amirmat98/Capacitive-Level-Meter-Sensor/Solid/CounterWeight/20210627_121346.jpg

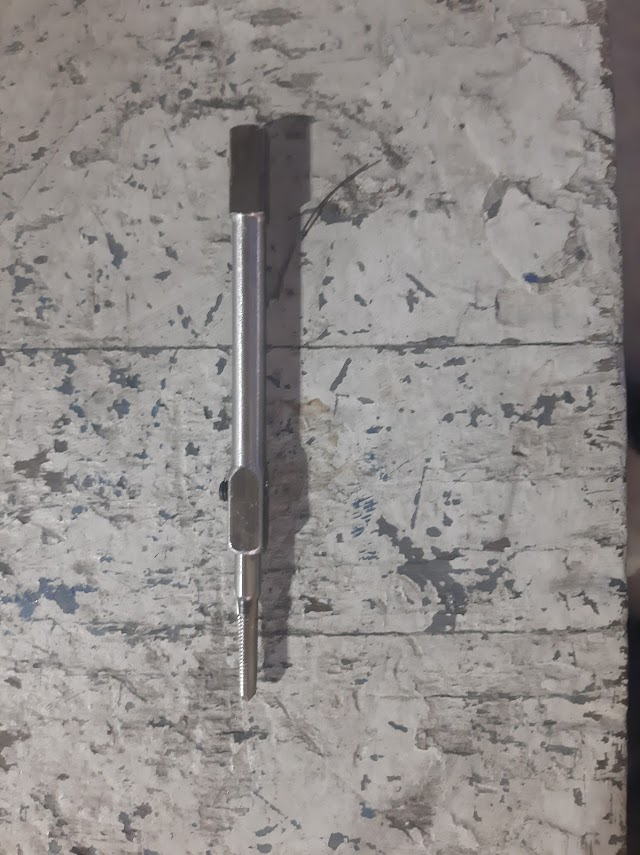
Solid/CounterWeight/20210627_121346.jpg
