amirmat98/Capacitive-Level-Meter-Sensor/README.md

# Capacitive-Level-Meter-Sensor
Design and Implementation of Capacitive Level Meter Sensor - Bachelor's thesis
