amirmat98/Capacitive-Level-Meter-Sensor/Solid/CounterWeight/Untitled-1.png

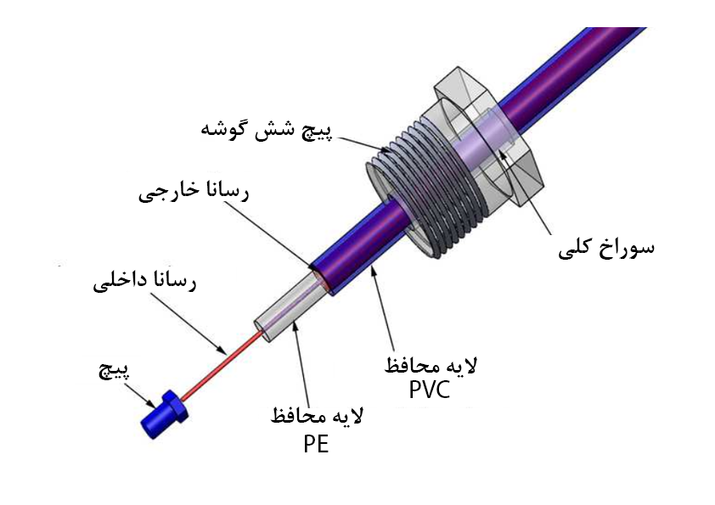
Solid/CounterWeight/Untitled-1.png
