amirmat98/Capacitive-Level-Meter-Sensor/Solid/CounterWeight/Untitled-2.png

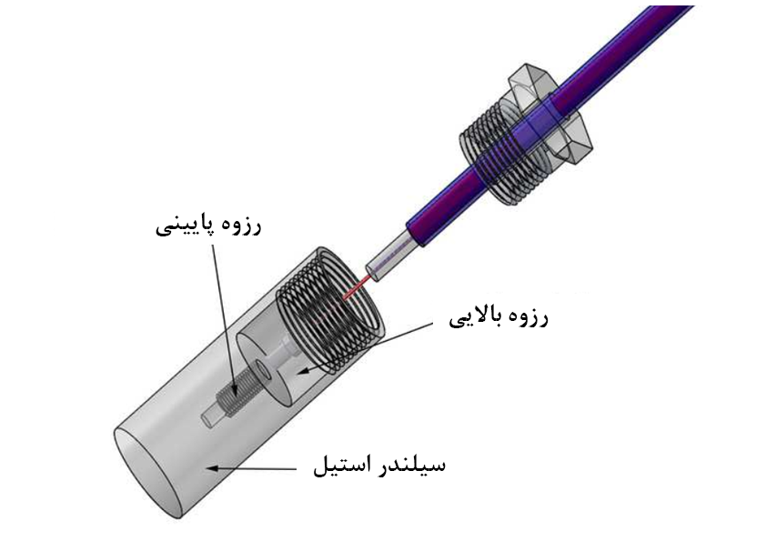
Solid/CounterWeight/Untitled-2.png
