amirmat98/Capacitive-Level-Meter-Sensor/Solid/CounterWeight/Untitled-3.png

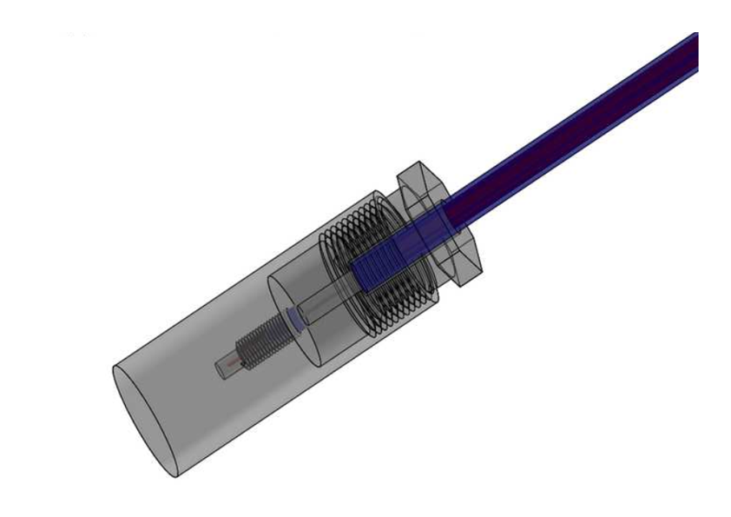
Solid/CounterWeight/Untitled-3.png
