amirmat98/Capacitive-Level-Meter-Sensor/Main_PCB_V1/Project Outputs for Main_PCB/BOM/PCB4.png

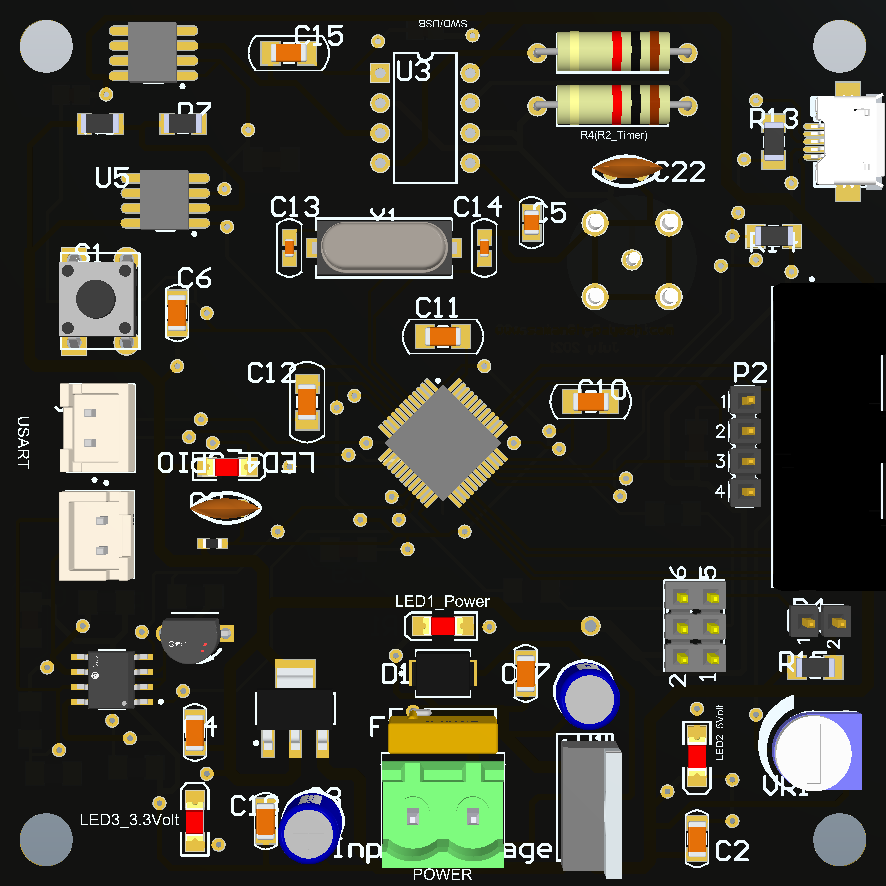
Main_PCB_V1/Project Outputs for Main_PCB/BOM/PCB4.png
