amirmat98/Capacitive-Level-Meter-Sensor/Solid/CounterWeight/Assem.SLDASM

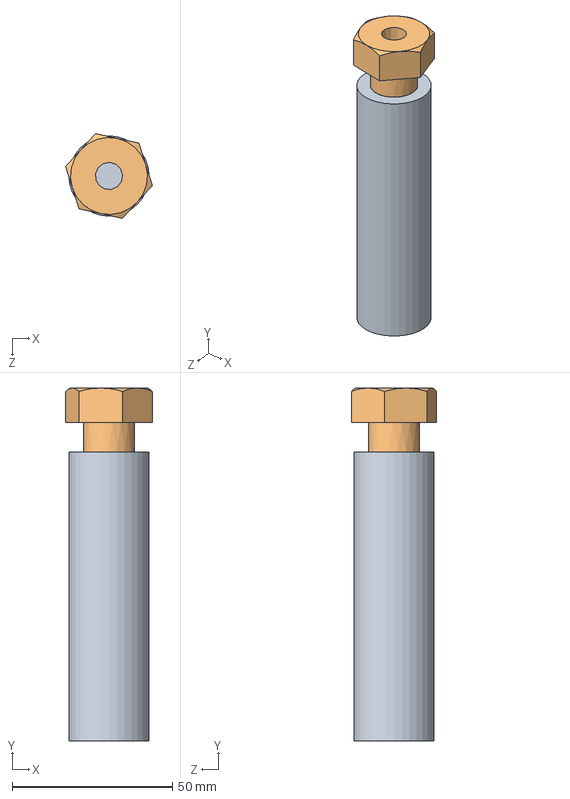
[picture p6: CAD file, 2024-11-14]
Solid/CounterWeight/Assem.SLDASM
27.1 x 110.0 x 26.4 mm
Screw
