amirmat98/Capacitive-Level-Meter-Sensor/Solid/3D_Print_Case/Body-version2.STEP

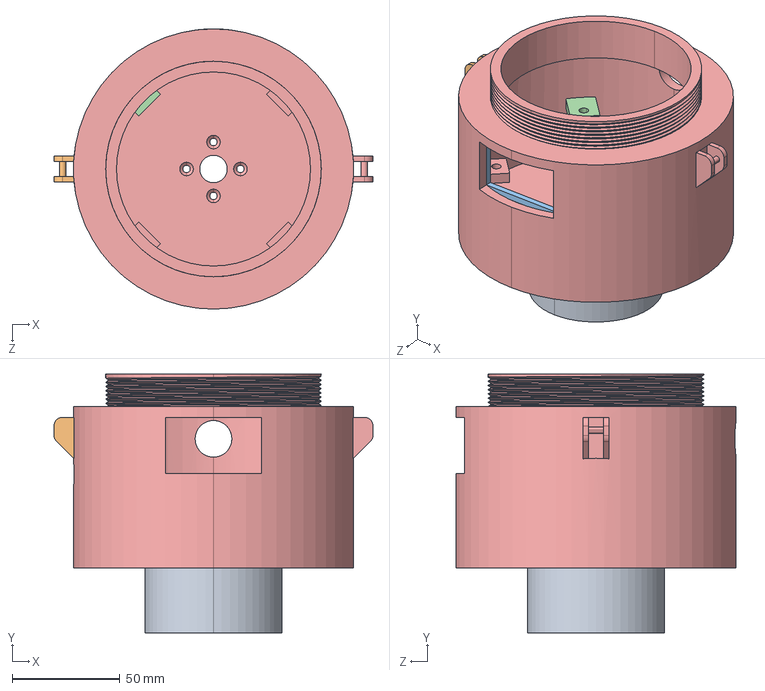
[picture p7: CAD file, 2024-11-14]
Solid/3D_Print_Case/Body-version2.STEP
148.0 x 120.0 x 130.0 mm
