amirmat98/Capacitive-Level-Meter-Sensor/Solid/CounterWeight/Body.SLDPRT

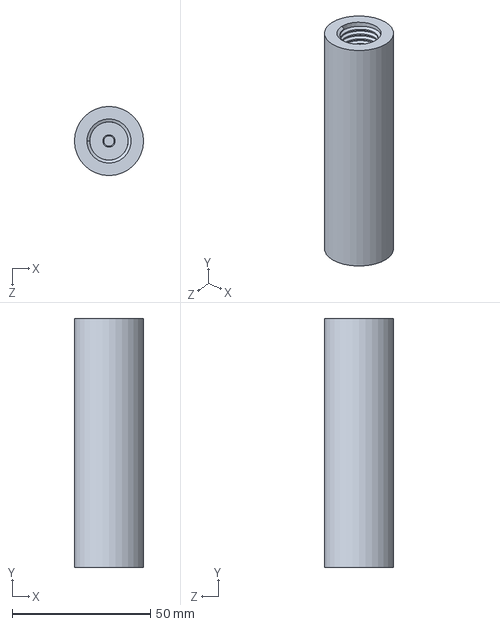
[picture p8: CAD file, 2024-11-14]
Solid/CounterWeight/Body.SLDPRT
25.0 x 90.0 x 25.0 mm
