amirmat98/Capacitive-Level-Meter-Sensor/Solid/3D_Print_Case/BodyCap-version2.STEP

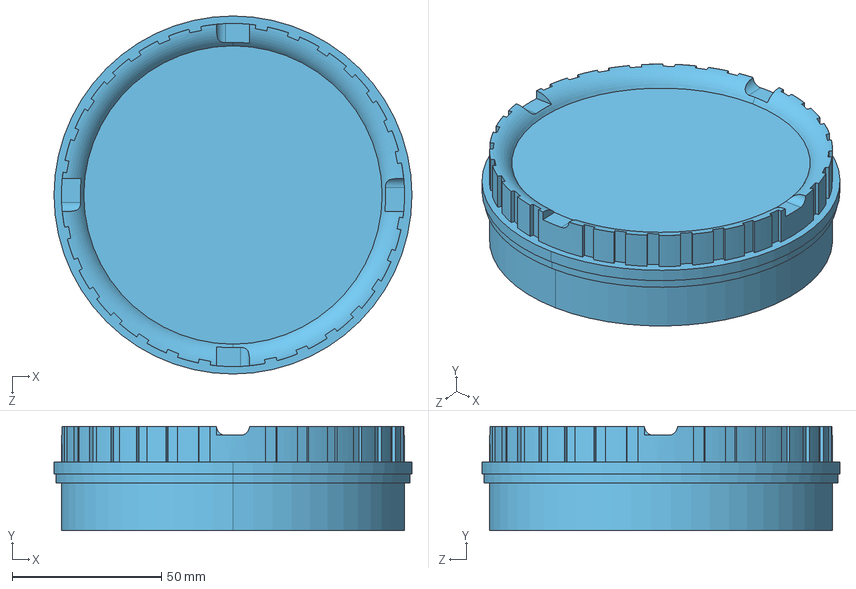
[picture p9: CAD file, 2024-11-14]
Solid/3D_Print_Case/BodyCap-version2.STEP
120.0 x 35.0 x 120.0 mm
