amirmat98/Capacitive-Level-Meter-Sensor/Solid/CounterWeight/Screw.SLDPRT

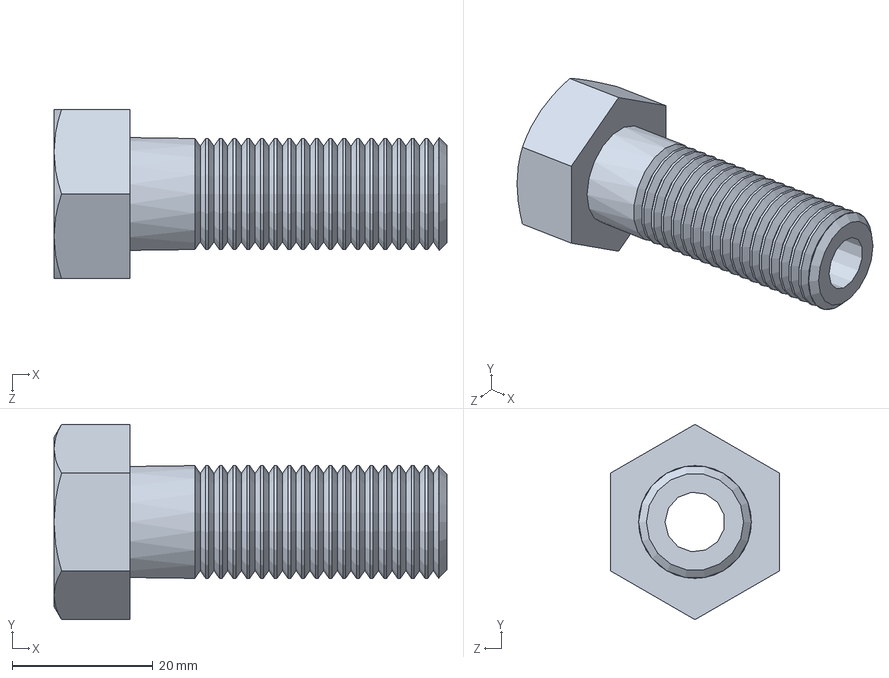
[picture p10: CAD file, 2024-11-14]
Solid/CounterWeight/Screw.SLDPRT
55.8 x 27.7 x 24.0 mm
