amirmat98/Capacitive-Level-Meter-Sensor/Solid/CounterWeight/Hex_Bolt.SLDPRT

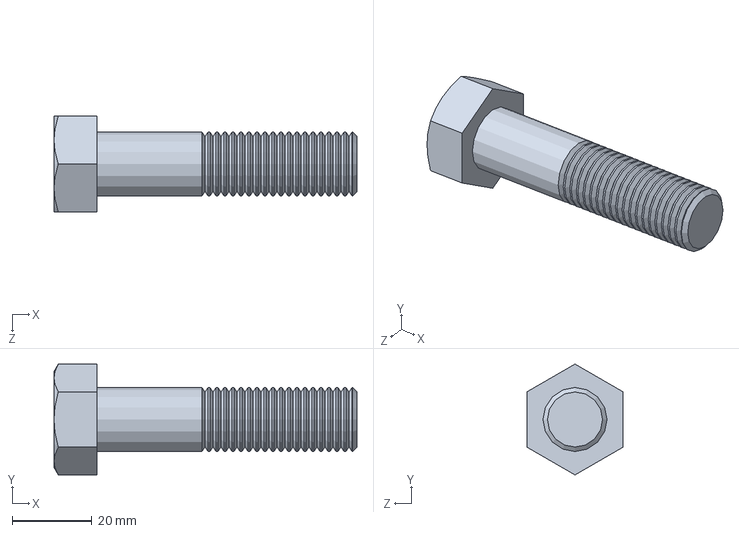
[picture p11: CAD file, 2024-11-14]
Solid/CounterWeight/Hex_Bolt.SLDPRT
75.8 x 27.7 x 24.0 mm
