amirmat98/Capacitive-Level-Meter-Sensor/(list of files, cad)

Other CAD files:
Solid/3D_Print_Case/Body-version2.SLDDRW
Solid/3D_Print_Case/Body-version2.SLDPRT
Solid/3D_Print_Case/Body-version2.STL
Solid/3D_Print_Case/BodyCap-version2.SLDDRW
Solid/3D_Print_Case/BodyCap-version2.SLDPRT
Solid/3D_Print_Case/BodyCap-version2.STL
Solid/CounterWeight/Body.SLDDRW
Solid/CounterWeight/Screw.SLDDRW
