amirmat98/Capacitive-Level-Meter-Sensor/ARM_code/Main_Test/MDK-ARM/Main_Test/Main_Test.htm

# Static Call Graph for image Main_Test\Main_Test.axf

#<CALLGRAPH># ARM Linker, 5060960: Last Updated: Sun Aug 01 12:32:45 2021

### Maximum Stack Usage = 136 bytes + Unknown(Cycles, Untraceable Function Pointers)

### Call chain for Maximum Stack Depth:

main ⇒ SystemClock_Config ⇒ HAL_RCC_ClockConfig ⇒ HAL_InitTick ⇒ HAL_NVIC_SetPriority

### Mutually Recursive functions

- ADC1_2_IRQHandler ⇒ ADC1_2_IRQHandler
- BusFault_Handler ⇒ BusFault_Handler
- HardFault_Handler ⇒ HardFault_Handler
- MemManage_Handler ⇒ MemManage_Handler
- NMI_Handler ⇒ NMI_Handler
- UsageFault_Handler ⇒ UsageFault_Handler
- qsort ⇒ qsort

### Function Pointers

- ADC1_2_IRQHandler from startup_stm32f103xb.o(.text) referenced from startup_stm32f103xb.o(RESET)
- BusFault_Handler from stm32f1xx_it.o(i.BusFault_Handler) referenced from startup_stm32f103xb.o(RESET)
- CAN1_RX1_IRQHandler from startup_stm32f103xb.o(.text) referenced from startup_stm32f103xb.o(RESET)
- CAN1_SCE_IRQHandler from startup_stm32f103xb.o(.text) referenced from startup_stm32f103xb.o(RESET)
- DMA1_Channel1_IRQHandler from startup_stm32f103xb.o(.text) referenced from startup_stm32f103xb.o(RESET)
- DMA1_Channel2_IRQHandler from startup_stm32f103xb.o(.text) referenced from startup_stm32f103xb.o(RESET)
- DMA1_Channel3_IRQHandler from startup_stm32f103xb.o(.text) referenced from startup_stm32f103xb.o(RESET)
- DMA1_Channel4_IRQHandler from startup_stm32f103xb.o(.text) referenced from startup_stm32f103xb.o(RESET)
- DMA1_Channel5_IRQHandler from startup_stm32f103xb.o(.text) referenced from startup_stm32f103xb.o(RESET)
- DMA1_Channel6_IRQHandler from startup_stm32f103xb.o(.text) referenced from startup_stm32f103xb.o(RESET)
- DMA1_Channel7_IRQHandler from startup_stm32f103xb.o(.text) referenced from startup_stm32f103xb.o(RESET)
- DebugMon_Handler from stm32f1xx_it.o(i.DebugMon_Handler) referenced from startup_stm32f103xb.o(RESET)
- EXTI0_IRQHandler from startup_stm32f103xb.o(.text) referenced from startup_stm32f103xb.o(RESET)
- EXTI15_10_IRQHandler from startup_stm32f103xb.o(.text) referenced from startup_stm32f103xb.o(RESET)
- EXTI1_IRQHandler from startup_stm32f103xb.o(.text) referenced from startup_stm32f103xb.o(RESET)
- EXTI2_IRQHandler from startup_stm32f103xb.o(.text) referenced from startup_stm32f103xb.o(RESET)
- EXTI3_IRQHandler from startup_stm32f103xb.o(.text) referenced from startup_stm32f103xb.o(RESET)
- EXTI4_IRQHandler from startup_stm32f103xb.o(.text) referenced from startup_stm32f103xb.o(RESET)
- EXTI9_5_IRQHandler from startup_stm32f103xb.o(.text) referenced from startup_stm32f103xb.o(RESET)
- FLASH_IRQHandler from startup_stm32f103xb.o(.text) referenced from startup_stm32f103xb.o(RESET)
- HardFault_Handler from stm32f1xx_it.o(i.HardFault_Handler) referenced from startup_stm32f103xb.o(RESET)
- I2C1_ER_IRQHandler from startup_stm32f103xb.o(.text) referenced from startup_stm32f103xb.o(RESET)
- I2C1_EV_IRQHandler from startup_stm32f103xb.o(.text) referenced from startup_stm32f103xb.o(RESET)
- I2C2_ER_IRQHandler from startup_stm32f103xb.o(.text) referenced from startup_stm32f103xb.o(RESET)
- I2C2_EV_IRQHandler from startup_stm32f103xb.o(.text) referenced from startup_stm32f103xb.o(RESET)
- MemManage_Handler from stm32f1xx_it.o(i.MemManage_Handler) referenced from startup_stm32f103xb.o(RESET)
- NMI_Handler from stm32f1xx_it.o(i.NMI_Handler) referenced from startup_stm32f103xb.o(RESET)
- PVD_IRQHandler from startup_stm32f103xb.o(.text) referenced from startup_stm32f103xb.o(RESET)
- PendSV_Handler from stm32f1xx_it.o(i.PendSV_Handler) referenced from startup_stm32f103xb.o(RESET)
- RCC_IRQHandler from startup_stm32f103xb.o(.text) referenced from startup_stm32f103xb.o(RESET)
- RTC_Alarm_IRQHandler from startup_stm32f103xb.o(.text) referenced from startup_stm32f103xb.o(RESET)
- RTC_IRQHandler from startup_stm32f103xb.o(.text) referenced from startup_stm32f103xb.o(RESET)
- Reset_Handler from startup_stm32f103xb.o(.text) referenced from startup_stm32f103xb.o(RESET)
- SPI1_IRQHandler from startup_stm32f103xb.o(.text) referenced from startup_stm32f103xb.o(RESET)
- SPI2_IRQHandler from startup_stm32f103xb.o(.text) referenced from startup_stm32f103xb.o(RESET)
- SVC_Handler from stm32f1xx_it.o(i.SVC_Handler) referenced from startup_stm32f103xb.o(RESET)
- SysTick_Handler from stm32f1xx_it.o(i.SysTick_Handler) referenced from startup_stm32f103xb.o(RESET)
- SystemInit from system_stm32f1xx.o(i.SystemInit) referenced from startup_stm32f103xb.o(.text)
- TAMPER_IRQHandler from startup_stm32f103xb.o(.text) referenced from startup_stm32f103xb.o(RESET)
- TIM1_BRK_IRQHandler from startup_stm32f103xb.o(.text) referenced from startup_stm32f103xb.o(RESET)
- TIM1_CC_IRQHandler from startup_stm32f103xb.o(.text) referenced from startup_stm32f103xb.o(RESET)
- TIM1_TRG_COM_IRQHandler from startup_stm32f103xb.o(.text) referenced from startup_stm32f103xb.o(RESET)
- TIM1_UP_IRQHandler from startup_stm32f103xb.o(.text) referenced from startup_stm32f103xb.o(RESET)
- TIM2_IRQHandler from stm32f1xx_it.o(i.TIM2_IRQHandler) referenced from startup_stm32f103xb.o(RESET)
- TIM3_IRQHandler from startup_stm32f103xb.o(.text) referenced from startup_stm32f103xb.o(RESET)
- TIM4_IRQHandler from startup_stm32f103xb.o(.text) referenced from startup_stm32f103xb.o(RESET)
- USART1_IRQHandler from startup_stm32f103xb.o(.text) referenced from startup_stm32f103xb.o(RESET)
- USART2_IRQHandler from startup_stm32f103xb.o(.text) referenced from startup_stm32f103xb.o(RESET)
- USART3_IRQHandler from startup_stm32f103xb.o(.text) referenced from startup_stm32f103xb.o(RESET)
- USBWakeUp_IRQHandler from startup_stm32f103xb.o(.text) referenced from startup_stm32f103xb.o(RESET)
- USB_HP_CAN1_TX_IRQHandler from startup_stm32f103xb.o(.text) referenced from startup_stm32f103xb.o(RESET)
- USB_LP_CAN1_RX0_IRQHandler from startup_stm32f103xb.o(.text) referenced from startup_stm32f103xb.o(RESET)
- UsageFault_Handler from stm32f1xx_it.o(i.UsageFault_Handler) referenced from startup_stm32f103xb.o(RESET)
- WWDG_IRQHandler from startup_stm32f103xb.o(.text) referenced from startup_stm32f103xb.o(RESET)
- __main from entry.o(.ARM.Collect$$$$00000000) referenced from startup_stm32f103xb.o(.text)
- cmpfunc from main.o(i.cmpfunc) referenced from main.o(i.main)
- fputc from main.o(i.fputc) referenced from printfa.o(i.__0printf)
- main from main.o(i.main) referenced from entry9a.o(.ARM.Collect$$$$0000000B)

### Global Symbols

__main (Thumb, 0 bytes, Stack size unknown bytes, entry.o(.ARM.Collect$$$$00000000))
[Address Reference Count : 1]

- startup_stm32f103xb.o(.text)

_main_stk (Thumb, 0 bytes, Stack size unknown bytes, entry2.o(.ARM.Collect$$$$00000001))

_main_scatterload (Thumb, 0 bytes, Stack size unknown bytes, entry5.o(.ARM.Collect$$$$00000004))

[Calls]

- >> __scatterload

__main_after_scatterload (Thumb, 0 bytes, Stack size unknown bytes, entry5.o(.ARM.Collect$$$$00000004))

[Called By]

- >> __scatterload

_main_clock (Thumb, 0 bytes, Stack size unknown bytes, entry7b.o(.ARM.Collect$$$$00000008))

_main_cpp_init (Thumb, 0 bytes, Stack size unknown bytes, entry8b.o(.ARM.Collect$$$$0000000A))

_main_init (Thumb, 0 bytes, Stack size unknown bytes, entry9a.o(.ARM.Collect$$$$0000000B))

__rt_lib_shutdown_fini (Thumb, 0 bytes, Stack size unknown bytes, entry12b.o(.ARM.Collect$$$$0000000E))

__rt_final_cpp (Thumb, 0 bytes, Stack size unknown bytes, entry10a.o(.ARM.Collect$$$$0000000F))

__rt_final_exit (Thumb, 0 bytes, Stack size unknown bytes, entry11a.o(.ARM.Collect$$$$00000011))

Reset_Handler (Thumb, 8 bytes, Stack size 0 bytes, startup_stm32f103xb.o(.text))
[Address Reference Count : 1]

- startup_stm32f103xb.o(RESET)

ADC1_2_IRQHandler (Thumb, 0 bytes, Stack size 0 bytes, startup_stm32f103xb.o(.text))

[Calls]

- >> ADC1_2_IRQHandler

[Called By]

- >> ADC1_2_IRQHandler

[Address Reference Count : 1]

- startup_stm32f103xb.o(RESET)

CAN1_RX1_IRQHandler (Thumb, 0 bytes, Stack size 0 bytes, startup_stm32f103xb.o(.text))
[Address Reference Count : 1]

- startup_stm32f103xb.o(RESET)

CAN1_SCE_IRQHandler (Thumb, 0 bytes, Stack size 0 bytes, startup_stm32f103xb.o(.text))
[Address Reference Count : 1]

- startup_stm32f103xb.o(RESET)

DMA1_Channel1_IRQHandler (Thumb, 0 bytes, Stack size 0 bytes, startup_stm32f103xb.o(.text))
[Address Reference Count : 1]

- startup_stm32f103xb.o(RESET)

DMA1_Channel2_IRQHandler (Thumb, 0 bytes, Stack size 0 bytes, startup_stm32f103xb.o(.text))
[Address Reference Count : 1]

- startup_stm32f103xb.o(RESET)

DMA1_Channel3_IRQHandler (Thumb, 0 bytes, Stack size 0 bytes, startup_stm32f103xb.o(.text))
[Address Reference Count : 1]

- startup_stm32f103xb.o(RESET)

DMA1_Channel4_IRQHandler (Thumb, 0 bytes, Stack size 0 bytes, startup_stm32f103xb.o(.text))
[Address Reference Count : 1]

- startup_stm32f103xb.o(RESET)

DMA1_Channel5_IRQHandler (Thumb, 0 bytes, Stack size 0 bytes, startup_stm32f103xb.o(.text))
[Address Reference Count : 1]

- startup_stm32f103xb.o(RESET)

DMA1_Channel6_IRQHandler (Thumb, 0 bytes, Stack size 0 bytes, startup_stm32f103xb.o(.text))
[Address Reference Count : 1]

- startup_stm32f103xb.o(RESET)

DMA1_Channel7_IRQHandler (Thumb, 0 bytes, Stack size 0 bytes, startup_stm32f103xb.o(.text))
[Address Reference Count : 1]

- startup_stm32f103xb.o(RESET)

EXTI0_IRQHandler (Thumb, 0 bytes, Stack size 0 bytes, startup_stm32f103xb.o(.text))
[Address Reference Count : 1]

- startup_stm32f103xb.o(RESET)

EXTI15_10_IRQHandler (Thumb, 0 bytes, Stack size 0 bytes, startup_stm32f103xb.o(.text))
[Address Reference Count : 1]

- startup_stm32f103xb.o(RESET)

EXTI1_IRQHandler (Thumb, 0 bytes, Stack size 0 bytes, startup_stm32f103xb.o(.text))
[Address Reference Count : 1]

- startup_stm32f103xb.o(RESET)

EXTI2_IRQHandler (Thumb, 0 bytes, Stack size 0 bytes, startup_stm32f103xb.o(.text))
[Address Reference Count : 1]

- startup_stm32f103xb.o(RESET)

EXTI3_IRQHandler (Thumb, 0 bytes, Stack size 0 bytes, startup_stm32f103xb.o(.text))
[Address Reference Count : 1]

- startup_stm32f103xb.o(RESET)

EXTI4_IRQHandler (Thumb, 0 bytes, Stack size 0 bytes, startup_stm32f103xb.o(.text))
[Address Reference Count : 1]

- startup_stm32f103xb.o(RESET)

EXTI9_5_IRQHandler (Thumb, 0 bytes, Stack size 0 bytes, startup_stm32f103xb.o(.text))
[Address Reference Count : 1]

- startup_stm32f103xb.o(RESET)

FLASH_IRQHandler (Thumb, 0 bytes, Stack size 0 bytes, startup_stm32f103xb.o(.text))
[Address Reference Count : 1]

- startup_stm32f103xb.o(RESET)

I2C1_ER_IRQHandler (Thumb, 0 bytes, Stack size 0 bytes, startup_stm32f103xb.o(.text))
[Address Reference Count : 1]

- startup_stm32f103xb.o(RESET)

I2C1_EV_IRQHandler (Thumb, 0 bytes, Stack size 0 bytes, startup_stm32f103xb.o(.text))
[Address Reference Count : 1]

- startup_stm32f103xb.o(RESET)

I2C2_ER_IRQHandler (Thumb, 0 bytes, Stack size 0 bytes, startup_stm32f103xb.o(.text))
[Address Reference Count : 1]

- startup_stm32f103xb.o(RESET)

I2C2_EV_IRQHandler (Thumb, 0 bytes, Stack size 0 bytes, startup_stm32f103xb.o(.text))
[Address Reference Count : 1]

- startup_stm32f103xb.o(RESET)

PVD_IRQHandler (Thumb, 0 bytes, Stack size 0 bytes, startup_stm32f103xb.o(.text))
[Address Reference Count : 1]

- startup_stm32f103xb.o(RESET)

RCC_IRQHandler (Thumb, 0 bytes, Stack size 0 bytes, startup_stm32f103xb.o(.text))
[Address Reference Count : 1]

- startup_stm32f103xb.o(RESET)

RTC_Alarm_IRQHandler (Thumb, 0 bytes, Stack size 0 bytes, startup_stm32f103xb.o(.text))
[Address Reference Count : 1]

- startup_stm32f103xb.o(RESET)

RTC_IRQHandler (Thumb, 0 bytes, Stack size 0 bytes, startup_stm32f103xb.o(.text))
[Address Reference Count : 1]

- startup_stm32f103xb.o(RESET)

SPI1_IRQHandler (Thumb, 0 bytes, Stack size 0 bytes, startup_stm32f103xb.o(.text))
[Address Reference Count : 1]

- startup_stm32f103xb.o(RESET)

SPI2_IRQHandler (Thumb, 0 bytes, Stack size 0 bytes, startup_stm32f103xb.o(.text))
[Address Reference Count : 1]

- startup_stm32f103xb.o(RESET)

TAMPER_IRQHandler (Thumb, 0 bytes, Stack size 0 bytes, startup_stm32f103xb.o(.text))
[Address Reference Count : 1]

- startup_stm32f103xb.o(RESET)

TIM1_BRK_IRQHandler (Thumb, 0 bytes, Stack size 0 bytes, startup_stm32f103xb.o(.text))
[Address Reference Count : 1]

- startup_stm32f103xb.o(RESET)

TIM1_CC_IRQHandler (Thumb, 0 bytes, Stack size 0 bytes, startup_stm32f103xb.o(.text))
[Address Reference Count : 1]

- startup_stm32f103xb.o(RESET)

TIM1_TRG_COM_IRQHandler (Thumb, 0 bytes, Stack size 0 bytes, startup_stm32f103xb.o(.text))
[Address Reference Count : 1]

- startup_stm32f103xb.o(RESET)

TIM1_UP_IRQHandler (Thumb, 0 bytes, Stack size 0 bytes, startup_stm32f103xb.o(.text))
[Address Reference Count : 1]

- startup_stm32f103xb.o(RESET)

TIM3_IRQHandler (Thumb, 0 bytes, Stack size 0 bytes, startup_stm32f103xb.o(.text))
[Address Reference Count : 1]

- startup_stm32f103xb.o(RESET)

TIM4_IRQHandler (Thumb, 0 bytes, Stack size 0 bytes, startup_stm32f103xb.o(.text))
[Address Reference Count : 1]

- startup_stm32f103xb.o(RESET)

USART1_IRQHandler (Thumb, 0 bytes, Stack size 0 bytes, startup_stm32f103xb.o(.text))
[Address Reference Count : 1]

- startup_stm32f103xb.o(RESET)

USART2_IRQHandler (Thumb, 0 bytes, Stack size 0 bytes, startup_stm32f103xb.o(.text))
[Address Reference Count : 1]

- startup_stm32f103xb.o(RESET)

USART3_IRQHandler (Thumb, 0 bytes, Stack size 0 bytes, startup_stm32f103xb.o(.text))
[Address Reference Count : 1]

- startup_stm32f103xb.o(RESET)

USBWakeUp_IRQHandler (Thumb, 0 bytes, Stack size 0 bytes, startup_stm32f103xb.o(.text))
[Address Reference Count : 1]

- startup_stm32f103xb.o(RESET)

USB_HP_CAN1_TX_IRQHandler (Thumb, 0 bytes, Stack size 0 bytes, startup_stm32f103xb.o(.text))
[Address Reference Count : 1]

- startup_stm32f103xb.o(RESET)

USB_LP_CAN1_RX0_IRQHandler (Thumb, 0 bytes, Stack size 0 bytes, startup_stm32f103xb.o(.text))
[Address Reference Count : 1]

- startup_stm32f103xb.o(RESET)

WWDG_IRQHandler (Thumb, 0 bytes, Stack size 0 bytes, startup_stm32f103xb.o(.text))
[Address Reference Count : 1]

- startup_stm32f103xb.o(RESET)

__aeabi_llsr (Thumb, 32 bytes, Stack size 0 bytes, llushr.o(.text))

[Called By]

- >> __aeabi_uldivmod
- >> _double_epilogue
- >> __aeabi_d2ulz

_ll_ushift_r (Thumb, 0 bytes, Stack size 0 bytes, llushr.o(.text), UNUSED)

qsort (Thumb, 156 bytes, Stack size 40 bytes, qsort.o(.text))

[Stack]

- Max Depth = 40 + In Cycle
- Call Chain = qsort ⇒ qsort (Cycle)

[Calls]

- >> qsort

[Called By]

- >> main
- >> qsort

__aeabi_memset (Thumb, 14 bytes, Stack size 0 bytes, memseta.o(.text), UNUSED)

[Called By]

- >> _memset$wrapper
- >> __aeabi_memclr

__aeabi_memset4 (Thumb, 0 bytes, Stack size 0 bytes, memseta.o(.text), UNUSED)

__aeabi_memset8 (Thumb, 0 bytes, Stack size 0 bytes, memseta.o(.text), UNUSED)

__aeabi_memclr (Thumb, 4 bytes, Stack size 0 bytes, memseta.o(.text), UNUSED)

[Calls]

- >> __aeabi_memset

__aeabi_memclr4 (Thumb, 0 bytes, Stack size 0 bytes, memseta.o(.text))

[Called By]

- >> SystemClock_Config

__aeabi_memclr8 (Thumb, 0 bytes, Stack size 0 bytes, memseta.o(.text), UNUSED)

_memset$wrapper (Thumb, 18 bytes, Stack size 8 bytes, memseta.o(.text), UNUSED)

[Calls]

- >> __aeabi_memset

__aeabi_fadd (Thumb, 164 bytes, Stack size 16 bytes, fadd.o(.text))

[Stack]

- Max Depth = 20
- Call Chain = __aeabi_fadd ⇒ _float_epilogue

[Calls]

- >> _float_round
- >> _float_epilogue

[Called By]

- >> __aeabi_fsub
- >> __aeabi_frsub

__aeabi_fsub (Thumb, 6 bytes, Stack size 0 bytes, fadd.o(.text))

[Stack]

- Max Depth = 20
- Call Chain = __aeabi_fsub ⇒ __aeabi_fadd ⇒ _float_epilogue

[Calls]

- >> __aeabi_fadd

[Called By]

- >> Calc_Height

__aeabi_frsub (Thumb, 6 bytes, Stack size 0 bytes, fadd.o(.text), UNUSED)

[Calls]

- >> __aeabi_fadd

__aeabi_fmul (Thumb, 100 bytes, Stack size 8 bytes, fmul.o(.text))

[Stack]

- Max Depth = 8
- Call Chain = __aeabi_fmul

[Called By]

- >> Calc_Height

__aeabi_fdiv (Thumb, 124 bytes, Stack size 8 bytes, fdiv.o(.text))

[Stack]

- Max Depth = 8
- Call Chain = __aeabi_fdiv

[Calls]

- >> _float_round

[Called By]

- >> Calc_Height

__aeabi_ddiv (Thumb, 222 bytes, Stack size 32 bytes, ddiv.o(.text))

[Stack]

- Max Depth = 40
- Call Chain = __aeabi_ddiv ⇒ _double_round

[Calls]

- >> _double_round

[Called By]

- >> Calc_Cap
- >> _fp_digits

__aeabi_ui2d (Thumb, 26 bytes, Stack size 16 bytes, dfltui.o(.text))

[Stack]

- Max Depth = 56
- Call Chain = __aeabi_ui2d ⇒ _double_epilogue ⇒ _double_round

[Calls]

- >> _double_epilogue

[Called By]

- >> Calc_Cap

__aeabi_f2iz (Thumb, 50 bytes, Stack size 0 bytes, ffixi.o(.text))

[Called By]

- >> main

__aeabi_f2d (Thumb, 38 bytes, Stack size 0 bytes, f2d.o(.text))

[Called By]

- >> main

__aeabi_d2f (Thumb, 56 bytes, Stack size 8 bytes, d2f.o(.text))

[Stack]

- Max Depth = 8
- Call Chain = __aeabi_d2f

[Calls]

- >> _float_round

[Called By]

- >> Calc_Cap

__aeabi_uidiv (Thumb, 0 bytes, Stack size 12 bytes, uidiv.o(.text), UNUSED)

__aeabi_uidivmod (Thumb, 44 bytes, Stack size 12 bytes, uidiv.o(.text), UNUSED)

[Called By]

- >> _printf_core

__aeabi_uldivmod (Thumb, 98 bytes, Stack size 40 bytes, uldiv.o(.text), UNUSED)

[Calls]

- >> __aeabi_llsr
- >> __aeabi_llsl

[Called By]

- >> _printf_core
- >> _fp_digits

__I$use$fp (Thumb, 0 bytes, Stack size 0 bytes, iusefp.o(.text), UNUSED)

_float_round (Thumb, 18 bytes, Stack size 0 bytes, fepilogue.o(.text))

[Called By]

- >> __aeabi_fdiv
- >> __aeabi_d2f
- >> __aeabi_fadd

_float_epilogue (Thumb, 92 bytes, Stack size 4 bytes, fepilogue.o(.text))

[Stack]

- Max Depth = 4
- Call Chain = _float_epilogue

[Called By]

- >> __aeabi_fadd

_double_round (Thumb, 30 bytes, Stack size 8 bytes, depilogue.o(.text))

[Stack]

- Max Depth = 8
- Call Chain = _double_round

[Called By]

- >> __aeabi_ddiv
- >> _double_epilogue
- >> __aeabi_dadd

_double_epilogue (Thumb, 156 bytes, Stack size 32 bytes, depilogue.o(.text))

[Stack]

- Max Depth = 40
- Call Chain = _double_epilogue ⇒ _double_round

[Calls]

- >> __aeabi_llsr
- >> __aeabi_llsl
- >> _double_round

[Called By]

- >> __aeabi_ui2d
- >> __aeabi_dmul
- >> __aeabi_dadd

__aeabi_dadd (Thumb, 322 bytes, Stack size 48 bytes, dadd.o(.text), UNUSED)

[Calls]

- >> __aeabi_lasr
- >> __aeabi_llsl
- >> _double_epilogue
- >> _double_round

[Called By]

- >> __aeabi_drsub
- >> __aeabi_dsub
- >> _fp_digits

__aeabi_dsub (Thumb, 6 bytes, Stack size 0 bytes, dadd.o(.text), UNUSED)

[Calls]

- >> __aeabi_dadd

__aeabi_drsub (Thumb, 6 bytes, Stack size 0 bytes, dadd.o(.text), UNUSED)

[Calls]

- >> __aeabi_dadd

__aeabi_dmul (Thumb, 228 bytes, Stack size 48 bytes, dmul.o(.text), UNUSED)

[Calls]

- >> _double_epilogue

[Called By]

- >> _fp_digits

__aeabi_d2ulz (Thumb, 48 bytes, Stack size 0 bytes, dfixul.o(.text), UNUSED)

[Calls]

- >> __aeabi_llsr
- >> __aeabi_llsl

[Called By]

- >> _fp_digits

__aeabi_cdrcmple (Thumb, 48 bytes, Stack size 0 bytes, cdrcmple.o(.text), UNUSED)

[Called By]

- >> _fp_digits

__scatterload (Thumb, 28 bytes, Stack size 0 bytes, init.o(.text))

[Calls]

- >> __main_after_scatterload

[Called By]

- >> _main_scatterload

__scatterload_rt2 (Thumb, 0 bytes, Stack size 0 bytes, init.o(.text), UNUSED)

__aeabi_llsl (Thumb, 30 bytes, Stack size 0 bytes, llshl.o(.text))

[Called By]

- >> __aeabi_uldivmod
- >> _double_epilogue
- >> __aeabi_dadd
- >> __aeabi_d2ulz

_ll_shift_l (Thumb, 0 bytes, Stack size 0 bytes, llshl.o(.text), UNUSED)

__aeabi_lasr (Thumb, 36 bytes, Stack size 0 bytes, llsshr.o(.text), UNUSED)

[Called By]

- >> __aeabi_dadd

_ll_sshift_r (Thumb, 0 bytes, Stack size 0 bytes, llsshr.o(.text), UNUSED)

BusFault_Handler (Thumb, 2 bytes, Stack size 0 bytes, stm32f1xx_it.o(i.BusFault_Handler))

[Calls]

- >> BusFault_Handler

[Called By]

- >> BusFault_Handler

[Address Reference Count : 1]

- startup_stm32f103xb.o(RESET)

Calc_Cap (Thumb, 32 bytes, Stack size 8 bytes, main.o(i.Calc_Cap))

[Stack]

- Max Depth = 64
- Call Chain = Calc_Cap ⇒ __aeabi_ui2d ⇒ _double_epilogue ⇒ _double_round

[Calls]

- >> __aeabi_ui2d
- >> __aeabi_ddiv
- >> __aeabi_d2f

[Called By]

- >> main

Calc_Height (Thumb, 30 bytes, Stack size 8 bytes, main.o(i.Calc_Height))

[Stack]

- Max Depth = 28
- Call Chain = Calc_Height ⇒ __aeabi_fsub ⇒ __aeabi_fadd ⇒ _float_epilogue

[Calls]

- >> __aeabi_fsub
- >> __aeabi_fmul
- >> __aeabi_fdiv

[Called By]

- >> main

DebugMon_Handler (Thumb, 2 bytes, Stack size 0 bytes, stm32f1xx_it.o(i.DebugMon_Handler))
[Address Reference Count : 1]

- startup_stm32f103xb.o(RESET)

HAL_Delay (Thumb, 32 bytes, Stack size 16 bytes, stm32f1xx_hal.o(i.HAL_Delay))

[Stack]

- Max Depth = 16
- Call Chain = HAL_Delay

[Calls]

- >> HAL_GetTick

[Called By]

- >> main

HAL_GPIO_Init (Thumb, 446 bytes, Stack size 40 bytes, stm32f1xx_hal_gpio.o(i.HAL_GPIO_Init))

[Stack]

- Max Depth = 40
- Call Chain = HAL_GPIO_Init

[Called By]

- >> HAL_UART_MspInit
- >> HAL_TIM_Base_MspInit
- >> MX_GPIO_Init

HAL_GPIO_TogglePin (Thumb, 16 bytes, Stack size 0 bytes, stm32f1xx_hal_gpio.o(i.HAL_GPIO_TogglePin))

[Called By]

- >> main

HAL_GPIO_WritePin (Thumb, 10 bytes, Stack size 0 bytes, stm32f1xx_hal_gpio.o(i.HAL_GPIO_WritePin))

[Called By]

- >> MX_GPIO_Init

HAL_GetTick (Thumb, 6 bytes, Stack size 0 bytes, stm32f1xx_hal.o(i.HAL_GetTick))

[Called By]

- >> HAL_UART_Transmit
- >> HAL_RCC_OscConfig
- >> HAL_RCC_ClockConfig
- >> HAL_Delay
- >> UART_WaitOnFlagUntilTimeout

HAL_IncTick (Thumb, 12 bytes, Stack size 0 bytes, stm32f1xx_hal.o(i.HAL_IncTick))

[Called By]

- >> SysTick_Handler

HAL_Init (Thumb, 32 bytes, Stack size 8 bytes, stm32f1xx_hal.o(i.HAL_Init))

[Stack]

- Max Depth = 40
- Call Chain = HAL_Init ⇒ HAL_InitTick ⇒ HAL_NVIC_SetPriority

[Calls]

- >> HAL_MspInit
- >> HAL_InitTick
- >> HAL_NVIC_SetPriorityGrouping

[Called By]

- >> main

HAL_InitTick (Thumb, 54 bytes, Stack size 16 bytes, stm32f1xx_hal.o(i.HAL_InitTick))

[Stack]

- Max Depth = 32
- Call Chain = HAL_InitTick ⇒ HAL_NVIC_SetPriority

[Calls]

- >> HAL_NVIC_SetPriority
- >> HAL_SYSTICK_Config

[Called By]

- >> HAL_RCC_ClockConfig
- >> HAL_Init

HAL_MspInit (Thumb, 52 bytes, Stack size 8 bytes, stm32f1xx_hal_msp.o(i.HAL_MspInit))

[Stack]

- Max Depth = 8
- Call Chain = HAL_MspInit

[Called By]

- >> HAL_Init

HAL_NVIC_EnableIRQ (Thumb, 26 bytes, Stack size 0 bytes, stm32f1xx_hal_cortex.o(i.HAL_NVIC_EnableIRQ))

[Called By]

- >> HAL_TIM_Base_MspInit

HAL_NVIC_SetPriority (Thumb, 60 bytes, Stack size 16 bytes, stm32f1xx_hal_cortex.o(i.HAL_NVIC_SetPriority))

[Stack]

- Max Depth = 16
- Call Chain = HAL_NVIC_SetPriority

[Calls]

- >> __NVIC_SetPriority

[Called By]

- >> HAL_TIM_Base_MspInit
- >> HAL_InitTick

HAL_NVIC_SetPriorityGrouping (Thumb, 26 bytes, Stack size 0 bytes, stm32f1xx_hal_cortex.o(i.HAL_NVIC_SetPriorityGrouping))

[Called By]

- >> HAL_Init

HAL_RCC_ClockConfig (Thumb, 280 bytes, Stack size 32 bytes, stm32f1xx_hal_rcc.o(i.HAL_RCC_ClockConfig))

[Stack]

- Max Depth = 64
- Call Chain = HAL_RCC_ClockConfig ⇒ HAL_InitTick ⇒ HAL_NVIC_SetPriority

[Calls]

- >> HAL_RCC_GetSysClockFreq
- >> HAL_InitTick
- >> HAL_GetTick

[Called By]

- >> SystemClock_Config

HAL_RCC_GetPCLK1Freq (Thumb, 20 bytes, Stack size 0 bytes, stm32f1xx_hal_rcc.o(i.HAL_RCC_GetPCLK1Freq))

[Called By]

- >> UART_SetConfig

HAL_RCC_GetPCLK2Freq (Thumb, 20 bytes, Stack size 0 bytes, stm32f1xx_hal_rcc.o(i.HAL_RCC_GetPCLK2Freq))

[Called By]

- >> UART_SetConfig

HAL_RCC_GetSysClockFreq (Thumb, 74 bytes, Stack size 20 bytes, stm32f1xx_hal_rcc.o(i.HAL_RCC_GetSysClockFreq))

[Stack]

- Max Depth = 20
- Call Chain = HAL_RCC_GetSysClockFreq

[Called By]

- >> HAL_RCC_ClockConfig

HAL_RCC_OscConfig (Thumb, 778 bytes, Stack size 40 bytes, stm32f1xx_hal_rcc.o(i.HAL_RCC_OscConfig))

[Stack]

- Max Depth = 40
- Call Chain = HAL_RCC_OscConfig

[Calls]

- >> HAL_GetTick

[Called By]

- >> SystemClock_Config

HAL_SYSTICK_Config (Thumb, 40 bytes, Stack size 8 bytes, stm32f1xx_hal_cortex.o(i.HAL_SYSTICK_Config))

[Stack]

- Max Depth = 8
- Call Chain = HAL_SYSTICK_Config

[Calls]

- >> __NVIC_SetPriority

[Called By]

- >> HAL_InitTick

HAL_TIMEx_BreakCallback (Thumb, 2 bytes, Stack size 0 bytes, stm32f1xx_hal_tim_ex.o(i.HAL_TIMEx_BreakCallback))

[Called By]

- >> HAL_TIM_IRQHandler

HAL_TIMEx_CommutCallback (Thumb, 2 bytes, Stack size 0 bytes, stm32f1xx_hal_tim_ex.o(i.HAL_TIMEx_CommutCallback))

[Called By]

- >> HAL_TIM_IRQHandler

HAL_TIMEx_MasterConfigSynchronization (Thumb, 92 bytes, Stack size 16 bytes, stm32f1xx_hal_tim_ex.o(i.HAL_TIMEx_MasterConfigSynchronization))

[Stack]

- Max Depth = 16
- Call Chain = HAL_TIMEx_MasterConfigSynchronization

[Called By]

- >> MX_TIM2_Init

HAL_TIM_Base_Init (Thumb, 90 bytes, Stack size 8 bytes, stm32f1xx_hal_tim.o(i.HAL_TIM_Base_Init))

[Stack]

- Max Depth = 72
- Call Chain = HAL_TIM_Base_Init ⇒ HAL_TIM_Base_MspInit ⇒ HAL_GPIO_Init

[Calls]

- >> HAL_TIM_Base_MspInit
- >> TIM_Base_SetConfig

[Called By]

- >> MX_TIM2_Init

HAL_TIM_Base_MspInit (Thumb, 88 bytes, Stack size 24 bytes, stm32f1xx_hal_msp.o(i.HAL_TIM_Base_MspInit))

[Stack]

- Max Depth = 64
- Call Chain = HAL_TIM_Base_MspInit ⇒ HAL_GPIO_Init

[Calls]

- >> HAL_NVIC_SetPriority
- >> HAL_NVIC_EnableIRQ
- >> HAL_GPIO_Init

[Called By]

- >> HAL_TIM_Base_Init

HAL_TIM_Base_Start_IT (Thumb, 76 bytes, Stack size 0 bytes, stm32f1xx_hal_tim.o(i.HAL_TIM_Base_Start_IT))

[Called By]

- >> main

HAL_TIM_ConfigClockSource (Thumb, 214 bytes, Stack size 16 bytes, stm32f1xx_hal_tim.o(i.HAL_TIM_ConfigClockSource))

[Stack]

- Max Depth = 24
- Call Chain = HAL_TIM_ConfigClockSource ⇒ TIM_TI2_ConfigInputStage

[Calls]

- >> TIM_TI2_ConfigInputStage
- >> TIM_TI1_ConfigInputStage
- >> TIM_ITRx_SetConfig
- >> TIM_ETR_SetConfig

[Called By]

- >> MX_TIM2_Init

HAL_TIM_IC_CaptureCallback (Thumb, 74 bytes, Stack size 0 bytes, main.o(i.HAL_TIM_IC_CaptureCallback))

[Called By]

- >> HAL_TIM_IRQHandler

HAL_TIM_IC_ConfigChannel (Thumb, 270 bytes, Stack size 24 bytes, stm32f1xx_hal_tim.o(i.HAL_TIM_IC_ConfigChannel))

[Stack]

- Max Depth = 40
- Call Chain = HAL_TIM_IC_ConfigChannel ⇒ TIM_TI1_SetConfig

[Calls]

- >> TIM_TI2_SetConfig
- >> TIM_TI1_SetConfig

[Called By]

- >> MX_TIM2_Init

HAL_TIM_IC_Init (Thumb, 90 bytes, Stack size 8 bytes, stm32f1xx_hal_tim.o(i.HAL_TIM_IC_Init))

[Stack]

- Max Depth = 28
- Call Chain = HAL_TIM_IC_Init ⇒ TIM_Base_SetConfig

[Calls]

- >> HAL_TIM_IC_MspInit
- >> TIM_Base_SetConfig

[Called By]

- >> MX_TIM2_Init

HAL_TIM_IC_MspInit (Thumb, 2 bytes, Stack size 0 bytes, stm32f1xx_hal_tim.o(i.HAL_TIM_IC_MspInit))

[Called By]

- >> HAL_TIM_IC_Init

HAL_TIM_IC_Start_IT (Thumb, 212 bytes, Stack size 8 bytes, stm32f1xx_hal_tim.o(i.HAL_TIM_IC_Start_IT))

[Stack]

- Max Depth = 16
- Call Chain = HAL_TIM_IC_Start_IT ⇒ TIM_CCxChannelCmd

[Calls]

- >> TIM_CCxChannelCmd

[Called By]

- >> main

HAL_TIM_IRQHandler (Thumb, 358 bytes, Stack size 16 bytes, stm32f1xx_hal_tim.o(i.HAL_TIM_IRQHandler))

[Stack]

- Max Depth = 16
- Call Chain = HAL_TIM_IRQHandler

[Calls]

- >> HAL_TIM_PeriodElapsedCallback
- >> HAL_TIM_IC_CaptureCallback
- >> HAL_TIM_TriggerCallback
- >> HAL_TIM_PWM_PulseFinishedCallback
- >> HAL_TIM_OC_DelayElapsedCallback
- >> HAL_TIMEx_CommutCallback
- >> HAL_TIMEx_BreakCallback

[Called By]

- >> TIM2_IRQHandler

HAL_TIM_OC_DelayElapsedCallback (Thumb, 2 bytes, Stack size 0 bytes, stm32f1xx_hal_tim.o(i.HAL_TIM_OC_DelayElapsedCallback))

[Called By]

- >> HAL_TIM_IRQHandler

HAL_TIM_PWM_PulseFinishedCallback (Thumb, 2 bytes, Stack size 0 bytes, stm32f1xx_hal_tim.o(i.HAL_TIM_PWM_PulseFinishedCallback))

[Called By]

- >> HAL_TIM_IRQHandler

HAL_TIM_PeriodElapsedCallback (Thumb, 10 bytes, Stack size 0 bytes, main.o(i.HAL_TIM_PeriodElapsedCallback))

[Called By]

- >> HAL_TIM_IRQHandler

HAL_TIM_TriggerCallback (Thumb, 2 bytes, Stack size 0 bytes, stm32f1xx_hal_tim.o(i.HAL_TIM_TriggerCallback))

[Called By]

- >> HAL_TIM_IRQHandler

HAL_UART_Init (Thumb, 98 bytes, Stack size 16 bytes, stm32f1xx_hal_uart.o(i.HAL_UART_Init))

[Stack]

- Max Depth = 96
- Call Chain = HAL_UART_Init ⇒ HAL_UART_MspInit ⇒ HAL_GPIO_Init

[Calls]

- >> HAL_UART_MspInit
- >> UART_SetConfig

[Called By]

- >> main

HAL_UART_MspInit (Thumb, 166 bytes, Stack size 40 bytes, stm32f1xx_hal_msp.o(i.HAL_UART_MspInit))

[Stack]

- Max Depth = 80
- Call Chain = HAL_UART_MspInit ⇒ HAL_GPIO_Init

[Calls]

- >> HAL_GPIO_Init

[Called By]

- >> HAL_UART_Init

HAL_UART_Transmit (Thumb, 178 bytes, Stack size 32 bytes, stm32f1xx_hal_uart.o(i.HAL_UART_Transmit))

[Stack]

- Max Depth = 56
- Call Chain = HAL_UART_Transmit ⇒ UART_WaitOnFlagUntilTimeout

[Calls]

- >> UART_WaitOnFlagUntilTimeout
- >> HAL_GetTick

[Called By]

- >> fputc

HardFault_Handler (Thumb, 2 bytes, Stack size 0 bytes, stm32f1xx_it.o(i.HardFault_Handler))

[Calls]

- >> HardFault_Handler

[Called By]

- >> HardFault_Handler

[Address Reference Count : 1]

- startup_stm32f103xb.o(RESET)

MemManage_Handler (Thumb, 2 bytes, Stack size 0 bytes, stm32f1xx_it.o(i.MemManage_Handler))

[Calls]

- >> MemManage_Handler

[Called By]

- >> MemManage_Handler

[Address Reference Count : 1]

- startup_stm32f103xb.o(RESET)

NMI_Handler (Thumb, 2 bytes, Stack size 0 bytes, stm32f1xx_it.o(i.NMI_Handler))

[Calls]

- >> NMI_Handler

[Called By]

- >> NMI_Handler

[Address Reference Count : 1]

- startup_stm32f103xb.o(RESET)

PendSV_Handler (Thumb, 2 bytes, Stack size 0 bytes, stm32f1xx_it.o(i.PendSV_Handler))
[Address Reference Count : 1]

- startup_stm32f103xb.o(RESET)

SVC_Handler (Thumb, 2 bytes, Stack size 0 bytes, stm32f1xx_it.o(i.SVC_Handler))
[Address Reference Count : 1]

- startup_stm32f103xb.o(RESET)

SysTick_Handler (Thumb, 4 bytes, Stack size 0 bytes, stm32f1xx_it.o(i.SysTick_Handler))

[Calls]

- >> HAL_IncTick

[Address Reference Count : 1]

- startup_stm32f103xb.o(RESET)

SystemClock_Config (Thumb, 94 bytes, Stack size 72 bytes, main.o(i.SystemClock_Config))

[Stack]

- Max Depth = 136
- Call Chain = SystemClock_Config ⇒ HAL_RCC_ClockConfig ⇒ HAL_InitTick ⇒ HAL_NVIC_SetPriority

[Calls]

- >> HAL_RCC_OscConfig
- >> HAL_RCC_ClockConfig
- >> __aeabi_memclr4

[Called By]

- >> main

SystemInit (Thumb, 2 bytes, Stack size 0 bytes, system_stm32f1xx.o(i.SystemInit))
[Address Reference Count : 1]

- startup_stm32f103xb.o(.text)

TIM2_IRQHandler (Thumb, 6 bytes, Stack size 0 bytes, stm32f1xx_it.o(i.TIM2_IRQHandler))

[Stack]

- Max Depth = 16
- Call Chain = TIM2_IRQHandler ⇒ HAL_TIM_IRQHandler

[Calls]

- >> HAL_TIM_IRQHandler

[Address Reference Count : 1]

- startup_stm32f103xb.o(RESET)

TIM_Base_SetConfig (Thumb, 94 bytes, Stack size 20 bytes, stm32f1xx_hal_tim.o(i.TIM_Base_SetConfig))

[Stack]

- Max Depth = 20
- Call Chain = TIM_Base_SetConfig

[Called By]

- >> HAL_TIM_IC_Init
- >> HAL_TIM_Base_Init

TIM_CCxChannelCmd (Thumb, 26 bytes, Stack size 8 bytes, stm32f1xx_hal_tim.o(i.TIM_CCxChannelCmd))

[Stack]

- Max Depth = 8
- Call Chain = TIM_CCxChannelCmd

[Called By]

- >> HAL_TIM_IC_Start_IT

TIM_ETR_SetConfig (Thumb, 20 bytes, Stack size 8 bytes, stm32f1xx_hal_tim.o(i.TIM_ETR_SetConfig))

[Stack]

- Max Depth = 8
- Call Chain = TIM_ETR_SetConfig

[Called By]

- >> HAL_TIM_ConfigClockSource

TIM_TI1_SetConfig (Thumb, 76 bytes, Stack size 16 bytes, stm32f1xx_hal_tim.o(i.TIM_TI1_SetConfig))

[Stack]

- Max Depth = 16
- Call Chain = TIM_TI1_SetConfig

[Called By]

- >> HAL_TIM_IC_ConfigChannel

UsageFault_Handler (Thumb, 2 bytes, Stack size 0 bytes, stm32f1xx_it.o(i.UsageFault_Handler))

[Calls]

- >> UsageFault_Handler

[Called By]

- >> UsageFault_Handler

[Address Reference Count : 1]

- startup_stm32f103xb.o(RESET)

__0printf (Thumb, 22 bytes, Stack size 24 bytes, printfa.o(i.__0printf), UNUSED)

[Calls]

- >> _printf_core

__1printf (Thumb, 0 bytes, Stack size 24 bytes, printfa.o(i.__0printf), UNUSED)

__2printf (Thumb, 0 bytes, Stack size 24 bytes, printfa.o(i.__0printf))

[Stack]

- Max Depth = 24
- Call Chain = __2printf

[Called By]

- >> main

__c89printf (Thumb, 0 bytes, Stack size 24 bytes, printfa.o(i.__0printf), UNUSED)

printf (Thumb, 0 bytes, Stack size 24 bytes, printfa.o(i.__0printf), UNUSED)

__scatterload_copy (Thumb, 14 bytes, Stack size unknown bytes, handlers.o(i.__scatterload_copy), UNUSED)

__scatterload_null (Thumb, 2 bytes, Stack size unknown bytes, handlers.o(i.__scatterload_null), UNUSED)

__scatterload_zeroinit (Thumb, 14 bytes, Stack size unknown bytes, handlers.o(i.__scatterload_zeroinit), UNUSED)

cmpfunc (Thumb, 8 bytes, Stack size 0 bytes, main.o(i.cmpfunc))
[Address Reference Count : 1]

- main.o(i.main)

fputc (Thumb, 20 bytes, Stack size 16 bytes, main.o(i.fputc))

[Stack]

- Max Depth = 72
- Call Chain = fputc ⇒ HAL_UART_Transmit ⇒ UART_WaitOnFlagUntilTimeout

[Calls]

- >> HAL_UART_Transmit

[Address Reference Count : 1]

- printfa.o(i.__0printf)

main (Thumb, 306 bytes, Stack size 0 bytes, main.o(i.main))

[Stack]

- Max Depth = 136
- Call Chain = main ⇒ SystemClock_Config ⇒ HAL_RCC_ClockConfig ⇒ HAL_InitTick ⇒ HAL_NVIC_SetPriority

[Calls]

- >> __aeabi_f2iz
- >> __aeabi_f2d
- >> HAL_UART_Init
- >> HAL_TIM_IC_Start_IT
- >> HAL_TIM_Base_Start_IT
- >> HAL_Init
- >> HAL_GPIO_TogglePin
- >> HAL_Delay
- >> SystemClock_Config
- >> Calc_Height
- >> Calc_Cap
- >> MX_TIM2_Init
- >> MX_GPIO_Init
- >> qsort
- >> __2printf

[Address Reference Count : 1]

- entry9a.o(.ARM.Collect$$$$0000000B)

### Local Symbols

MX_GPIO_Init (Thumb, 140 bytes, Stack size 48 bytes, main.o(i.MX_GPIO_Init))

[Stack]

- Max Depth = 88
- Call Chain = MX_GPIO_Init ⇒ HAL_GPIO_Init

[Calls]

- >> HAL_GPIO_WritePin
- >> HAL_GPIO_Init

[Called By]

- >> main

MX_TIM2_Init (Thumb, 146 bytes, Stack size 56 bytes, main.o(i.MX_TIM2_Init))

[Stack]

- Max Depth = 128
- Call Chain = MX_TIM2_Init ⇒ HAL_TIM_Base_Init ⇒ HAL_TIM_Base_MspInit ⇒ HAL_GPIO_Init

[Calls]

- >> HAL_TIM_IC_Init
- >> HAL_TIM_IC_ConfigChannel
- >> HAL_TIM_ConfigClockSource
- >> HAL_TIM_Base_Init
- >> HAL_TIMEx_MasterConfigSynchronization

[Called By]

- >> main

TIM_ITRx_SetConfig (Thumb, 16 bytes, Stack size 0 bytes, stm32f1xx_hal_tim.o(i.TIM_ITRx_SetConfig))

[Called By]

- >> HAL_TIM_ConfigClockSource

TIM_TI1_ConfigInputStage (Thumb, 34 bytes, Stack size 8 bytes, stm32f1xx_hal_tim.o(i.TIM_TI1_ConfigInputStage))

[Stack]

- Max Depth = 8
- Call Chain = TIM_TI1_ConfigInputStage

[Called By]

- >> HAL_TIM_ConfigClockSource

TIM_TI2_ConfigInputStage (Thumb, 36 bytes, Stack size 8 bytes, stm32f1xx_hal_tim.o(i.TIM_TI2_ConfigInputStage))

[Stack]

- Max Depth = 8
- Call Chain = TIM_TI2_ConfigInputStage

[Called By]

- >> HAL_TIM_ConfigClockSource

TIM_TI2_SetConfig (Thumb, 54 bytes, Stack size 12 bytes, stm32f1xx_hal_tim.o(i.TIM_TI2_SetConfig))

[Stack]

- Max Depth = 12
- Call Chain = TIM_TI2_SetConfig

[Called By]

- >> HAL_TIM_IC_ConfigChannel

__NVIC_SetPriority (Thumb, 32 bytes, Stack size 0 bytes, stm32f1xx_hal_cortex.o(i.__NVIC_SetPriority))

[Called By]

- >> HAL_NVIC_SetPriority
- >> HAL_SYSTICK_Config

UART_SetConfig (Thumb, 178 bytes, Stack size 16 bytes, stm32f1xx_hal_uart.o(i.UART_SetConfig))

[Stack]

- Max Depth = 16
- Call Chain = UART_SetConfig

[Calls]

- >> HAL_RCC_GetPCLK2Freq
- >> HAL_RCC_GetPCLK1Freq

[Called By]

- >> HAL_UART_Init

UART_WaitOnFlagUntilTimeout (Thumb, 100 bytes, Stack size 24 bytes, stm32f1xx_hal_uart.o(i.UART_WaitOnFlagUntilTimeout))

[Stack]

- Max Depth = 24
- Call Chain = UART_WaitOnFlagUntilTimeout

[Calls]

- >> HAL_GetTick

[Called By]

- >> HAL_UART_Transmit

_fp_digits (Thumb, 366 bytes, Stack size 64 bytes, printfa.o(i._fp_digits), UNUSED)

[Calls]

- >> __aeabi_ddiv
- >> __aeabi_uldivmod
- >> __aeabi_dmul
- >> __aeabi_dadd
- >> __aeabi_d2ulz
- >> __aeabi_cdrcmple

[Called By]

- >> _printf_core

_printf_core (Thumb, 1704 bytes, Stack size 136 bytes, printfa.o(i._printf_core), UNUSED)

[Calls]

- >> __aeabi_uldivmod
- >> __aeabi_uidivmod
- >> _printf_pre_padding
- >> _printf_post_padding
- >> _fp_digits

[Called By]

- >> __0printf

_printf_post_padding (Thumb, 36 bytes, Stack size 24 bytes, printfa.o(i._printf_post_padding), UNUSED)

[Called By]

- >> _printf_core

_printf_pre_padding (Thumb, 46 bytes, Stack size 24 bytes, printfa.o(i._printf_pre_padding), UNUSED)

[Called By]

- >> _printf_core

### Undefined Global Symbols
