amirmat98/Capacitive-Level-Meter-Sensor/Qt/Test05/main_test/10320742921.jpg

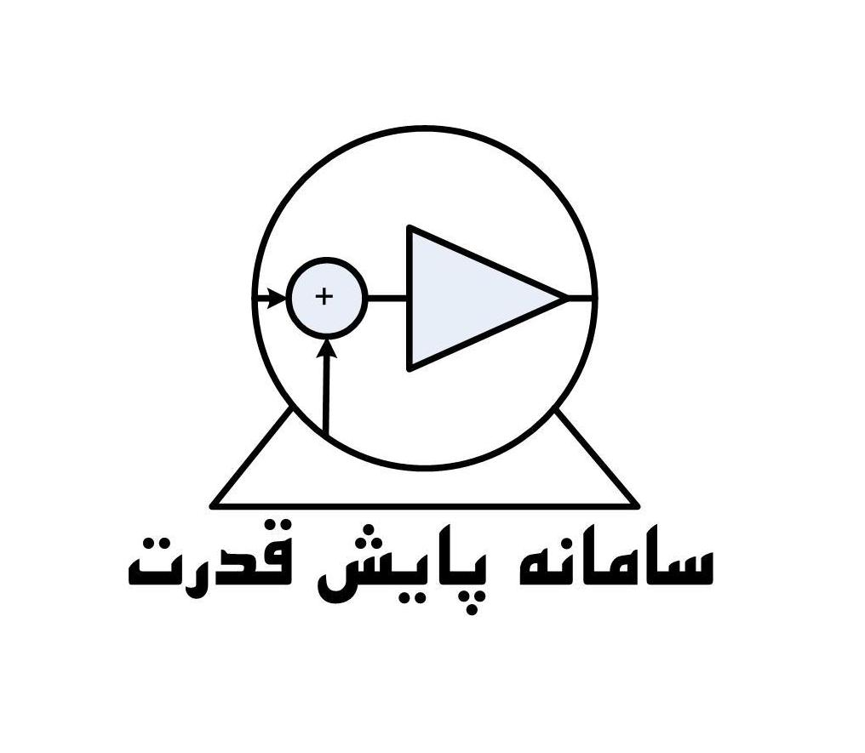
Qt/Test05/main_test/10320742921.jpg
