amirmat98/Capacitive-Level-Meter-Sensor/Report/Presentation_Version2_Amirmahdi Matin_810695300.pdf

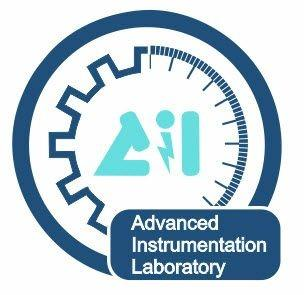
[picture p13: figure]
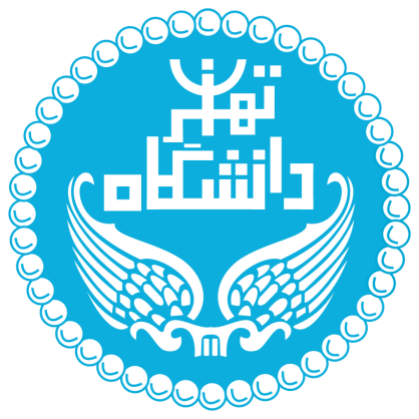
[picture p14: figure]

# طراحی و ساخت حسگر خازنی سطح سنج آب در مخازن

# پژوهشگر: امیرمهدی متین استاد راهنما: دکتر موسی آیتی

# پردیس دانشکدههای فنی دانشگاه تهران دانشکده مهندسی مکانیک آزمایشگاه ابزار دقیق پیشرفته

# مقدمه

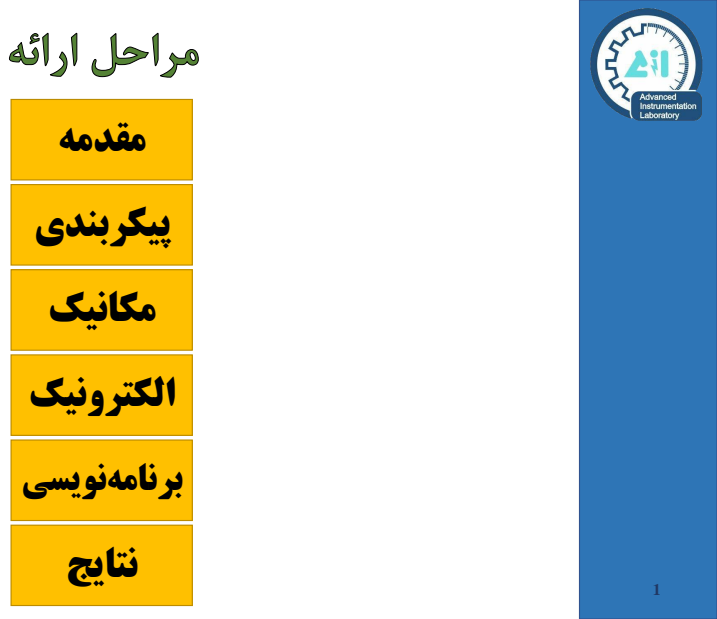
[picture p15: page 2]
پیکر بندی; برنامه نویسی; مکانیک; نتایج; الکترونیک

# مقدمه

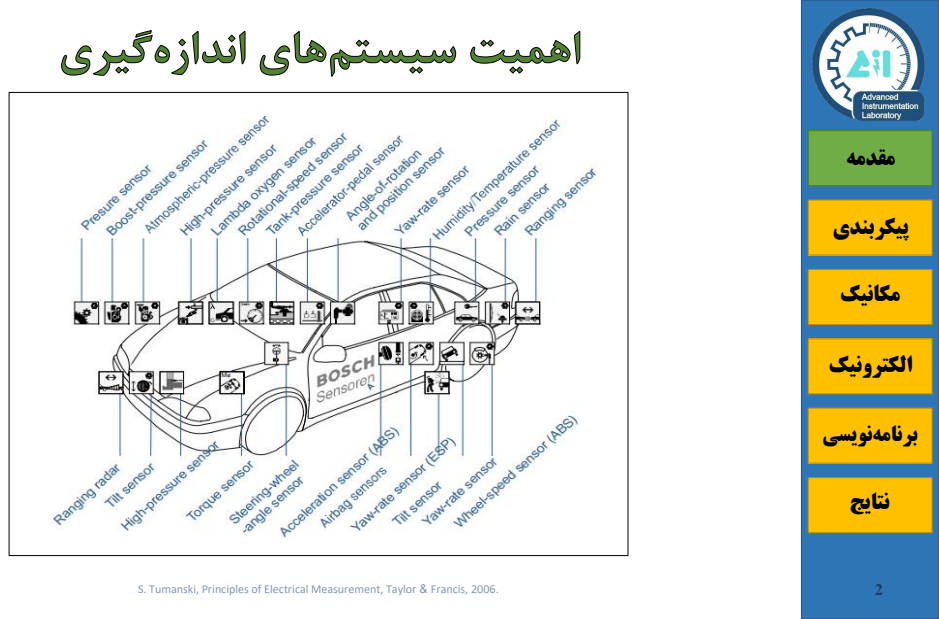
[picture p16: page 3]
پیکربندی; مکانیک; الکترونیک; برنامه نویسی; نتایج; S. Tumanski, Principles of Electrical Measurement, Taylor & Francis, 2006.

# مقدمه

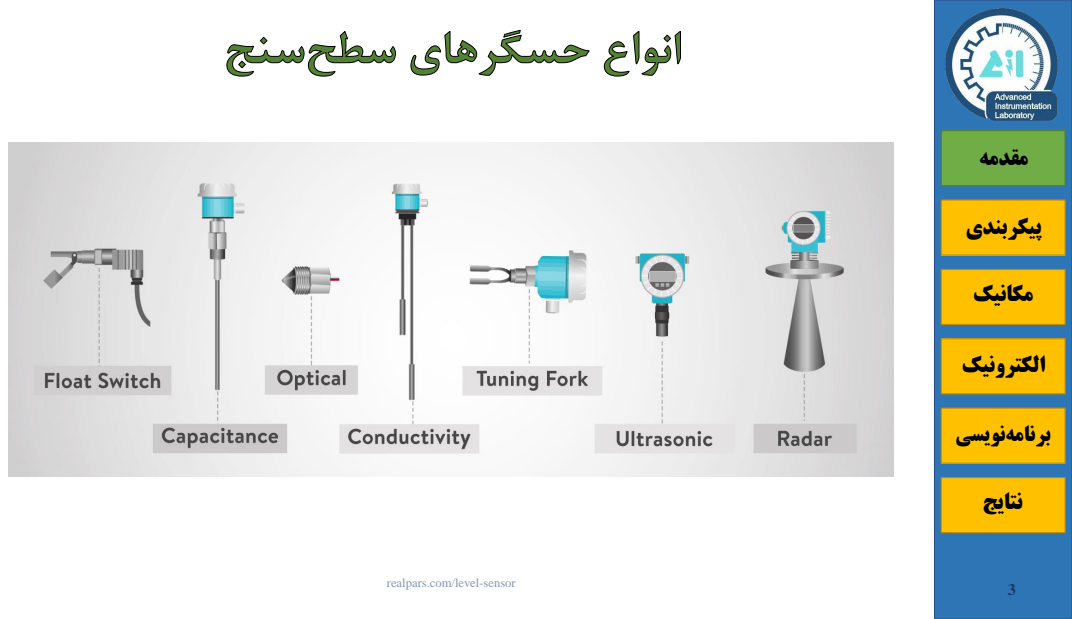
[picture p17: page 4]
پیکربندی; مکانیک; برنامه نویسی; الکترونیک; 3 نتایج; -sensor

realpars.com/level

# مقدمه

# پیکربندی

# مکانیک

# الکترونیک

# برنامه نویسی

# نتایج

4

| حسگر مزایا معایب
ساختار ساده مستعد آسیب های مکانیکی | شناوری

# هزینه کم هزینه تعمیر و نگهداری باال

# التراسونیک

# ساختار ساده مستعد داشتن تداخالت نصب و نگهداری آسان ایمنی ذاتی ضعیف

دقت باال ابعاد بزرگ گیر کردن در محیط های خاص مانند مایع گل آلود | مغناطیسی

# امنیت باال

# دیفرانسیلی فشار

# عملکرد پایدار دقت باال مسدود شدن به آسانی هزینه کم

# فیبر نوری

# ضد تداخالت الکترومغناطیسی عدم اندازه گیری مایعات کدر و مواد چسبنده استحکام در محیط های سخت

# خازنی

# هزینه کم ساختار پیچیده خطی بودن باال اتالف انرژی کم ایمنی غیر ذاتی

# مقدمه

# پیکربندی

# مکانیک

# الکترونیک

# برنامه نویسی

# نتایج

5

| حسگر مزایا معایب
ساختار ساده مستعد آسیب های مکانیکی | شناوری

# هزینه کم هزینه تعمیر و نگهداری باال

# التراسونیک

# ساختار ساده مستعد داشتن تداخالت نصب و نگهداری آسان ایمنی ذاتی ضعیف

دقت باال ابعاد بزرگ گیر کردن در محیط های خاص مانند مایع گل آلود | مغناطیسی

# امنیت باال

# دیفرانسیلی فشار

# عملکرد پایدار دقت باال مسدود شدن به آسانی هزینه کم

# فیبر نوری

# ضد تداخالت الکترومغناطیسی عدم اندازه گیری مایعات کدر و مواد چسبنده استحکام در محیط های سخت

# خازنی

# هزینه کم ساختار پیچیده خطی بودن باال اتالف انرژی کم ایمنی غیر ذاتی

# مقدمه

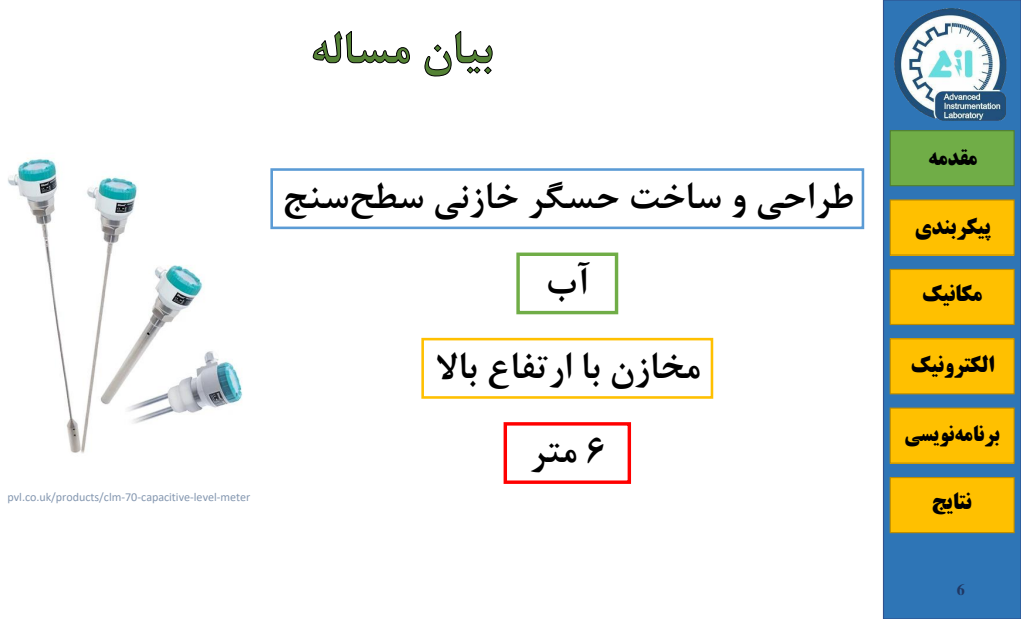
[picture p18: page 7]
پیکربندی; مکانیک; الکترونیک; برنامه نویسی; نتایج

طراحی و ساخت حسگر خازنی سطح سنج

مخازن با ارتفاع باال
6 متر

pvl.co.uk/products/clm-70-capacitive-level-meter

# مقدمه

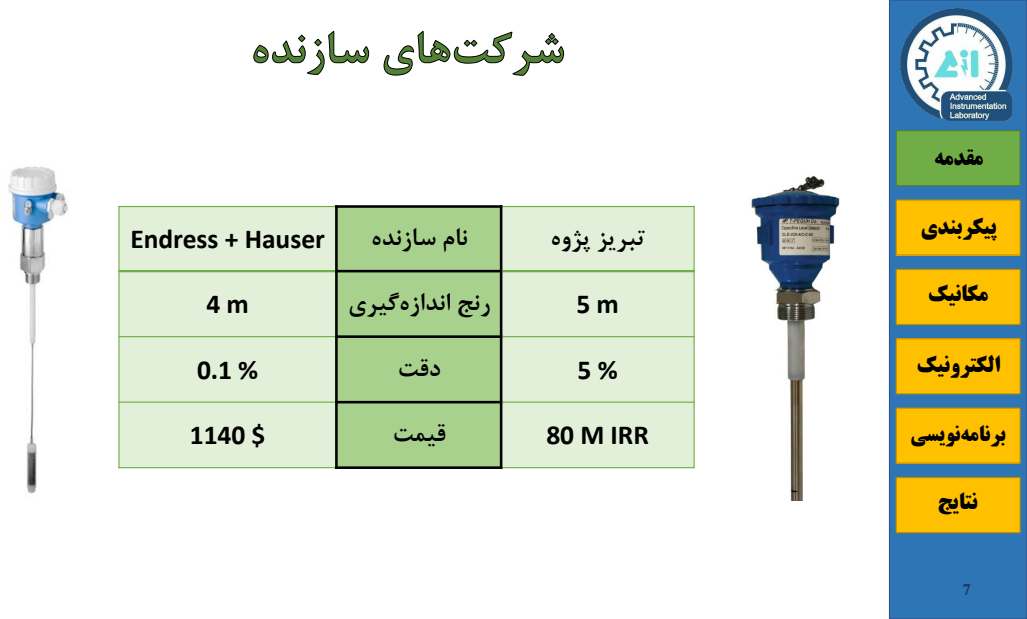
[picture p19: page 8]
پیکربندی; مکانیک; الکترونیک; برنامه نویسی; نتایج; % 5 دقت % 0.1; قیمت; 80 M IRR

تبریز پژوه نام سازنده Hauser + Endress

m 5 رنج اندازه گیری m 4

# مقدمه

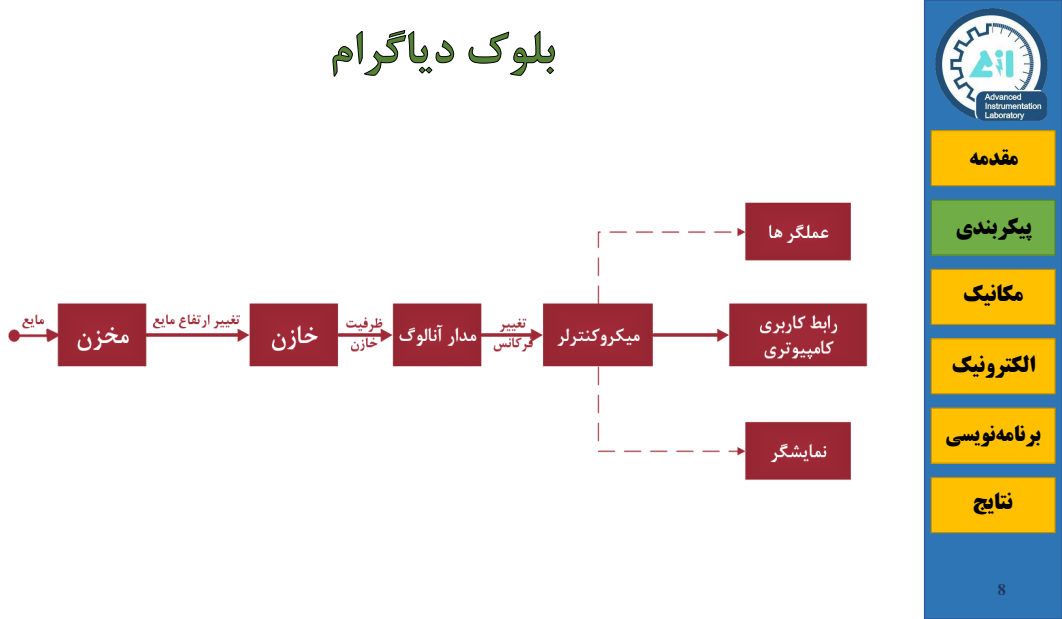
[picture p20: page 9]
پیکربندی; مکانیک; الکترونیک; برنامه نویسی; نتایج

# مقدمه

# استوانه ای تخت

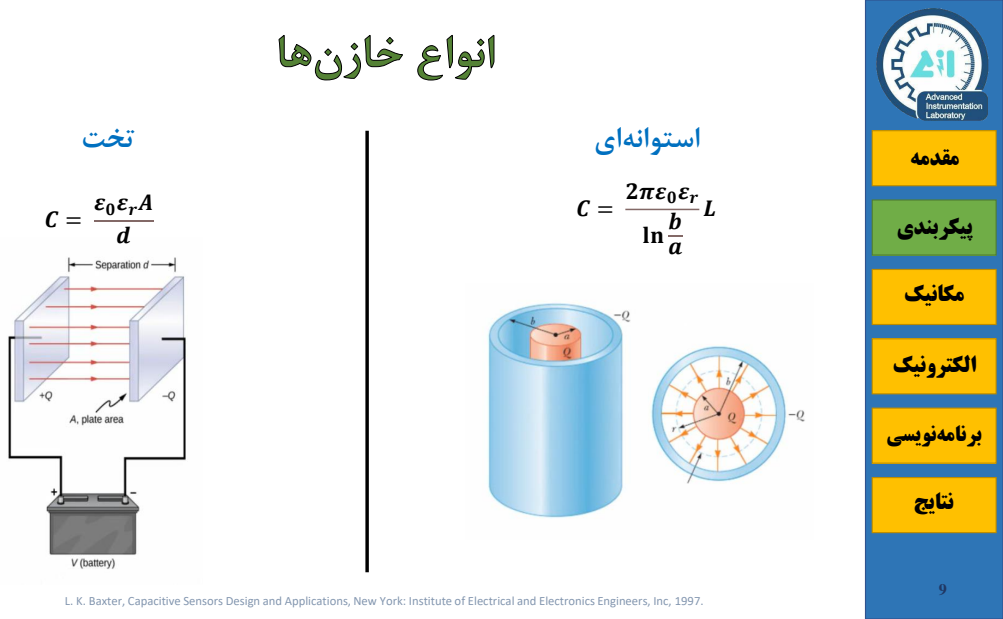
[picture p21: page 10]
پیکربندی; مکانیک; الکترونیک; برنامه نویسی; نتایج; ε0εrA d

L. K. Baxter, Capacitive Sensors Design and Applications, New York: Institute of Electrical and Electronics Engineers, Inc, 1997.

# مقدمه

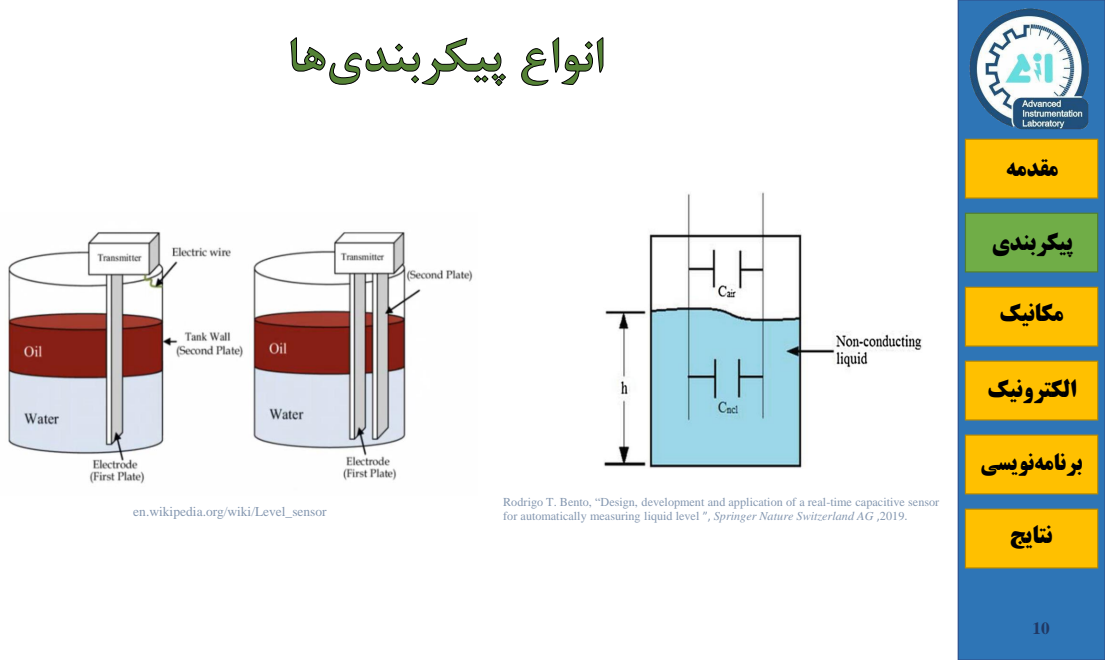
[picture p22: page 11]
پیکربندی; مکانیک; الکترونیک; برنامه نویسی; نتایج

Rodrigo T. Bento, “Design, development and application of a real-time capacitive sensor
for automatically measuring liquid level ”, Springer Nature Switzerland AG ,2019.

en.wikipedia.org/wiki/Level_sensor

# مقدمه

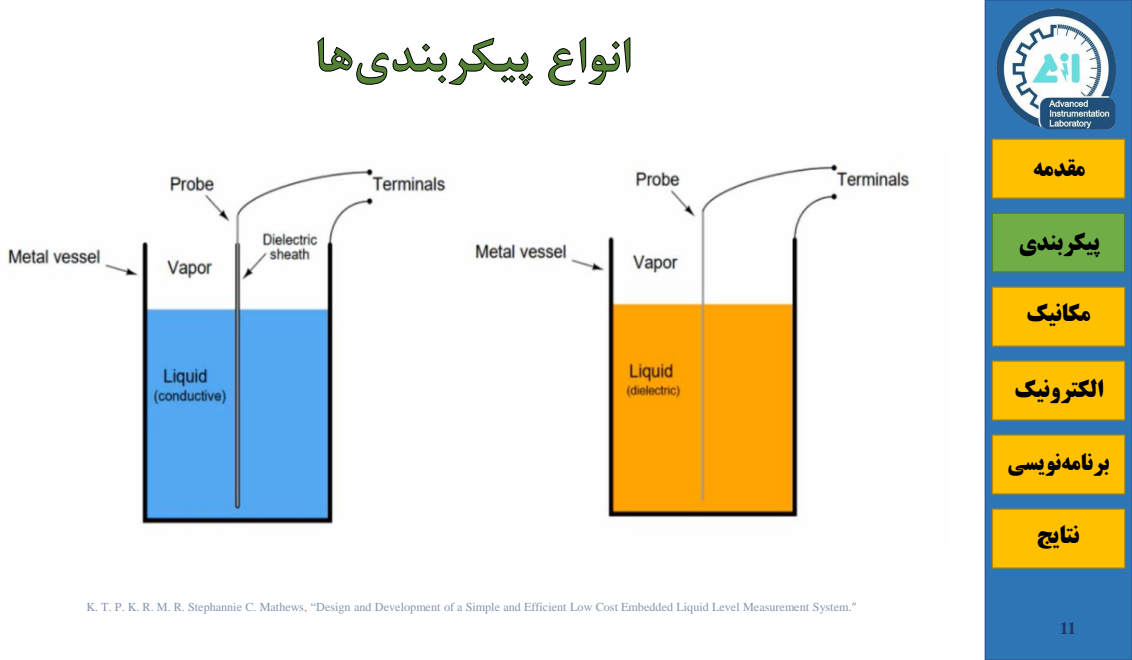
[picture p23: page 12]
پیکربندی; مکانیک; الکترونیک; برنامه نویسی; نتایج

K. T. P. K. R. M. R. Stephannie C. Mathews, “Design and Development of a Simple and Efficient Low Cost Embedded Liquid Level Measurement System.”

# مقدمه

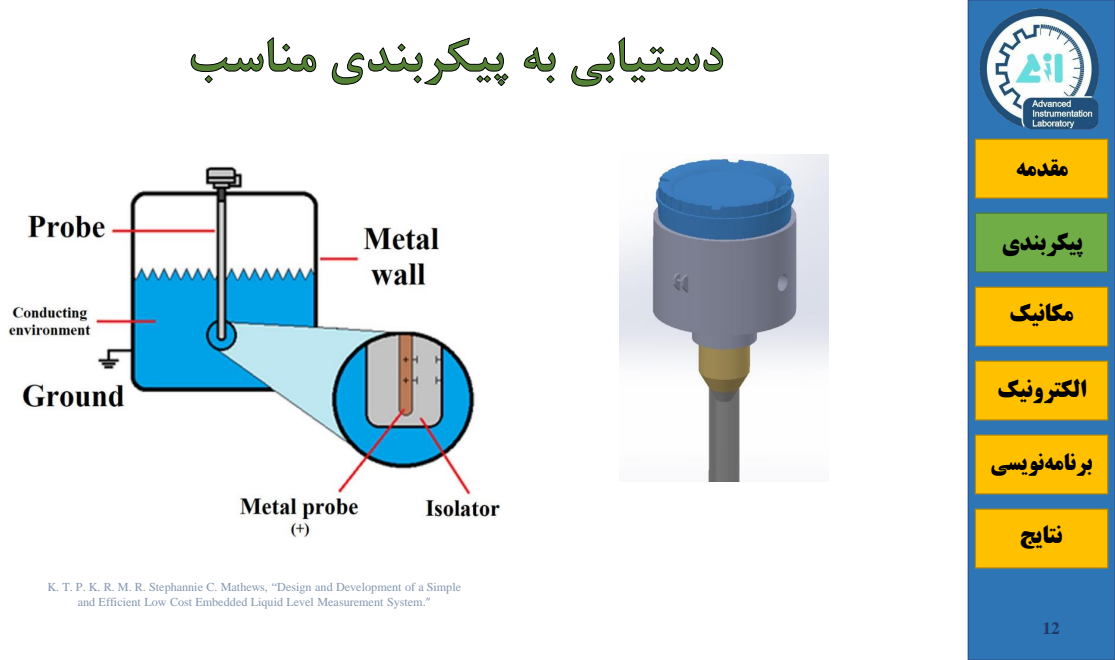
[picture p24: page 13]
پیکربندی; مکانیک; الکترونیک; برنامه نویسی; نتایج

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

# مقدمه

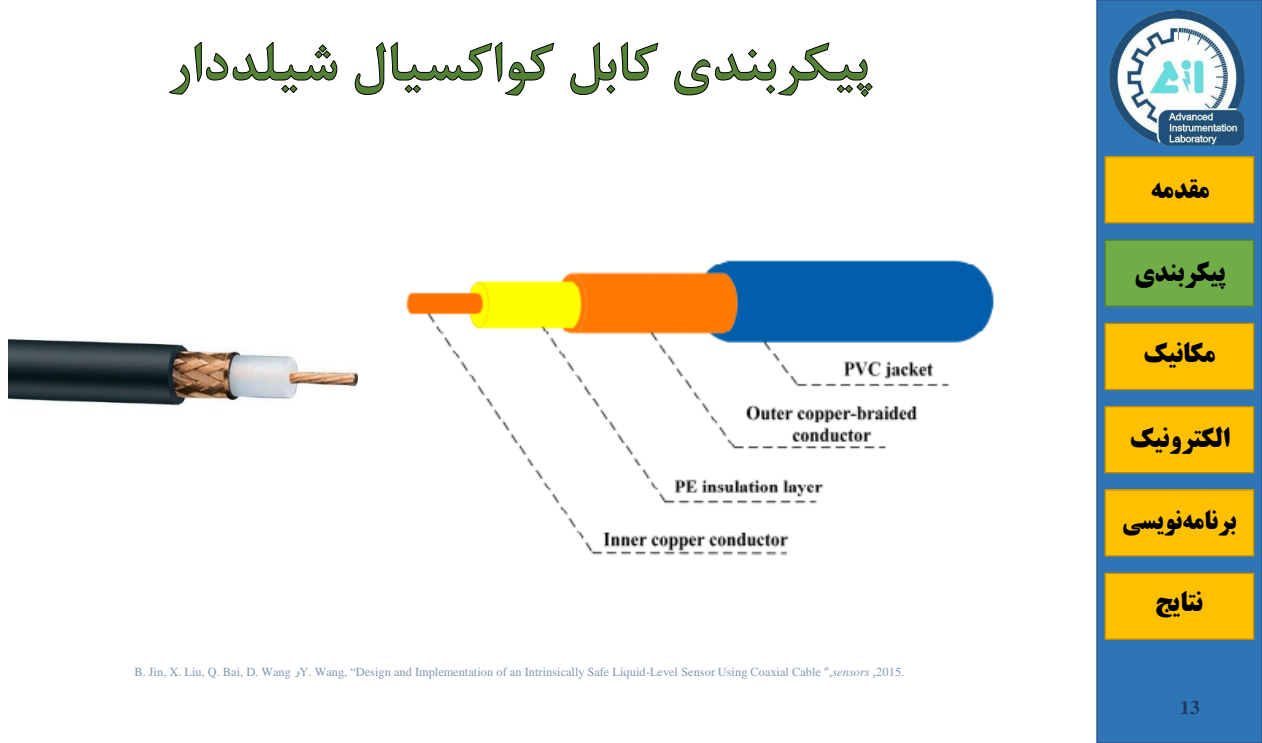
[picture p25: page 14]
پیکربندی; مکانیک; الکترونیک; برنامه نویسی; نتایج

B. Jin, X. Liu, Q. Bai, D. Wang وY. Wang, “Design and Implementation of an Intrinsically Safe Liquid-Level Sensor Using Coaxial Cable ”,sensors ,2015.

# مقدمه

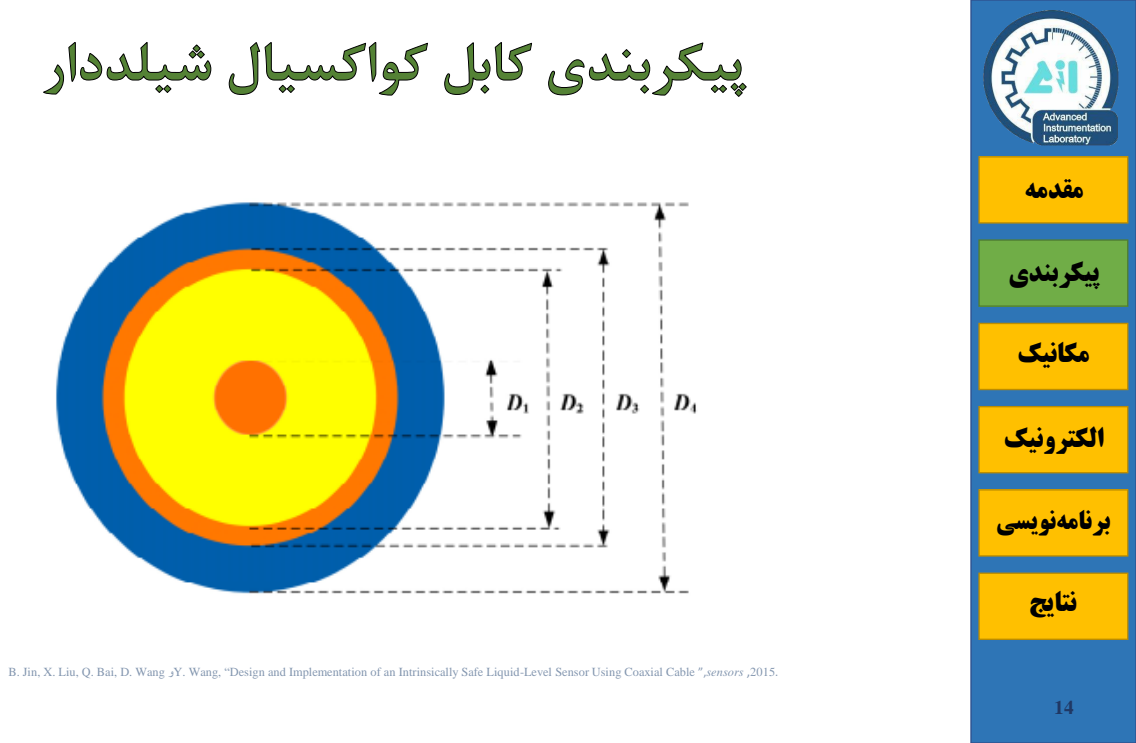
[picture p26: page 15]
پیکربندی; مکانیک; الکترونیک; برنامه نویسی; نتایج

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

# مقدمه

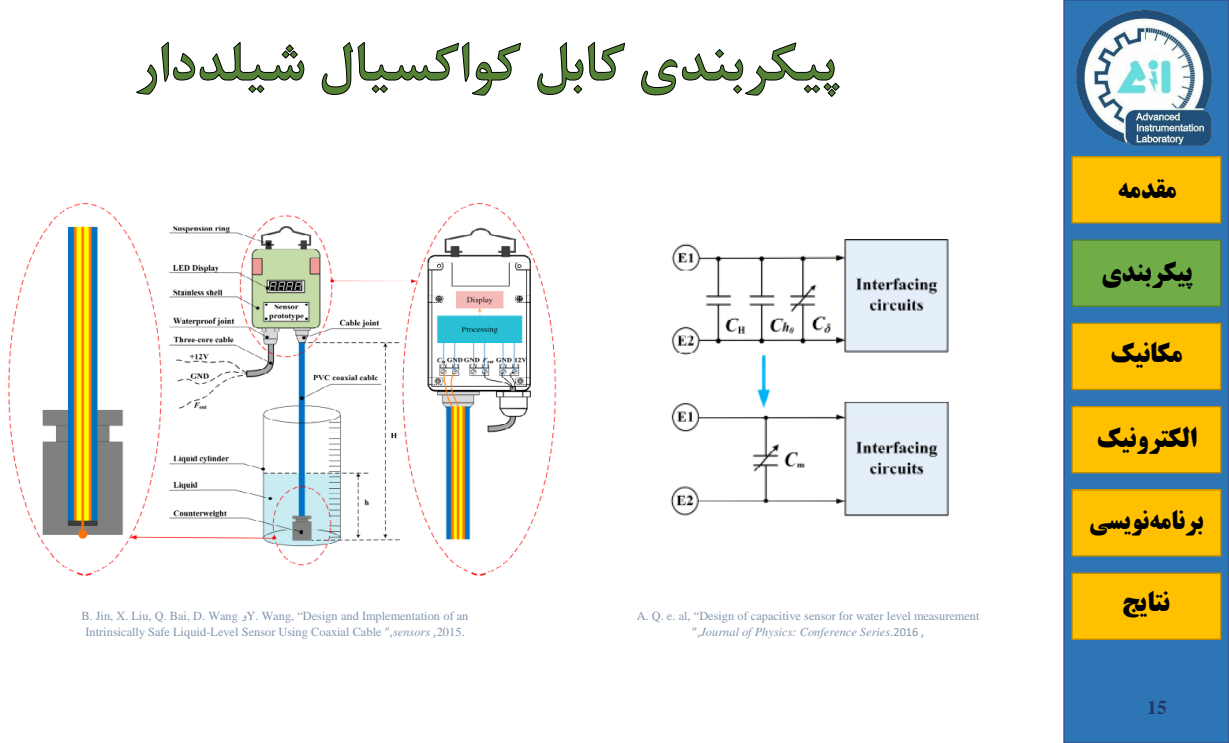
[picture p27: page 16]
پیکربندی; مکانیک; الکترونیک; برنامه نویسی; نتایج

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

A. Q. e. al, “Design of capacitive sensor for water level measurement

”,Journal of Physics: Conference Series.2016 ,

# مقدمه

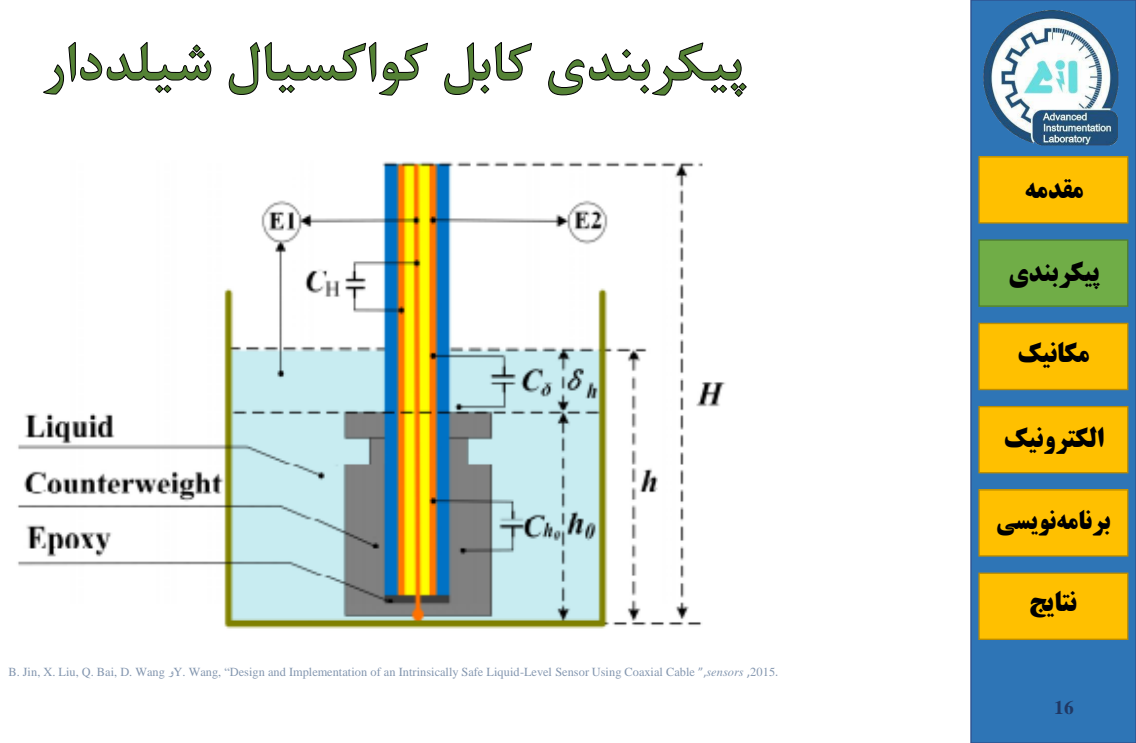
[picture p28: page 17]
پیکربندی; مکانیک; الکترونیک; برنامه نویسی; نتایج

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

# مقدمه

# 2πε0εrH

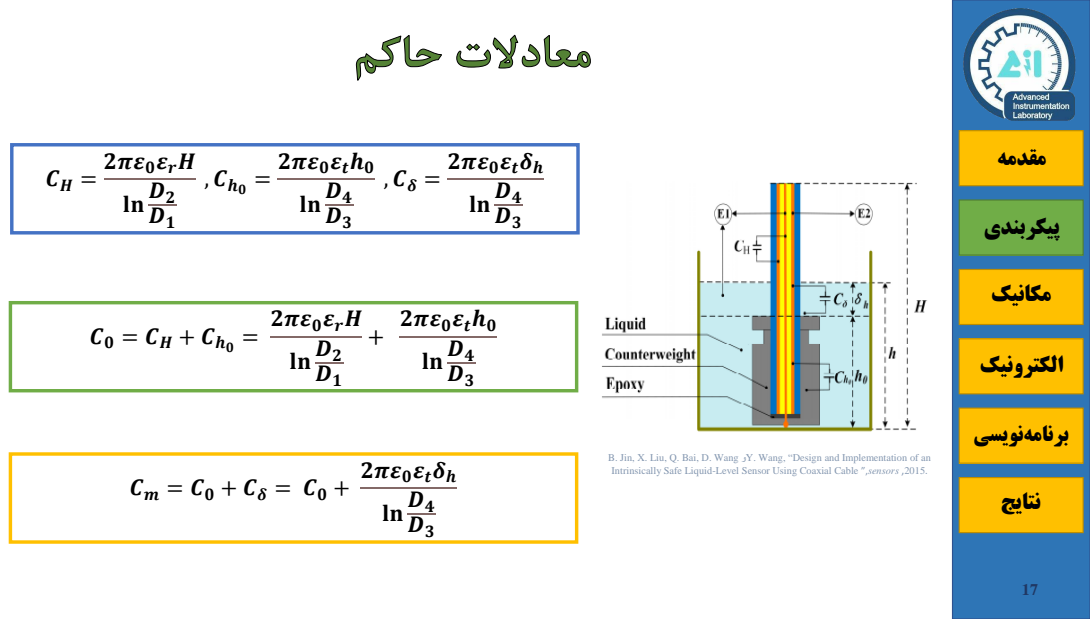
[picture p29: page 18]
پیکربندی; مکانیک; الکترونیک; برنامه نویسی; نتایج; 2πε0εth0 ln D4 D3; 2πε0εtδh ln D4 D3; 2πε0εrH ln D2 D1

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

# مقدمه

| | | پارامتر توضیح مقدار واحد

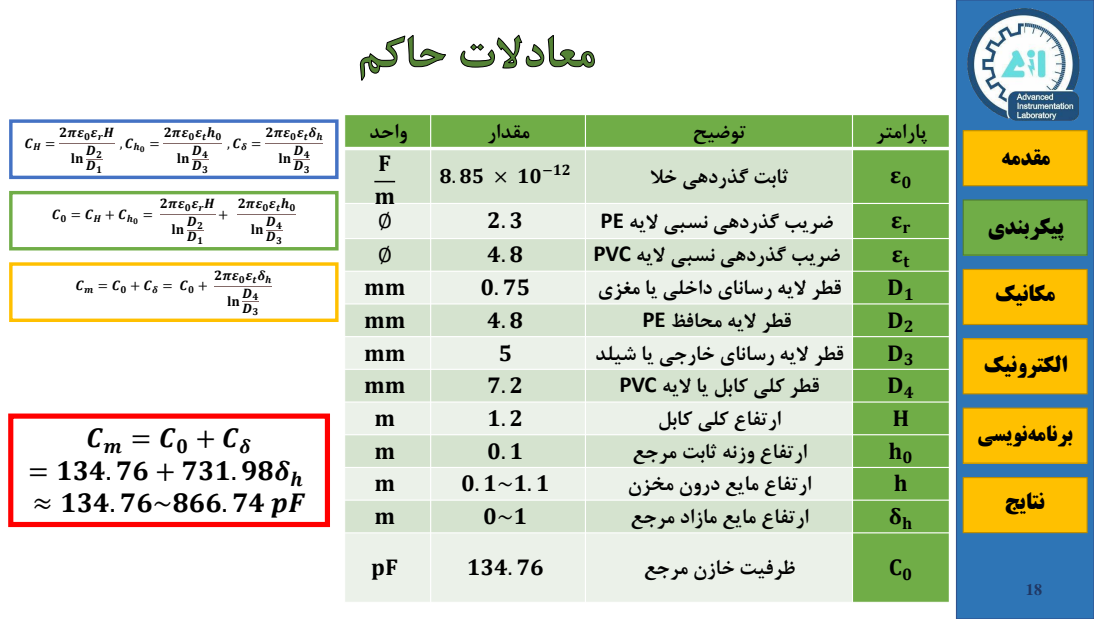
[picture p30: page 19]
پیکربندی; مکانیک; الکترونیک; برنامه نویسی; نتایج; 2πε0εrH ln D2 D1; 2πε0εth0 ln D4 D3; 2πε0εtδh ln D4 D3; قطر الیه محافظ PE 8 .; قطر الیه رسانای خارجی یا شیلد  m

m | . 85 × 10 F −12 | | ε ثابت گذردهی خال 

2 | ضریب گذردهی نسبی الیه PE 3 . | εr ∅
4 | ضریب گذردهی نسبی الیه PVC 8 . | εt ∅

D قطر الیه رسانای داخلی یا مغزی 7 . m

7 | قطر کلی کابل یا الیه PVC 2 . | D4 mm
 ارتفاع کلی کابل  . 
h ارتفاع وزنه ثابت مرجع  . 
 ارتفاع مایع درون مخزن  .~ . 
δ ارتفاع مایع مازاد مرجع ~ 

C ظرفیت خازن مرجع 7 .31 p

# مقدمه

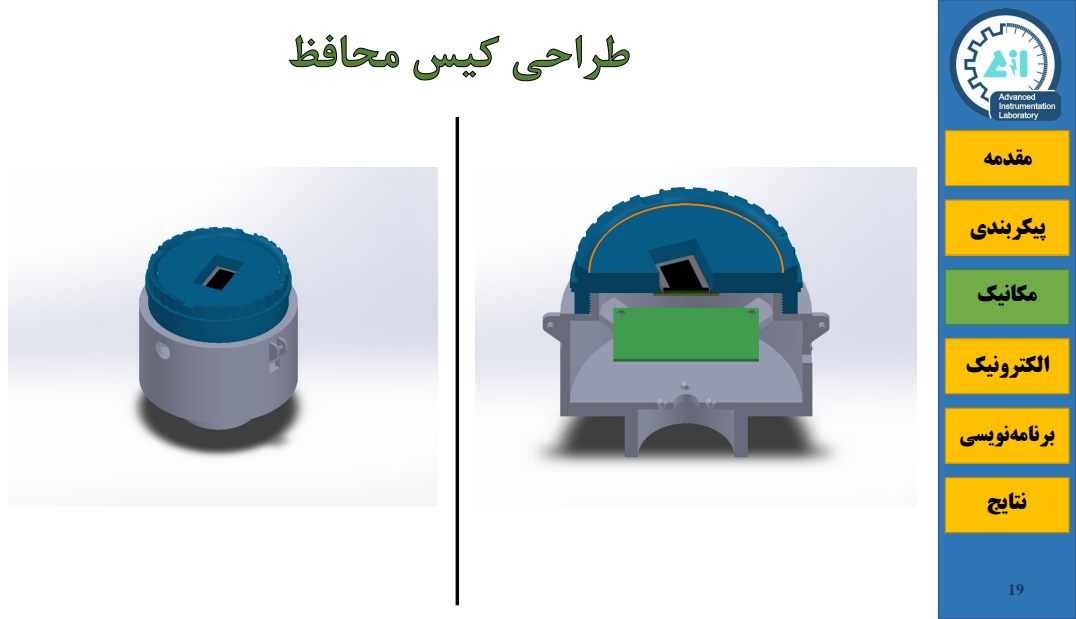
[picture p31: page 20]
پیکربندی; مکانیک; الکترونیک; برنامه نویسی; نتایج

# مقدمه

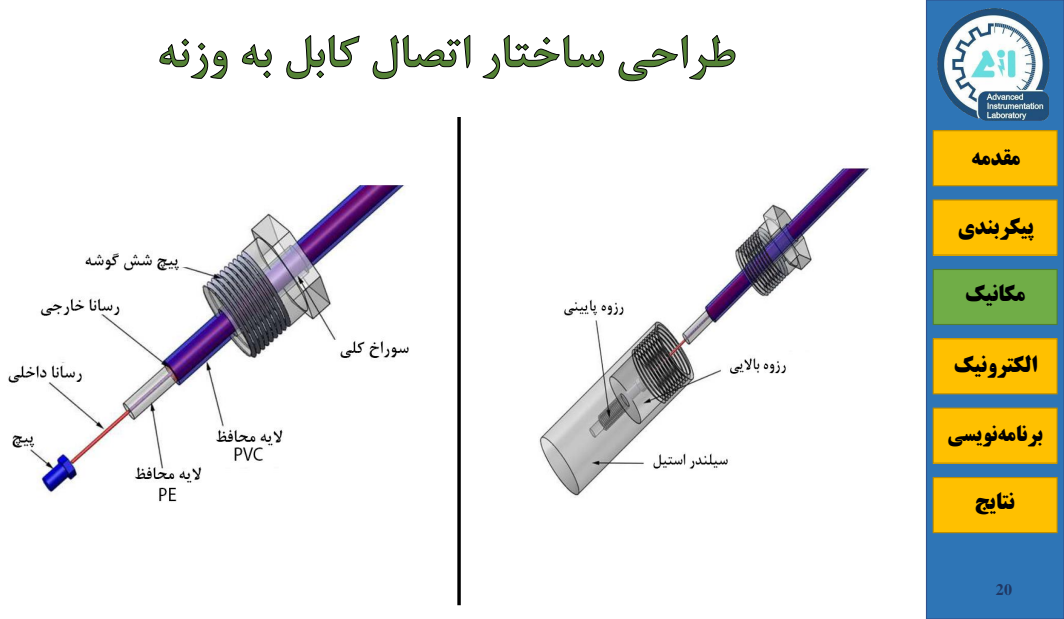
[picture p32: page 21]
پیکربندی; مکانیک; الکترونیک; برنامه نویسی; نتایج

# مقدمه

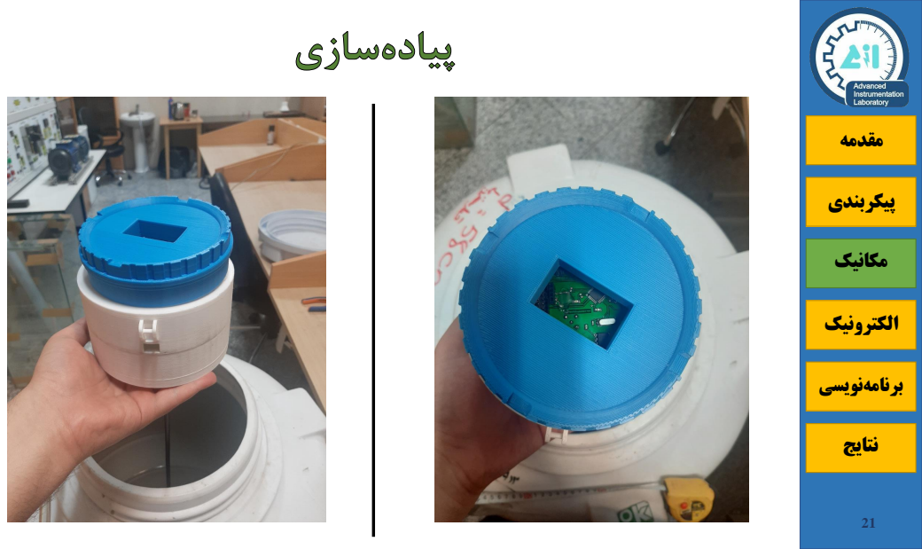
[picture p33: page 22]
پیکربندی; مکانیک; الکترونیک; برنامه نویسی; نتایج

# مقدمه

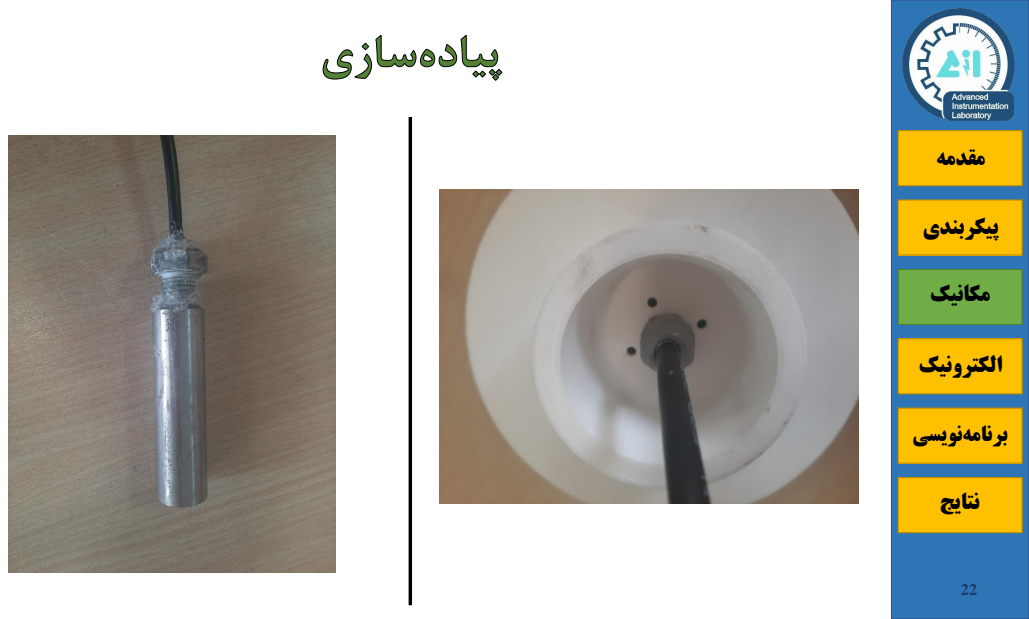
[picture p34: page 23]
پیکربندی; مکانیک; الکترونیک; برنامه نویسی; نتایج

# مقدمه

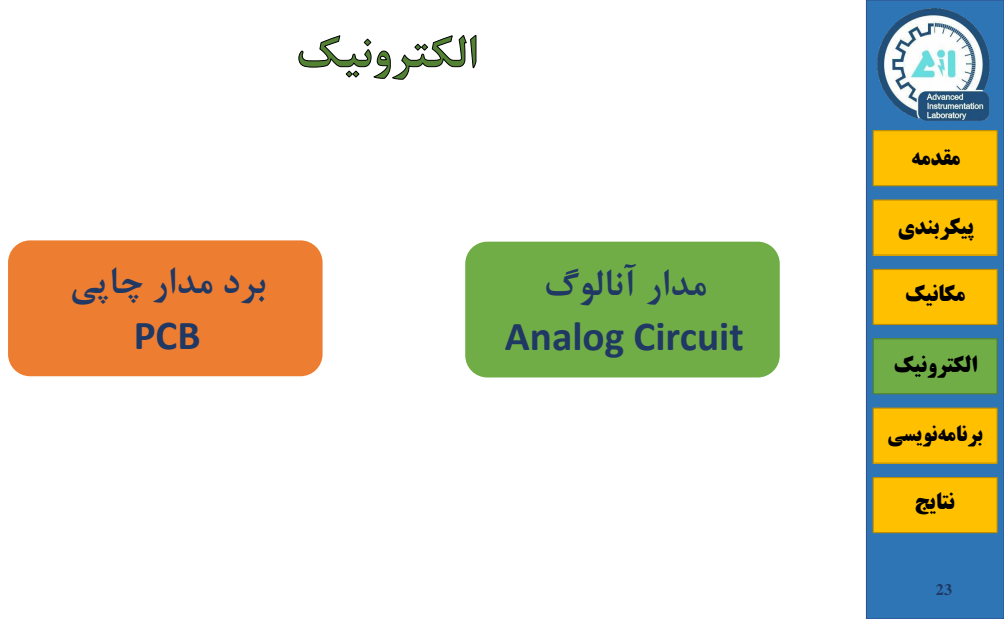
[picture p35: page 24]
پیکربندی; مکانیک; الکترونیک; برنامه نویسی; نتایج; مدار آنالوگ Analog Circuit

برد مدار چاپی
PCB

# مقدمه

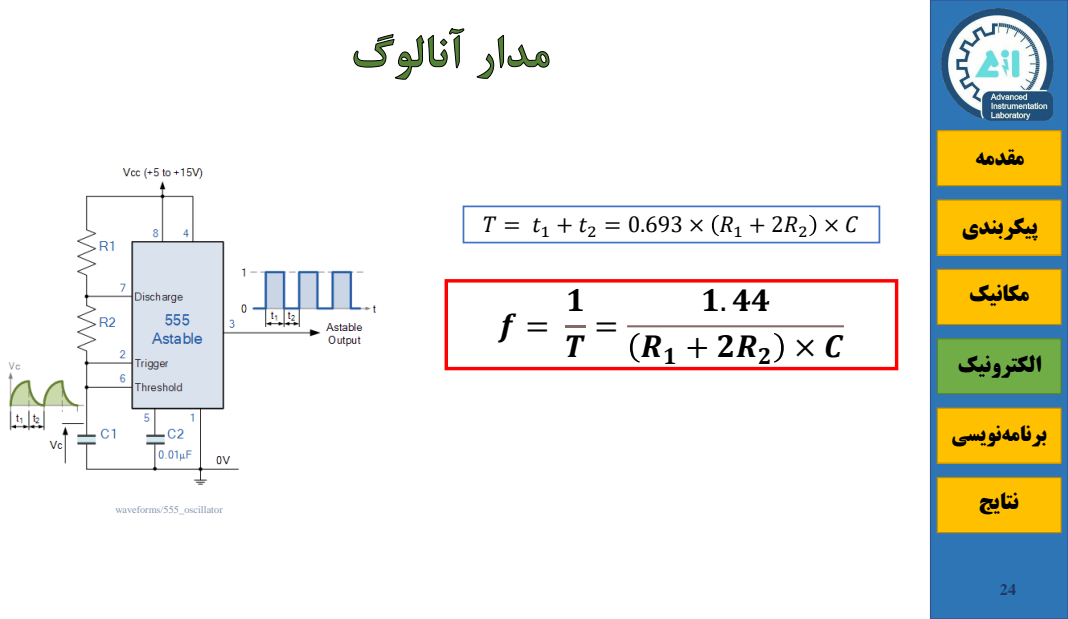
[picture p36: page 25]
پیکربندی; مکانیک; الکترونیک; برنامه نویسی; نتایج; waveforms/555_oscillator

# مقدمه

# T = t1 + t2 = 0.693 × R1 + 2R2 × C

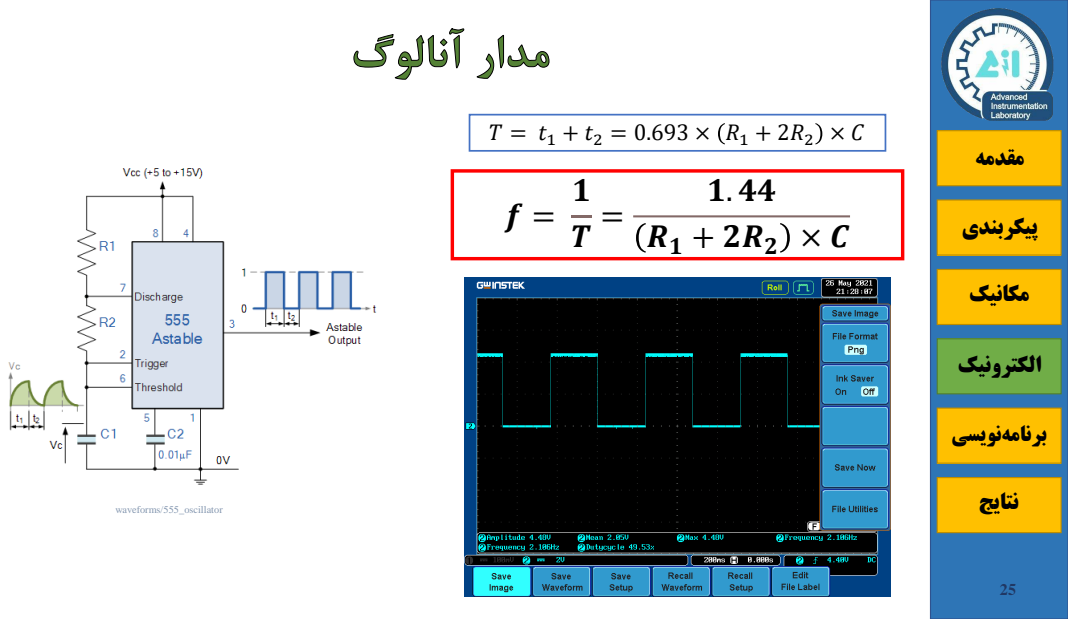
[picture p37: page 26]
پیکربندی; مکانیک; الکترونیک; برنامه نویسی; نتایج; waveforms/555_oscillator

# مقدمه

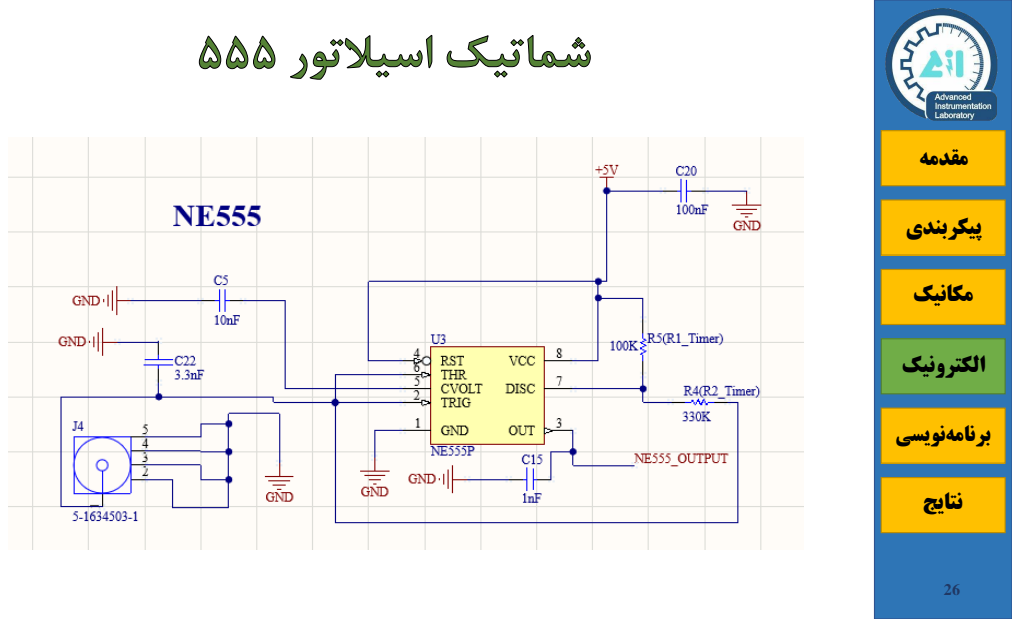
[picture p38: page 27]
پیکربندی; مکانیک; الکترونیک; برنامه نویسی; نتایج

# مقدمه

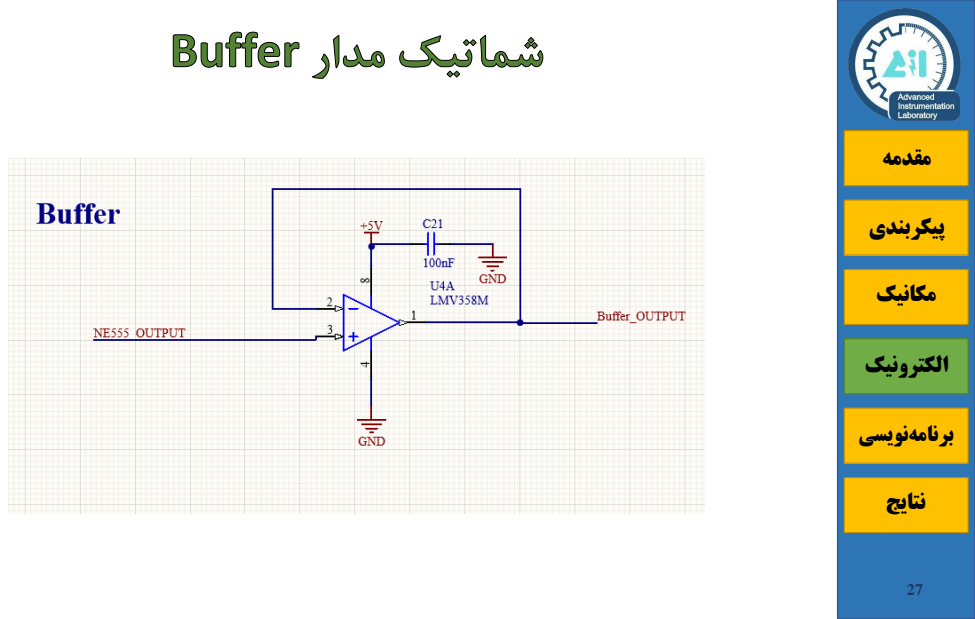
[picture p39: page 28]
پیکربندی; مکانیک; الکترونیک; برنامه نویسی; نتایج

# مقدمه

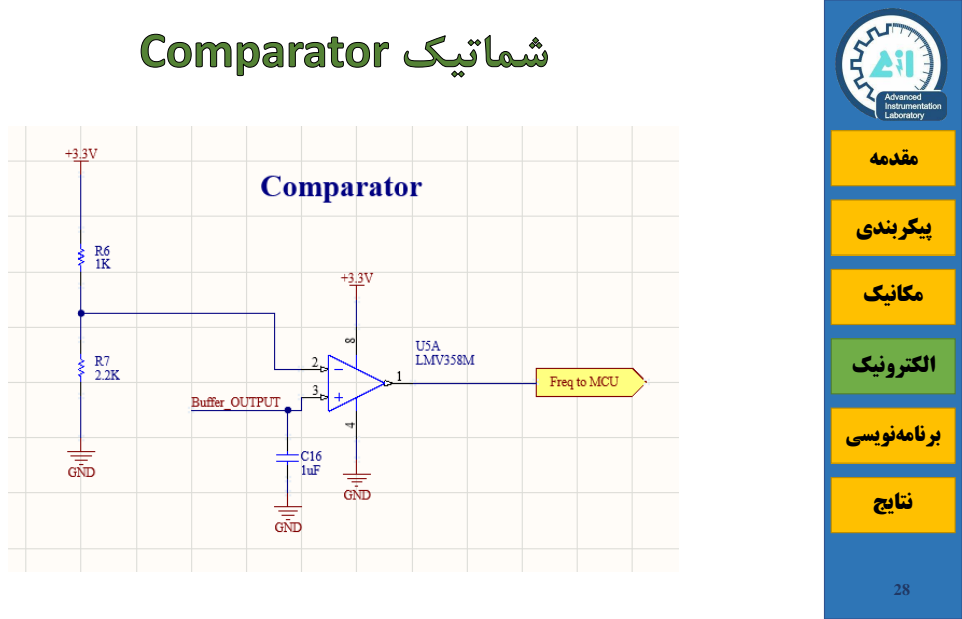
[picture p40: page 29]
پیکربندی; مکانیک; الکترونیک; برنامه نویسی; نتایج

# مقدمه

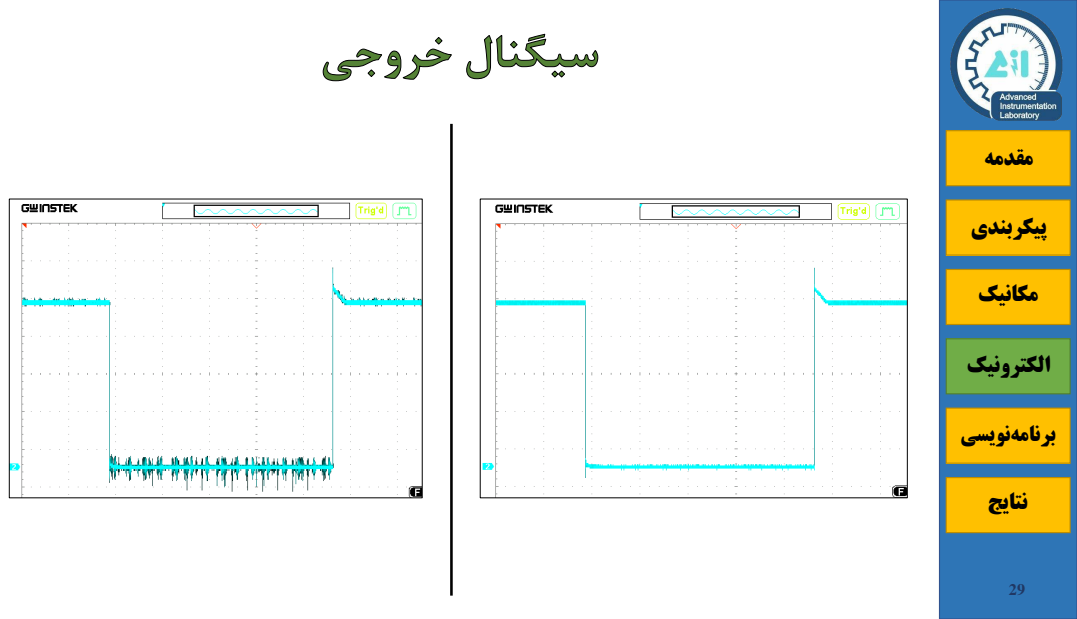
[picture p41: page 30]
پیکربندی; مکانیک; الکترونیک; برنامه نویسی; نتایج

# مقدمه

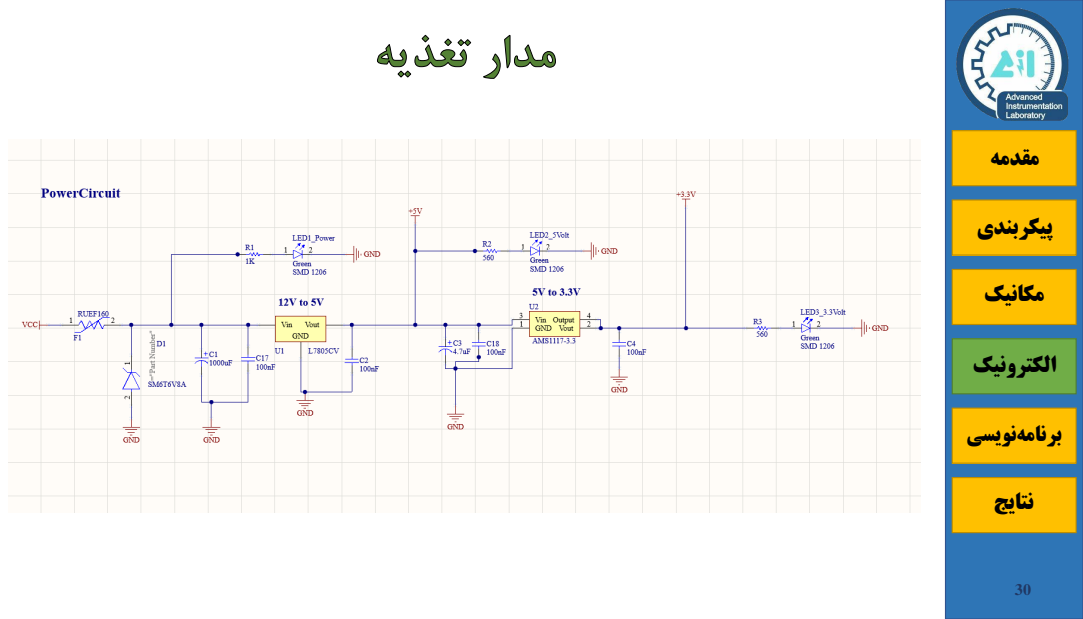
[picture p42: page 31]
پیکربندی; مکانیک; الکترونیک; برنامه نویسی; نتایج

# مقدمه

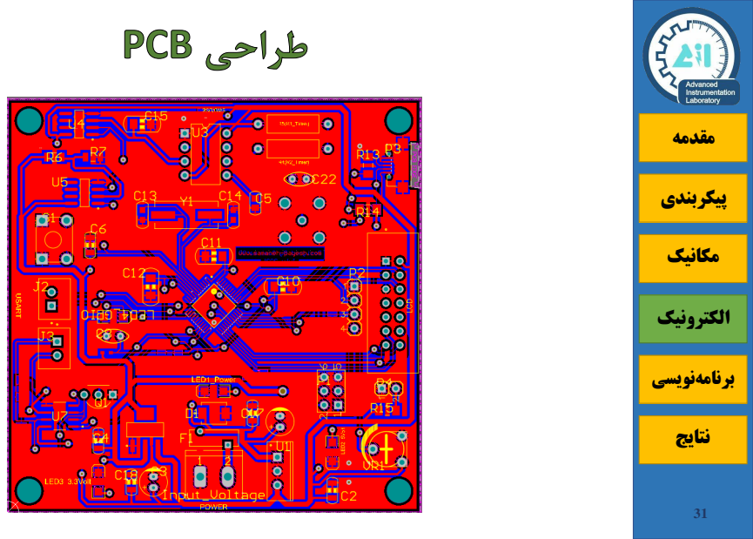
[picture p43: page 32]
پیکربندی; مکانیک; الکترونیک; برنامه نویسی; نتایج

# مقدمه

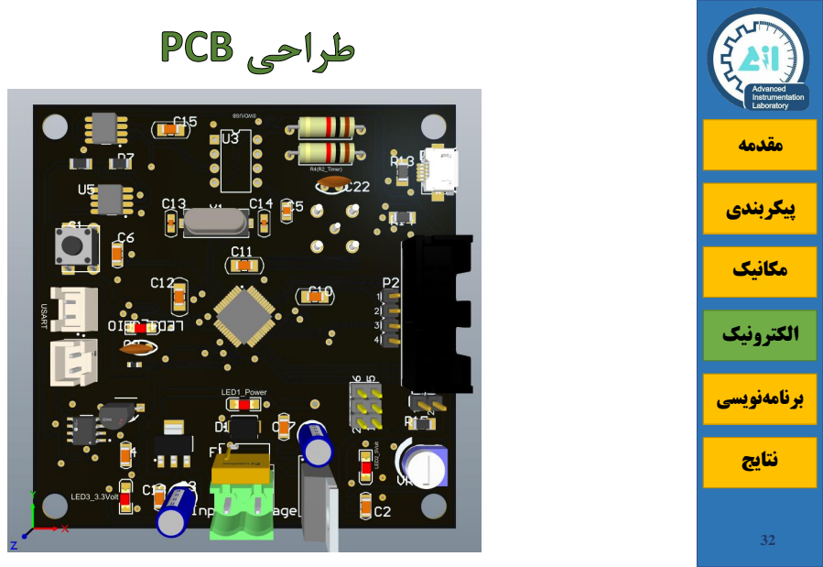
[picture p44: page 33]
پیکربندی; مکانیک; الکترونیک; برنامه نویسی; نتایج

# مقدمه

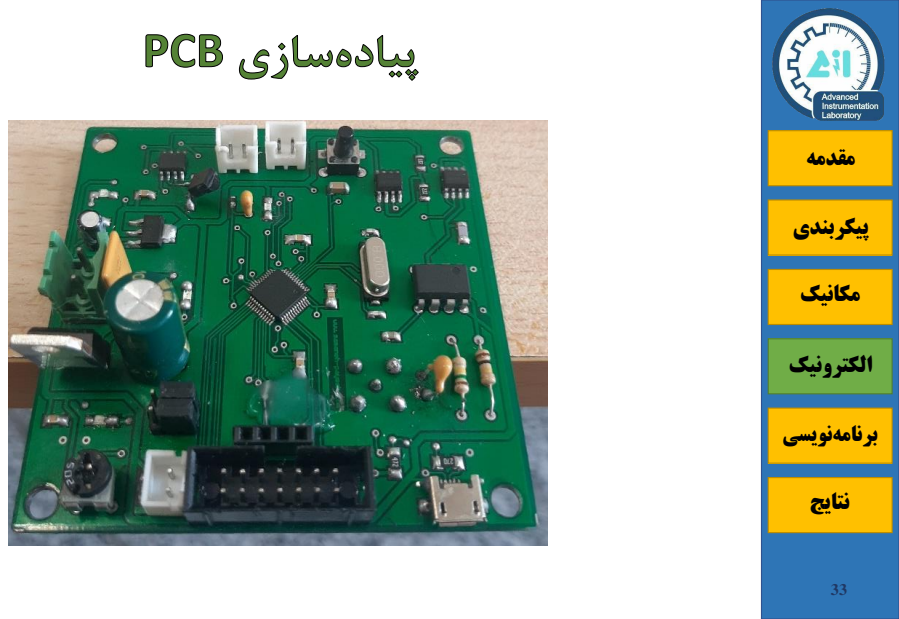
[picture p45: page 34]
پیکربندی; مکانیک; الکترونیک; برنامه نویسی; نتایج

# مقدمه

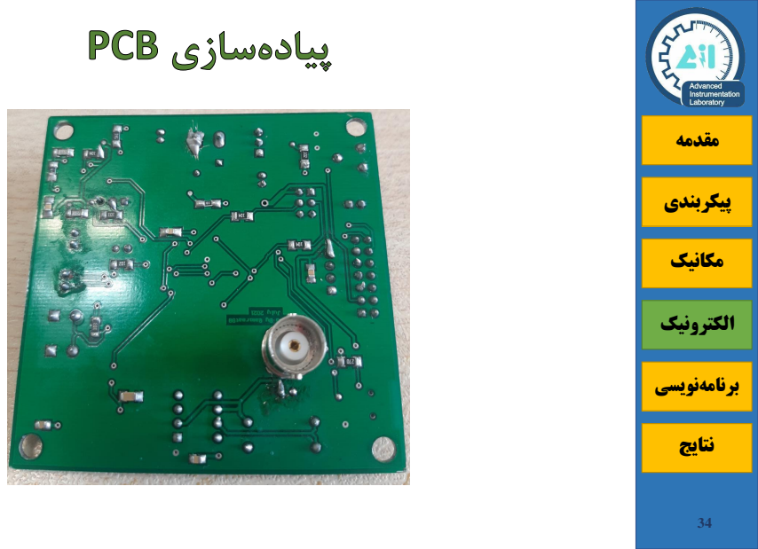
[picture p46: page 35]
پیکربندی; مکانیک; الکترونیک; برنامه نویسی; نتایج

# مقدمه

# Arm Cortex-M3 - STM32F103CBT6

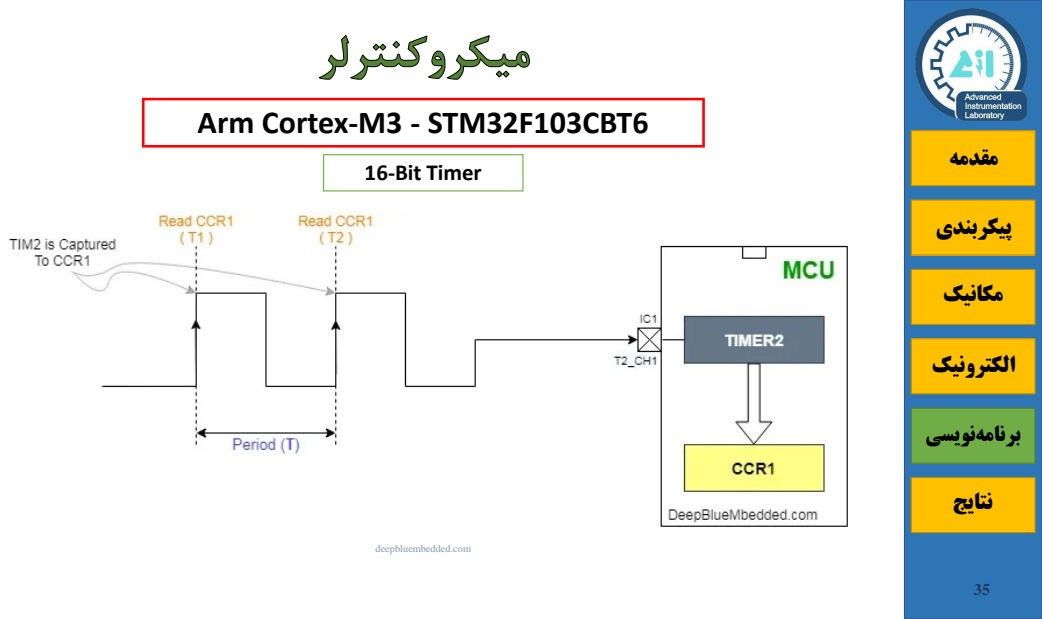
[picture p47: page 36]
پیکربندی; مکانیک; الکترونیک; برنامه نویسی; نتایج; deepbluembedded.com; 16-Bit Timer

# مقدمه

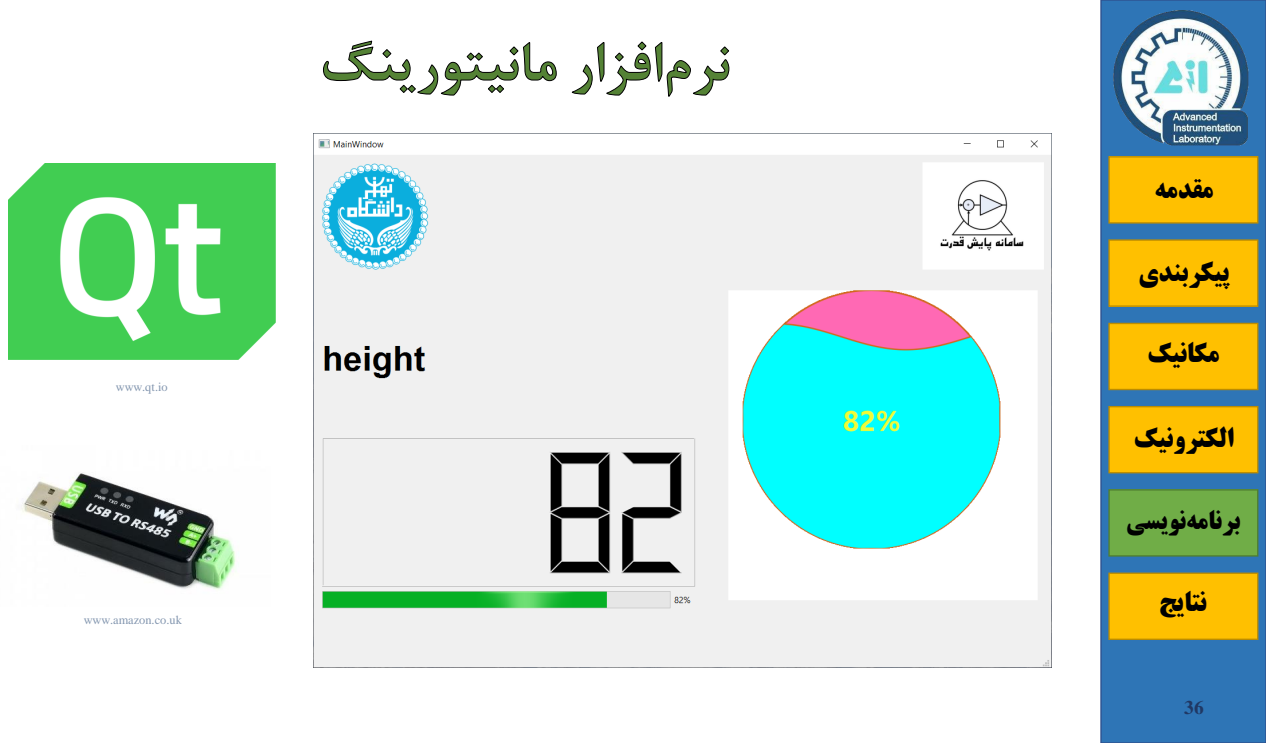
[picture p48: page 37]
پیکربندی; مکانیک; برنامه نویسی; الکترونیک; نتایج

www.qt.io

www.amazon.co.uk

# مقدمه

# تست عملکرد خازن کابل کواکسیال

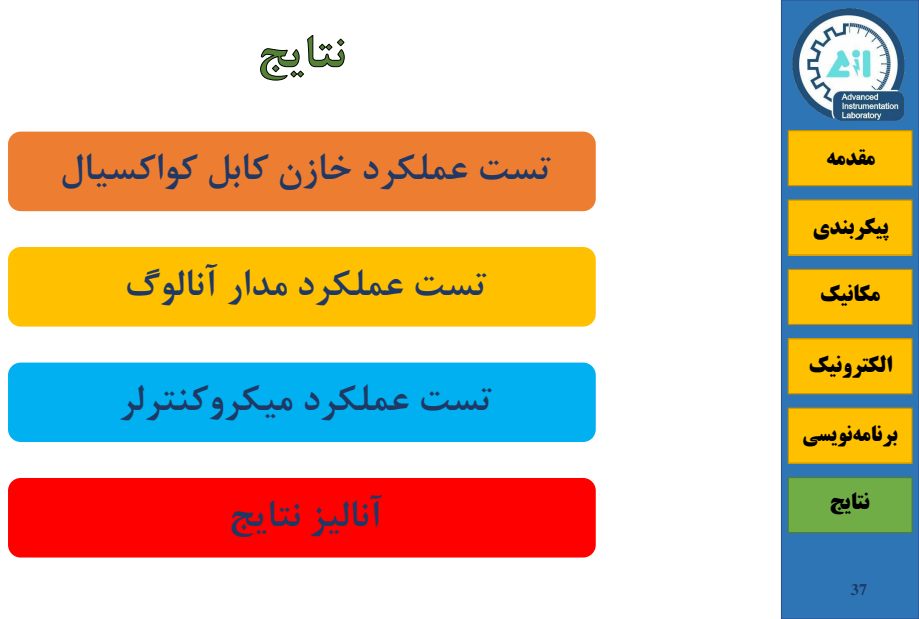
[picture p49: page 38]
پیکربندی; مکانیک; الکترونیک; برنامه نویسی; نتایج; آنالیز نتایج

تست عملکرد مدار آنالوگ

تست عملکرد میکروکنترلر

# مقدمه

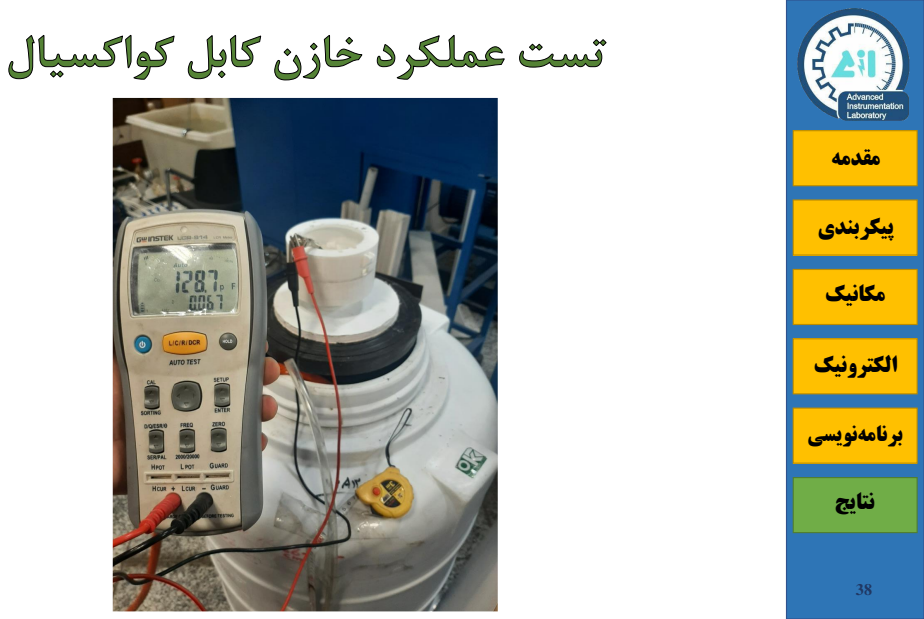
[picture p50: page 39]
پیکربندی; مکانیک; الکترونیک; برنامه نویسی; نتایج

# مقدمه

## C_Coaxial_Cable

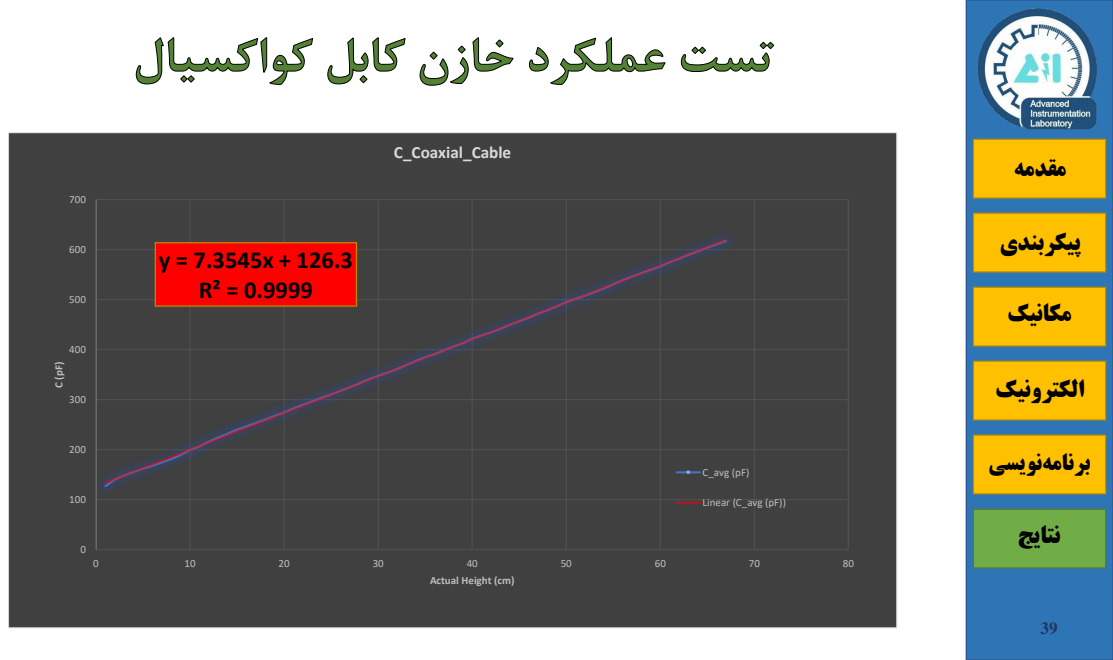
[picture p51: page 40]
پیکربندی; مکانیک; برنامه نویسی; الکترونیک; نتایج

C_avg (pF)

Linear (C_avg (pF))

Actual Height (cm)

# مقدمه

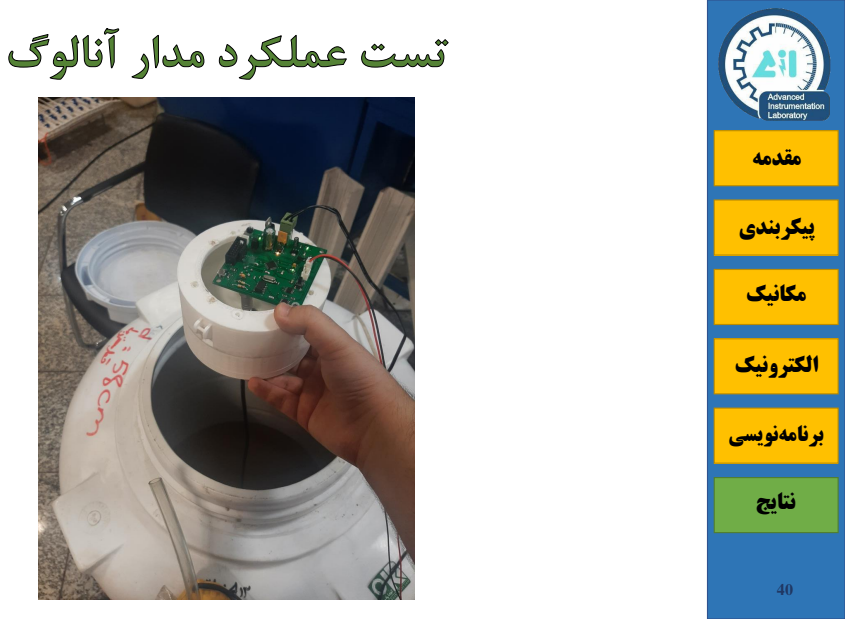
[picture p52: page 41]
پیکربندی; مکانیک; الکترونیک; برنامه نویسی; نتایج

# مقدمه

# بیرون از مخزن

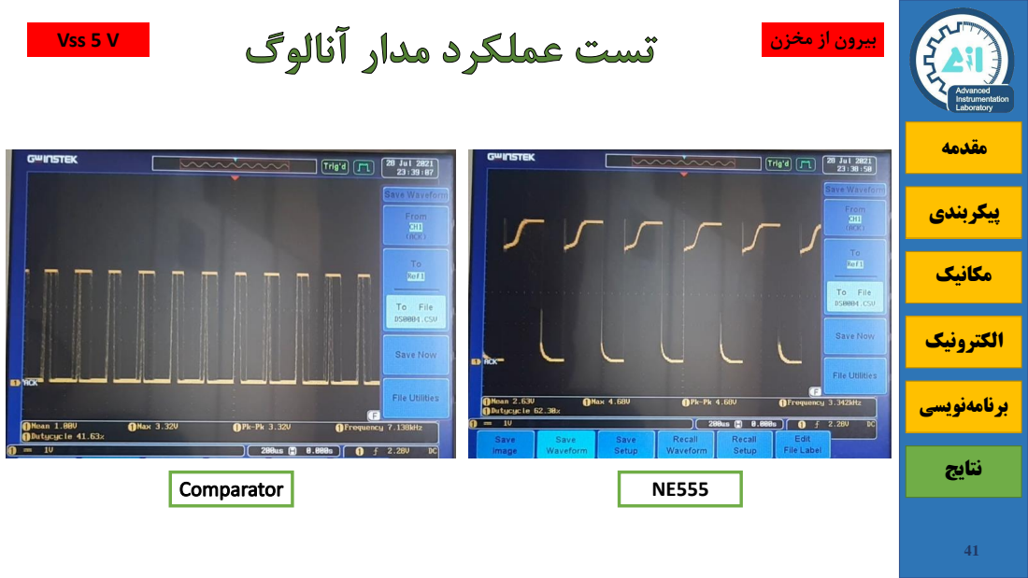
[picture p53: page 42]
پیکربندی; مکانیک; برنامه نویسی; الکترونیک; نتایج; Vss 5

# مقدمه

# داخل مخزن

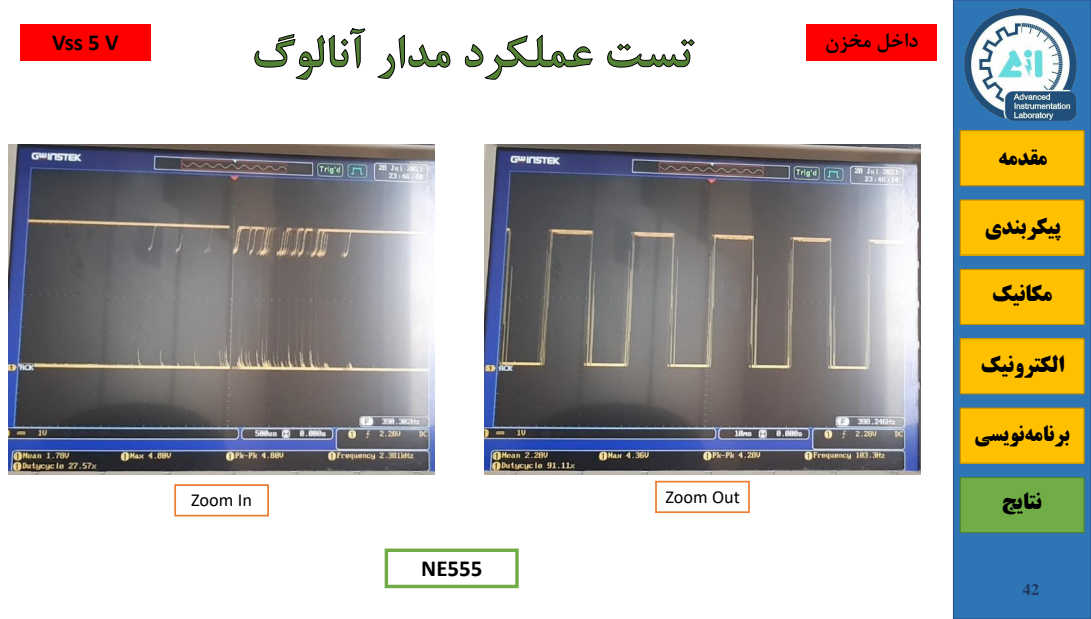
[picture p54: page 43]
پیکربندی; مکانیک; الکترونیک; برنامه نویسی; نتایج; Zoom In; Zoom Out; Vss 5 V

# مقدمه

# Vss 12 V

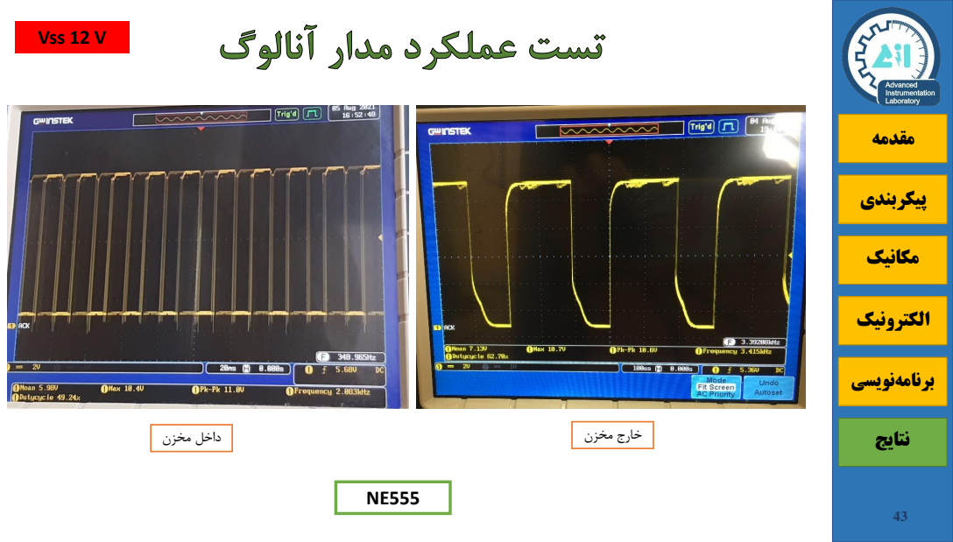
[picture p55: page 44]
پیکربندی; مکانیک; الکترونیک; برنامه نویسی; نتایج

خارج مخزن داخل مخزن

# مقدمه

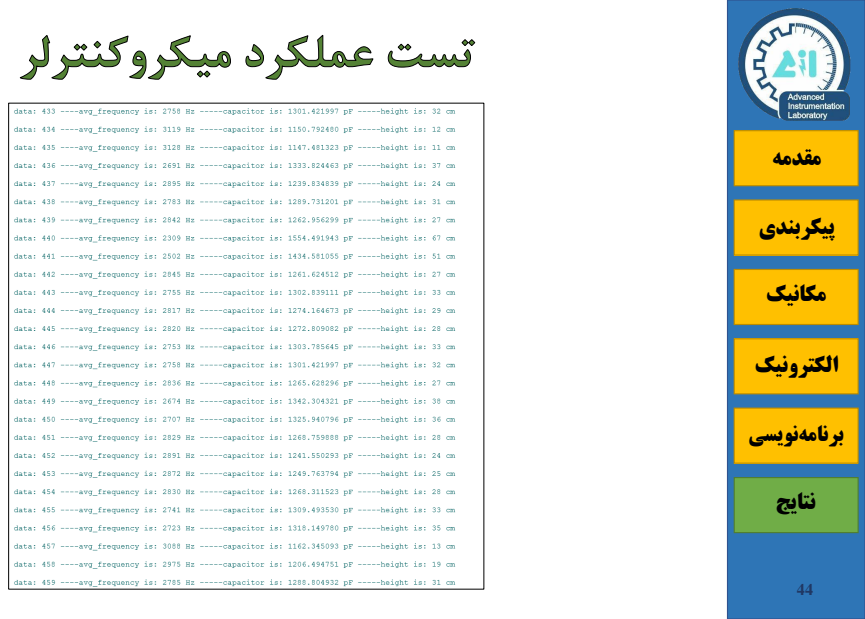
[picture p56: page 45]
پیکربندی; مکانیک; الکترونیک; برنامه نویسی; نتایج

# مقدمه

## non linearity Error %

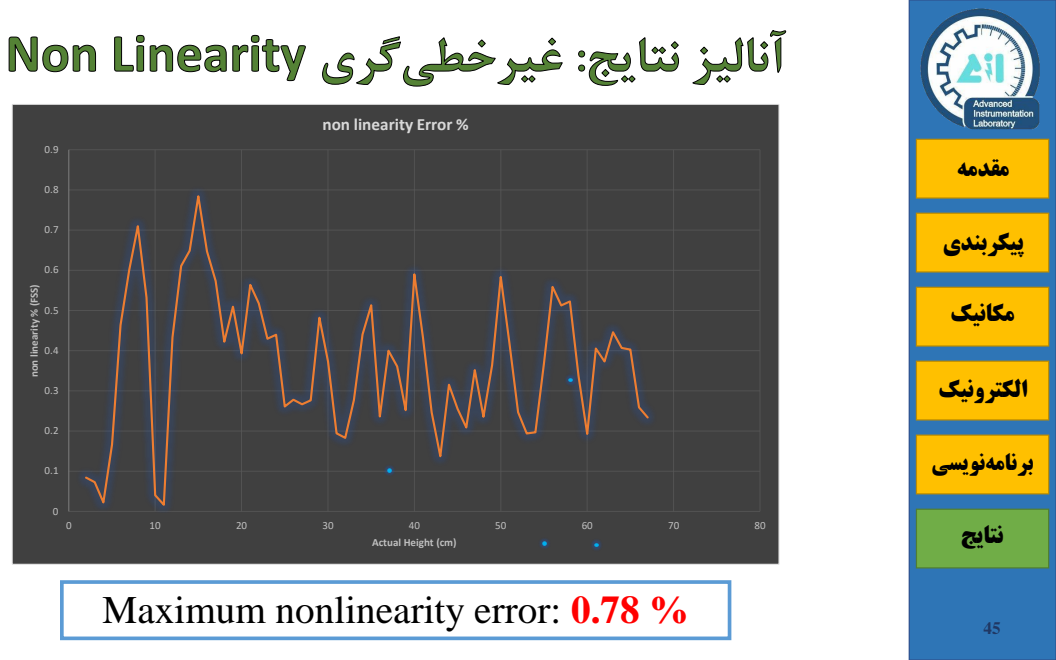
[picture p57: page 46]
پیکربندی; مکانیک; الکترونیک; برنامه نویسی; نتایج

non linearity % (FSS)

Actual Height (cm)

Maximum nonlinearity error: 0.78 %

# مقدمه

y = 7. 3545x + 126. 3

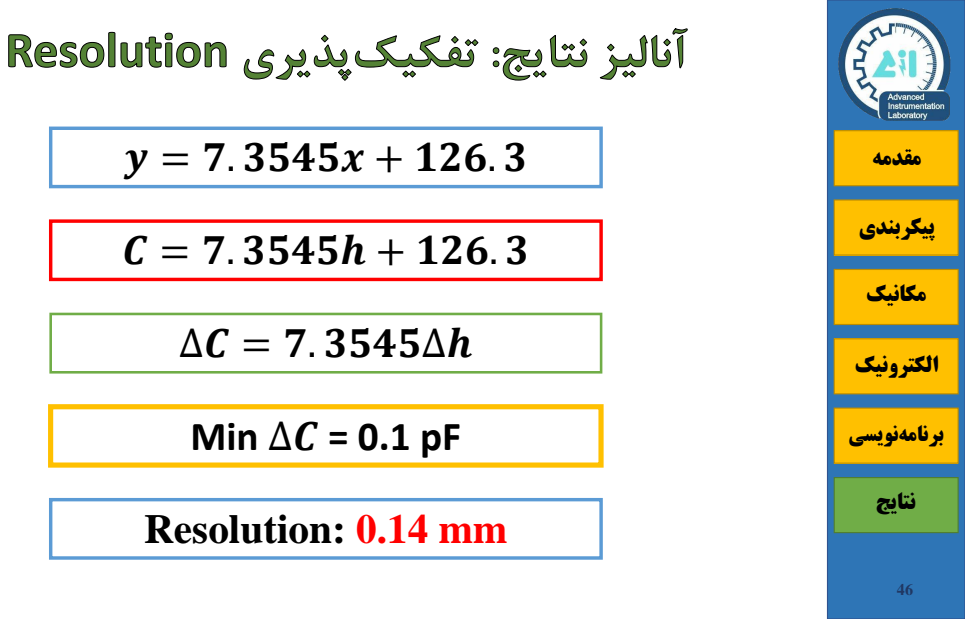
[picture p58: page 47]
پیکربندی; مکانیک; الکترونیک; برنامه نویسی; نتایج; Resolution: 0.14 mm; Min ∆C = 0.1 pF

# مقدمه

## repeatability %

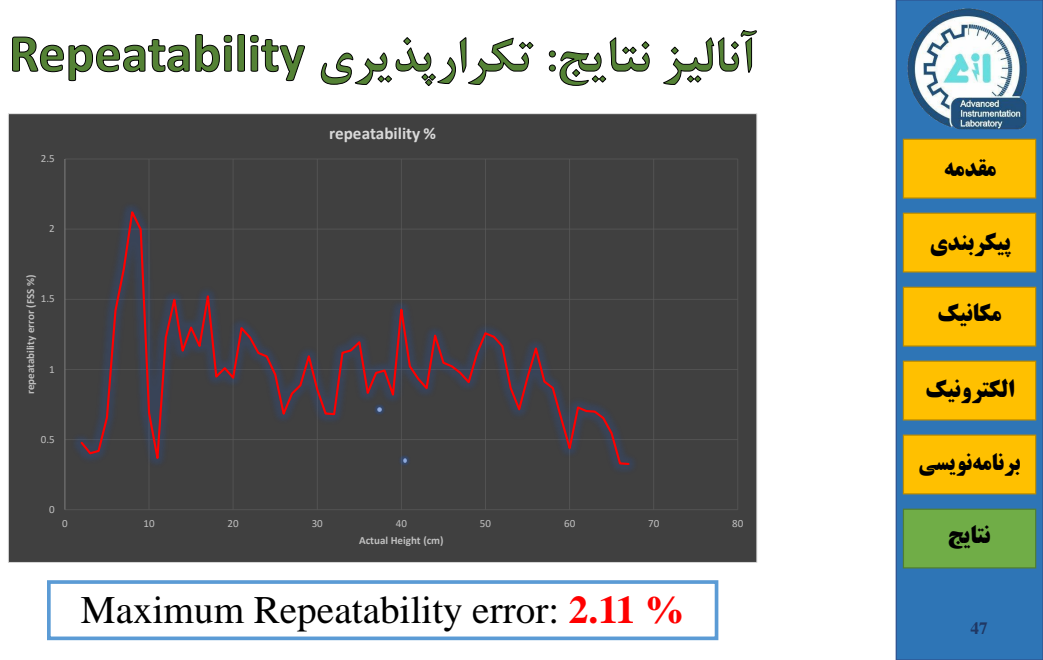
[picture p59: page 48]
پیکربندی; مکانیک; الکترونیک; برنامه نویسی; نتایج; Maximum Repeatability error:

repeatability error (FSS %)

Actual Height (cm)

# مقدمه

## hysteresis

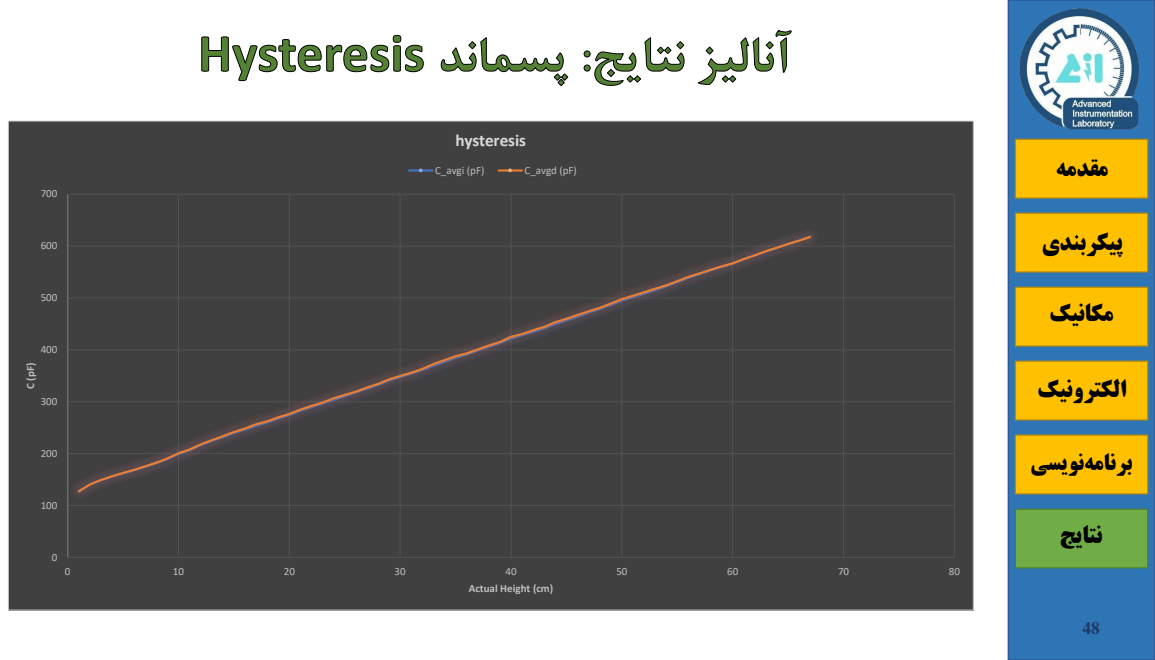
[picture p60: page 49]
پیکربندی; مکانیک; برنامه نویسی; الکترونیک; نتایج; C_avgi (pF); C_avgd (pF)

Actual Height (cm)

# مقدمه

## hysteresis %

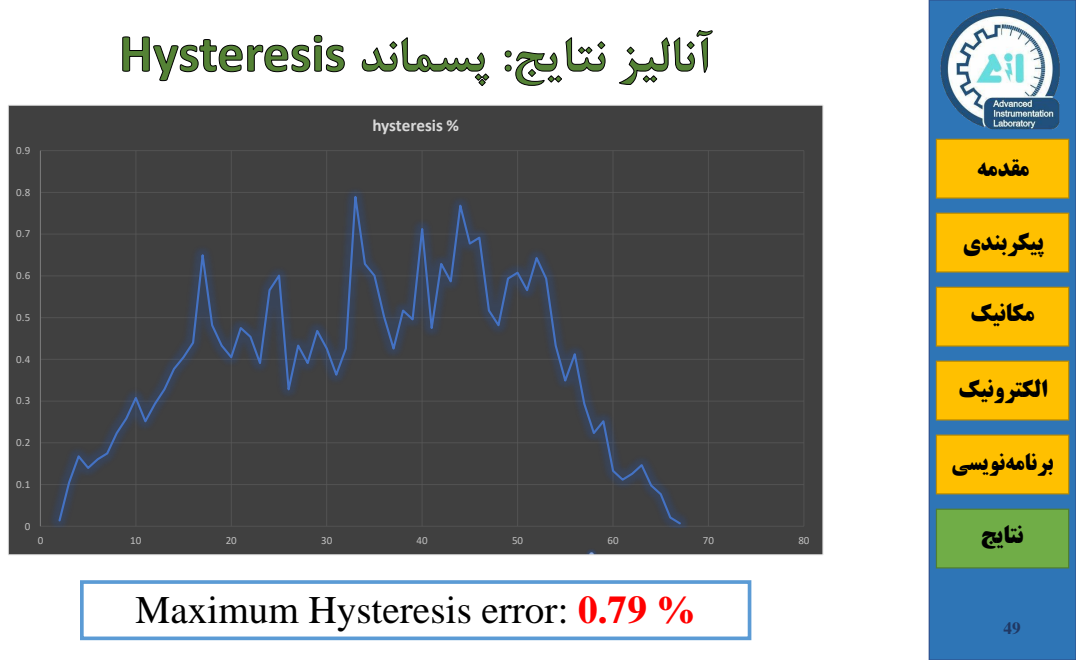
[picture p61: page 50]
پیکربندی; مکانیک; الکترونیک; برنامه نویسی; نتایج

Maximum Hysteresis error: 0.79 %

# مقدمه

∂C

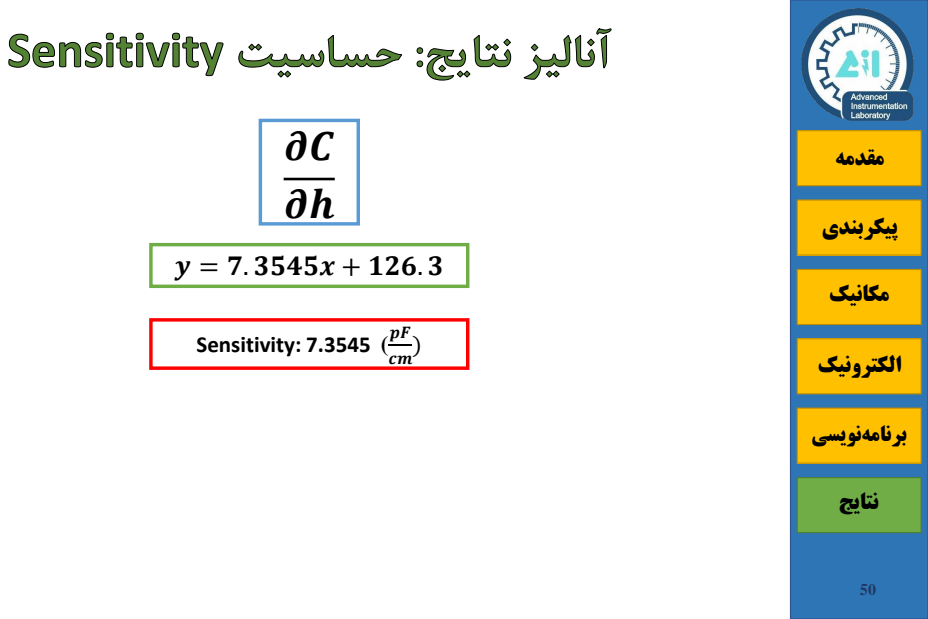
[picture p62: page 51]
پیکربندی; مکانیک; برنامه نویسی; الکترونیک; نتایج; Sensitivity: 7.3545

# مقدمه

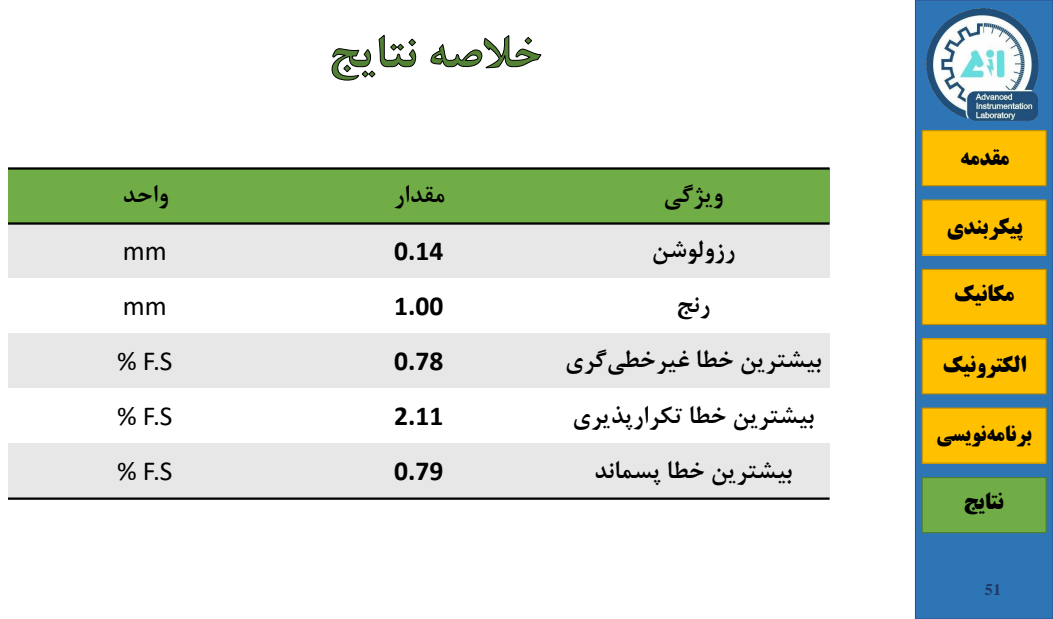
[picture p63: page 52]
پیکربندی; مکانیک; برنامه نویسی; الکترونیک; نتایج

ویژگی مقدار واحد
رزولوشن 0.14 mm

رنج 1.00 mm
بیشترین خطا غیرخطی گری 0.78 S.F %
بیشترین خطا تکرار پذیری 2.11 S.F %
بیشترین خطا پسماند 0.79 S.F %

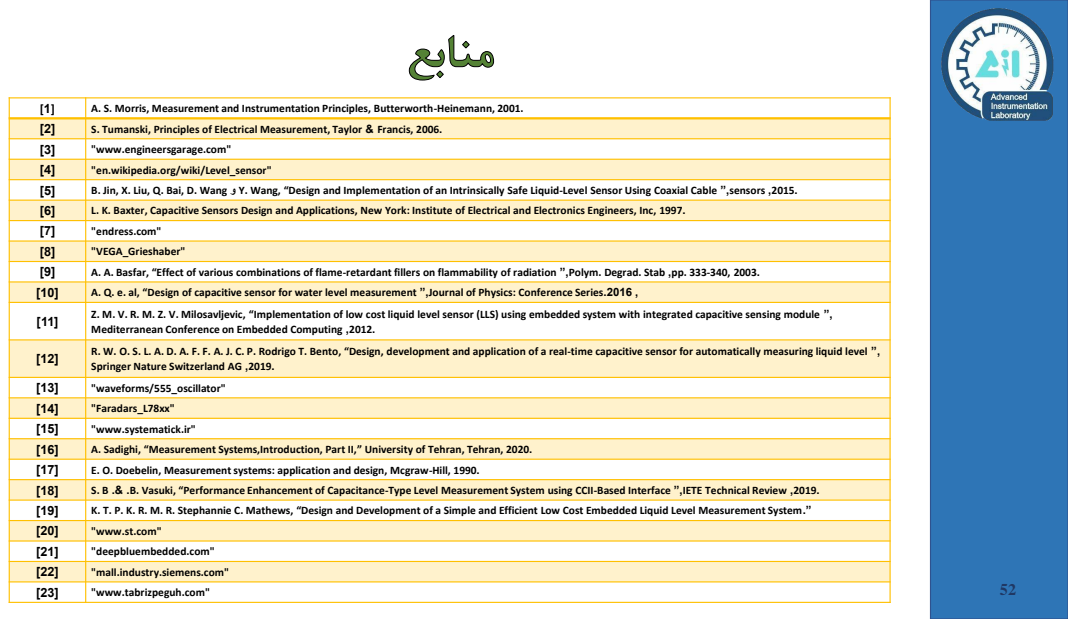
[picture p64: page 53]

[1] A. S. Morris, Measurement and Instrumentation Principles, Butterworth-Heinemann, 2001.
]2[ | S. Tumanski, Principles of Electrical Measurement, Taylor & Francis, 2006.
]3[ | "www.engineersgarage.com"
]4[ | "en.wikipedia.org/wiki/Level_sensor"
]5[ | B. Jin, X. Liu, Q. Bai, D. Wang و Y. Wang, “Design and Implementation of an Intrinsically Safe Liquid-Level Sensor Using Coaxial Cable ”,sensors ,2015.
]6[ | L. K. Baxter, Capacitive Sensors Design and Applications, New York: Institute of Electrical and Electronics Engineers, Inc, 1997.
]7[ | "endress.com"
]8[ | "VEGA_Grieshaber"
]9[ | A. A. Basfar, “Effect of various combinations of flame-retardant fillers on flammability of radiation ”,Polym. Degrad. Stab ,pp. 333-340, 2003.
]10[ | A. Q. e. al, “Design of capacitive sensor for water level measurement ”,Journal of Physics: Conference Series.2016 ,
]11[ | Z. M. V. R. M. Z. V. Milosavljevic, “Implementation of low cost liquid level sensor (LLS) using embedded system with integrated capacitive sensing module ”, Mediterranean Conference on Embedded Computing ,2012.

]12[ | R. W. O. S. L. A. D. A. F. F. A. J. C. P. Rodrigo T. Bento, “Design, development and application of a real-time capacitive sensor for automatically measuring liquid level ”, Springer Nature Switzerland AG ,2019.

]13[ | "waveforms/555_oscillator"
]14[ | "Faradars_L78xx"
]15[ | "www.systematick.ir"
]16[ | A. Sadighi, “Measurement Systems,Introduction, Part II,” University of Tehran, Tehran, 2020.
]17[ | E. O. Doebelin, Measurement systems: application and design, Mcgraw-Hill, 1990.
]18[ | S. B .& .B. Vasuki, “Performance Enhancement of Capacitance-Type Level Measurement System using CCII-Based Interface ”,IETE Technical Review ,2019.
]19[ | K. T. P. K. R. M. R. Stephannie C. Mathews, “Design and Development of a Simple and Efficient Low Cost Embedded Liquid Level Measurement System.”
]20[ | "www.st.com"
]21[ | "deepbluembedded.com"
]22[ | "mall.industry.siemens.com"
]23[ | "www.tabrizpeguh.com"

# با تشکر از توجه شما

53

# matin.amirmahdi@ut.ac.ir
