amirmat98/Capacitive-Level-Meter-Sensor/Solid/3D_Print_Case/Body-version2.pdf

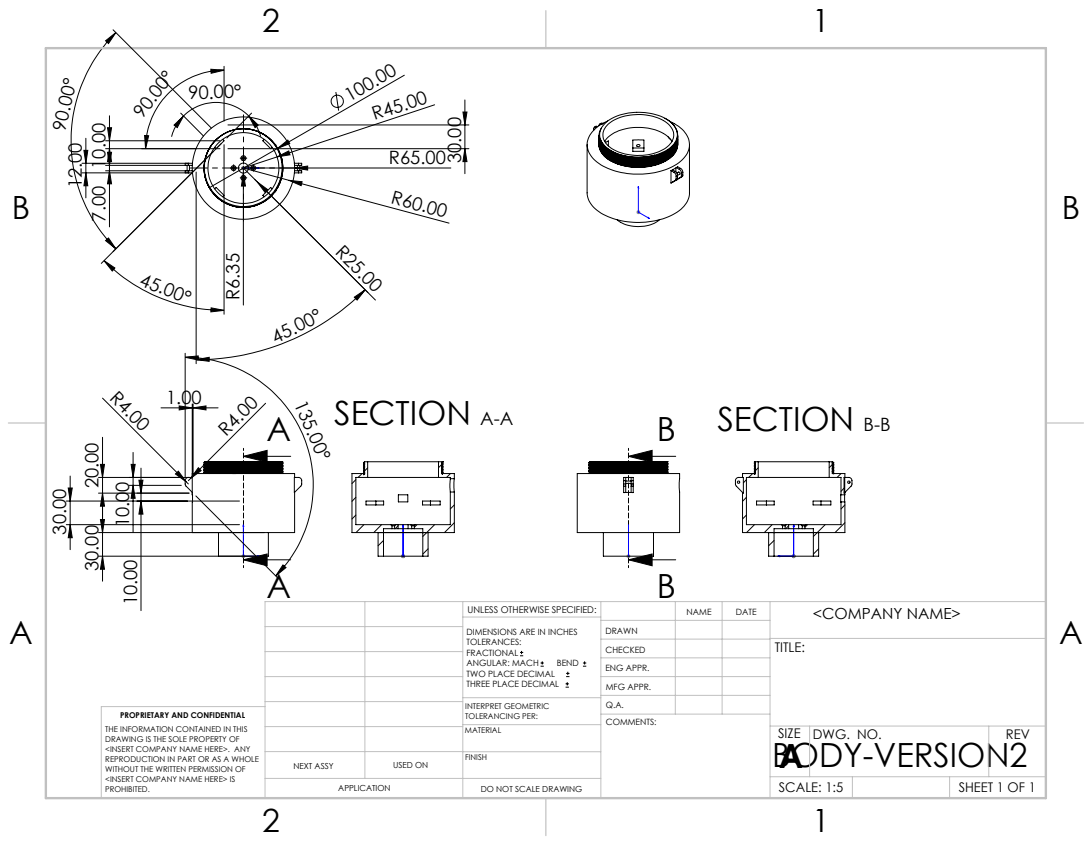
[picture p65: page 1]
SECTION A-A; SECTION B-B

UNLESS OTHERWISE SPECIFIED: | | NAME | DATE | <COMPANY NAME>
DIMENSIONS ARE IN INCHES TOLERANCES: FRACTIONAL ANGULAR: MACH BEND TWO PLACE DECIMAL THREE PLACE DECIMAL | DRAWN

CHECKED | | | TITLE:

ENG APPR.
MFG APPR.

INTERPRET GEOMETRIC TOLERANCING PER: | Q.A.

PROPRIETARY AND CONFIDENTIAL
THE INFORMATION CONTAINED IN THIS
DRAWING IS THE SOLE PROPERTY OF
<INSERT COMPANY NAME HERE>. ANY
REPRODUCTION IN PART OR AS A WHOLE
WITHOUT THE WRITTEN PERMISSION OF
<INSERT COMPANY NAME HERE> IS
PROHIBITED.

USED ON | MATERIAL | | SIZE BODY-VERSION2 A | DWG. NO. | REV

NEXT ASSY | | FINISH

APPLICATION | DO NOT SCALE DRAWING | | SCALE: 1:5 | | SHEET 1 OF 1
