amirmat98/Capacitive-Level-Meter-Sensor/Main_PCB_V1/Project Outputs for Main_PCB/AssemblyDrawing.pdf

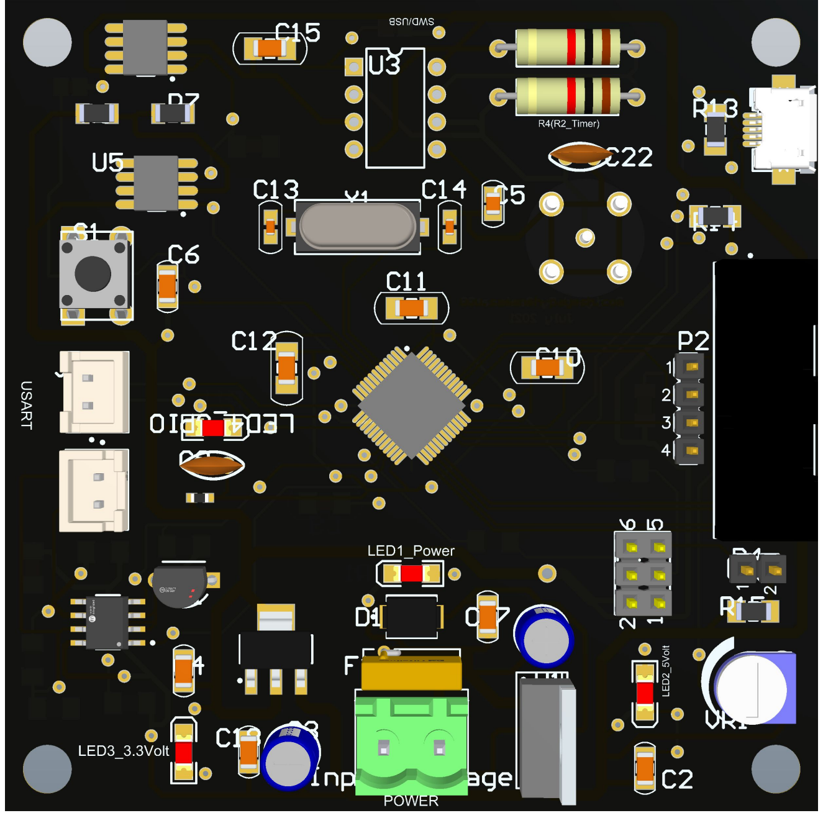
[picture p67: page 1]

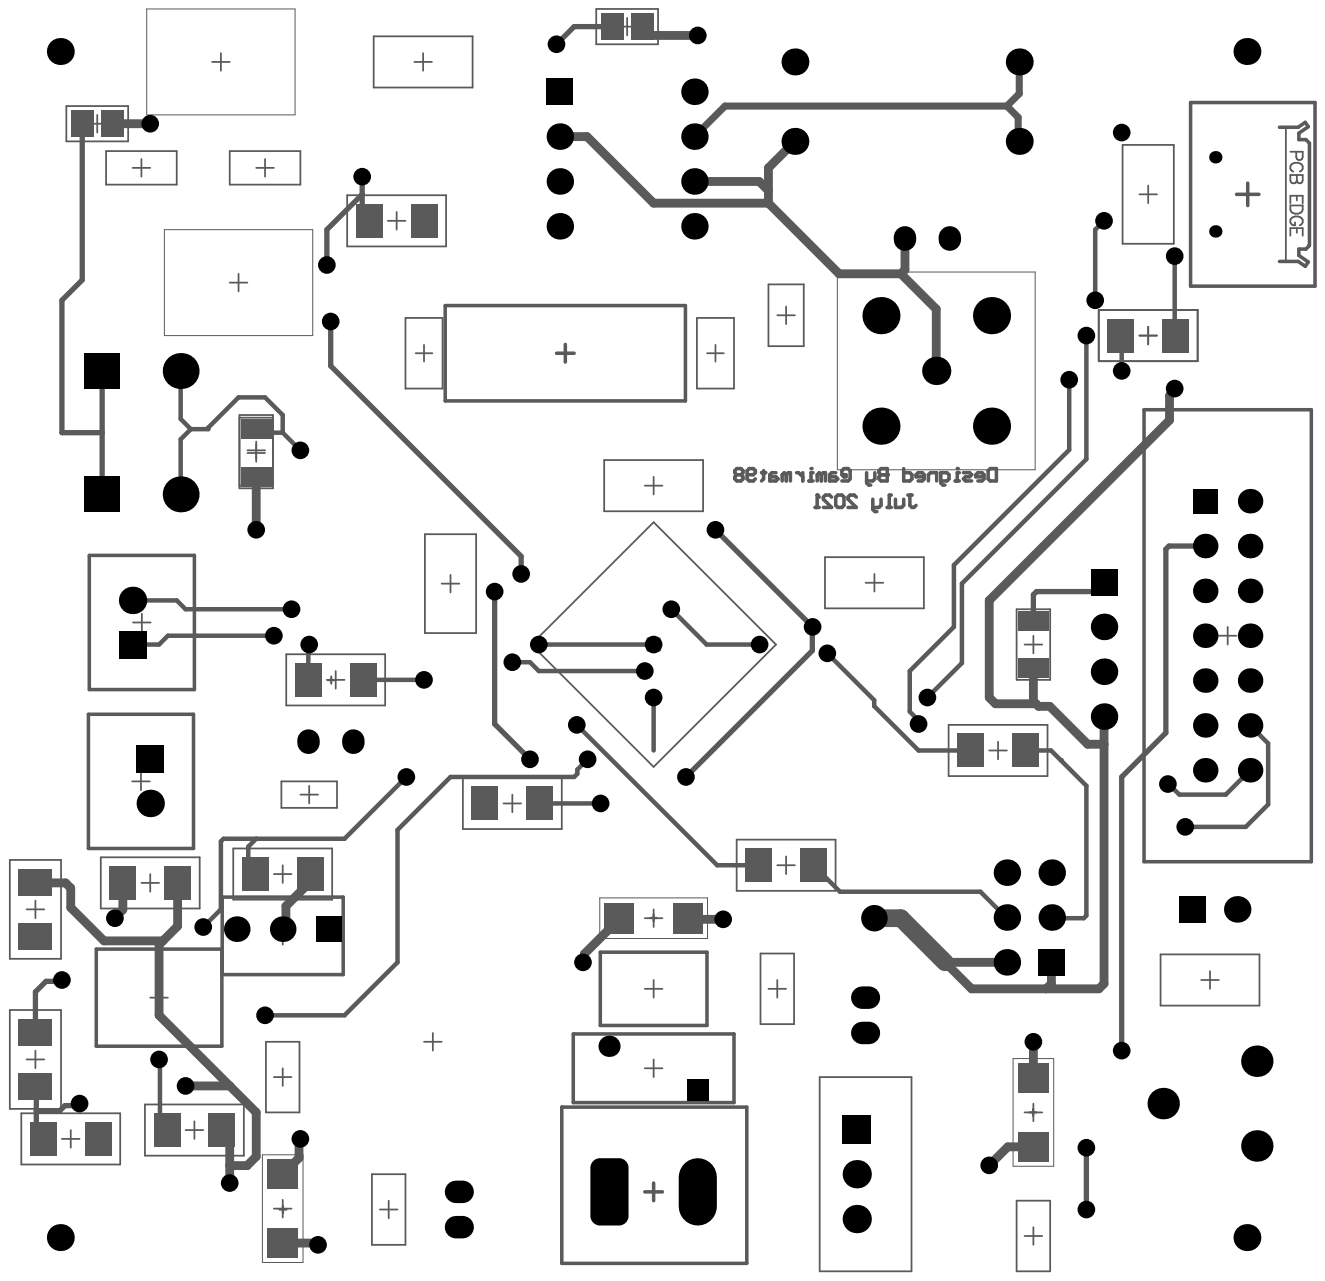
[picture p68: page 2]

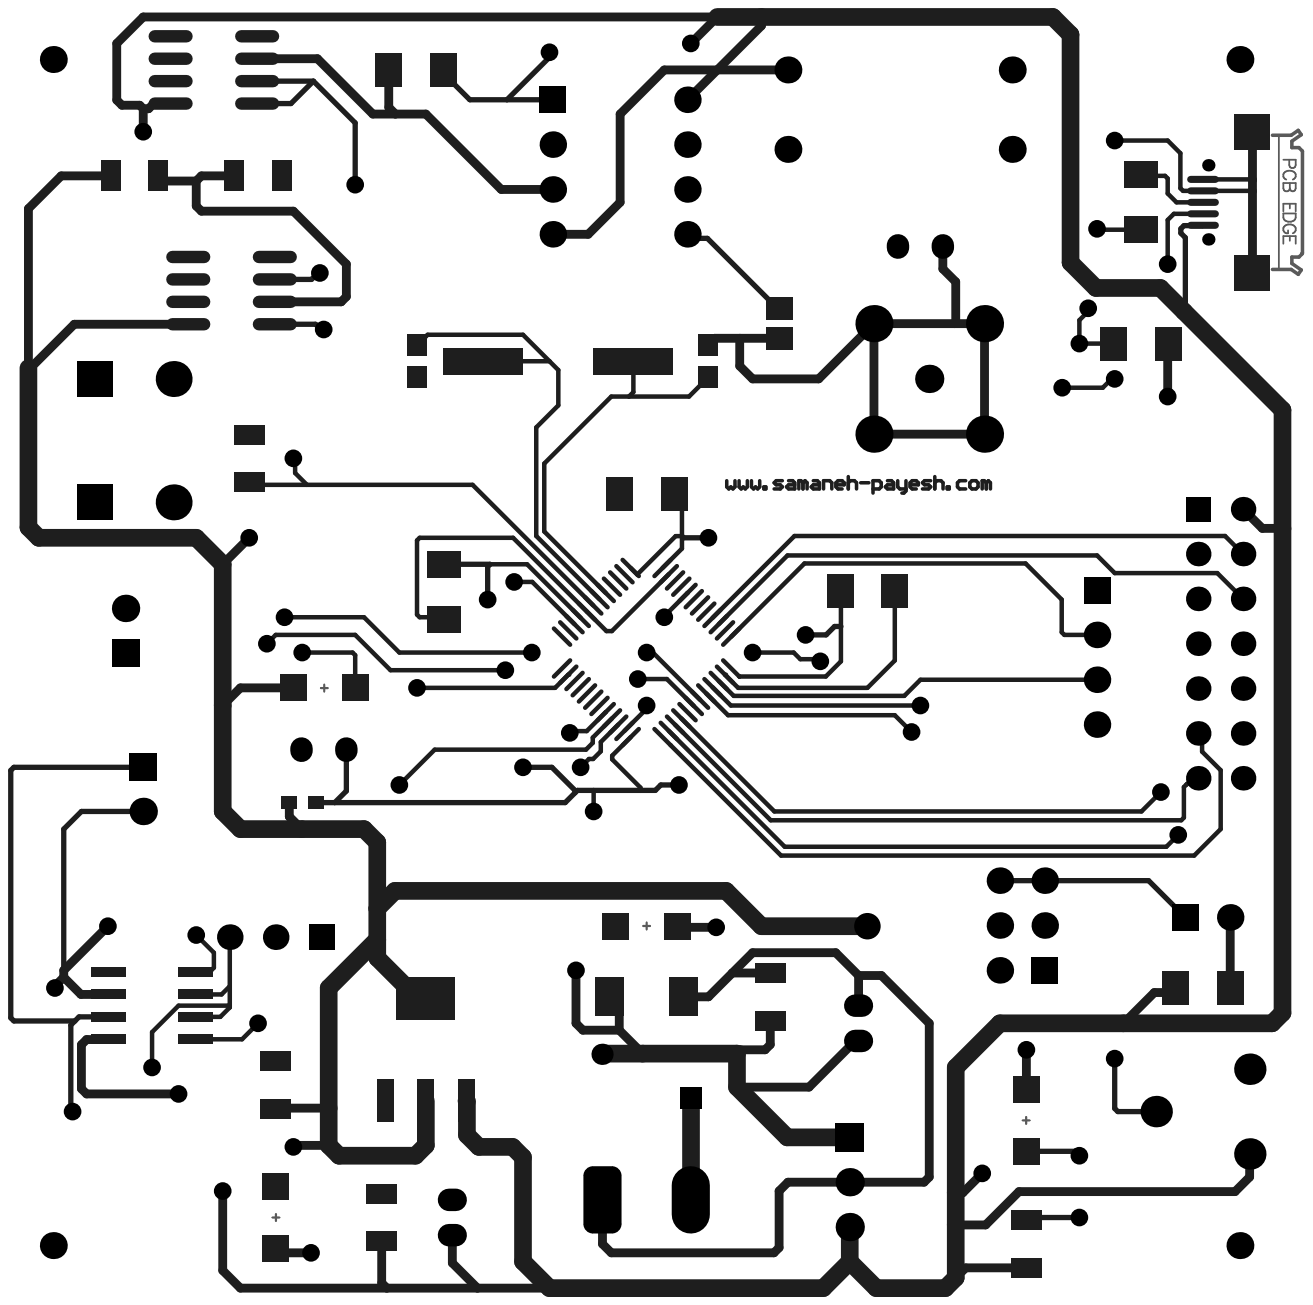
[picture p69: page 3]
