amirmat98/Capacitive-Level-Meter-Sensor/(list of files, drawings)

Other design files:
Main_PCB_V1/Main_Board.SchDoc
Main_PCB_V1/Main_PCB.PrjPcb
Main_PCB_V1/MCU.SchDoc
Main_PCB_V1/Power.SchDoc
Main_PCB_V1/Project Outputs for Main_PCB/BOM/PCB4.PcbDoc
Main_PCB_V1/Project Outputs for Main_PCB/Universal Exporter/PCB4.PcbDoc
Main_PCB_V1/Timer555.SchDoc
