amirmat98/Capacitive-Level-Meter-Sensor/ARM_code/Main_Test/Core/Src/main.c

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
/* Includes ------------------------------------------------------------------*/
#include "main.h"

/* USER CODE BEGIN Includes */

#include <stdio.h>
#include <stdlib.h>
#include <math.h>
#include "lcd16x2.h"

/* USER CODE END Includes */

/* USER CODE BEGIN PD */

#define IDLE   0
#define DONE   1
#define F_CLK  72000000UL
//#define TIM2_ARR 65536
const uint8_t TIM2_ARR = 2;
//#define Timer2_PSC 2
const uint8_t Timer_PSC = 2;
//const uint32_t R1 = 100*1000;
const uint32_t R1 = 96.95*1000;
//const uint32_t R2 = 150*1000;
const uint32_t R2 = 152.12*1000;
//const uint32_t const_Cap = 3300;
const uint32_t const_Cap = 970;
const float cap_0 = 90.97;
const float first_term_landa = 731.97;



/* USER CODE END PD */

TIM_HandleTypeDef htim2;

UART_HandleTypeDef huart1;
UART_HandleTypeDef huart3;

void SystemClock_Config(void);
static void MX_GPIO_Init(void);
static void MX_TIM2_Init(void);
static void MX_USART1_UART_Init(void);
static void MX_USART3_UART_Init(void);
/* USER CODE BEGIN 0 */

//Printf Function BEGIN
#ifdef __GNUC__
#define PUTCHAR_PROTOTYPE int __io_putchar(int ch)
#else
#define PUTCHAR_PROTOTYPE int fputc(int ch, FILE *f)
#endif 
PUTCHAR_PROTOTYPE
{
  HAL_UART_Transmit(&huart3, (uint8_t *)&ch, 1, 0xFFFF);
  return ch;
}
//Printf Function END

//Comperator Function BEGIN
int cmpfunc (const void * a, const void * b) 
{
   return ( *(uint32_t*)a - *(uint32_t*)b );
}
//Comperator Function END

//Variables BEGIN
volatile uint8_t State = IDLE;
volatile uint32_t T1 = 0;
volatile uint32_t T2 = 0;
volatile uint32_t ticks = 0;
volatile uint16_t TIM2_OVC = 0;
volatile uint32_t freq = 0;
volatile uint32_t temp_freq = 0;
volatile uint32_t used_freq = 0;
volatile uint32_t frequency = 0;
volatile uint32_t sum_frequency = 0;
volatile uint32_t avg_frequency = 0;
volatile uint32_t data_index = 0;
volatile uint8_t indexer = 0;
volatile uint8_t buffer_index = 0;
uint32_t freq_buffer[5];
uint32_t freq_avg[100];
volatile uint8_t avg_index = 0;
volatile float capacitor = 0;
volatile float height = 0;
//Variables END


float Calc_Cap ( uint32_t input_freq )
{
	uint32_t resistor = ( R1 + 2*R2 );
	float cap = (1.44 * pow(10,12) ) / ( input_freq * resistor );
	return cap;
}

float Calc_Height ( float input_cap )
{
	float landa =  (input_cap - const_Cap - cap_0) / first_term_landa;
	return landa*100 ;
}


/* USER CODE END 0 */

/**
  * @brief  The application entry point.
  * @retval int
  */
int main(void)
{
  /* MCU Configuration--------------------------------------------------------*/

  /* Reset of all peripherals, Initializes the Flash interface and the Systick. */
  HAL_Init();

  /* Configure the system clock */
  SystemClock_Config();

  /* Initialize all configured peripherals */
  MX_GPIO_Init();
  MX_TIM2_Init();
  MX_USART1_UART_Init();
  MX_USART3_UART_Init();
  /* USER CODE BEGIN 2 */
	
	//Timer Start BEGIN
	HAL_TIM_Base_Start_IT(&htim2);
	HAL_TIM_IC_Start_IT(&htim2,TIM_CHANNEL_1);
	//Timer Start END
	
	//LCD Init BEGIN
	//lcd16x2_init_4bits(RS_GPIO_Port,RS_Pin,E_Pin,D4_GPIO_Port,D4_Pin,D5_Pin,D6_Pin,D7_Pin);
	//lcd16x2_printf("Hello");
	//HAL_Delay(10000);
	//LCD Init END
	
	
	
	
	

  /* USER CODE END 2 */

  /* Infinite loop */
  /* USER CODE BEGIN WHILE */
  while (1)
  {
		used_freq = temp_freq;
		//printf("Used_Freq is: %d Hz ----- \n\r" , used_freq);
		
		
		freq_buffer [buffer_index] = used_freq;
		HAL_Delay(1);
		buffer_index++;
		
		if ( buffer_index == 5 )
		{
			qsort(freq_buffer, 5, sizeof(int), cmpfunc);
			frequency =  ( ( freq_buffer[1] + freq_buffer[2] + freq_buffer[3] ) / 3 );
			//freq_avg[avg_index] = frequency;
			sum_frequency += frequency;
			avg_index++;
			
			if ( avg_index == 100 )
			{
				data_index++;
				printf("data: %d ----" , data_index);
				avg_frequency = sum_frequency/100;
				printf("avg_frequency is: %d Hz -----" , avg_frequency);
				capacitor = Calc_Cap ( avg_frequency );
				height = Calc_Height ( capacitor );
				printf("capacitor is: %f pF -----" , capacitor);
				printf("height is: %d cm \n\r" , (int)height);
				avg_index = 0;
				sum_frequency = 0;
				HAL_GPIO_TogglePin(LED_GPIO_Port,LED_Pin);
				HAL_Delay(50);
			}
				
			//printf("frequency is: %d Hz -----" , frequency);
			//capacitor = Calc_Cap ( frequency );
			//height = Calc_Height ( capacitor );
			//printf("capacitor is: %f pF -----" , capacitor);
			//printf("height is: %d cm \n\r" , (int)height);
			
			buffer_index = 0;
			uint8_t i = 0;
			while ( i < 5 )
			{
				freq_buffer [i] = 0;
				i++;
			}
		}
		
		
		

		
		//lcd16x2_1stLine();
		//lcd16x2_printf("Temp_Freq is: %f \n\r" , Temp_Freq);
		//lcd16x2_printf("Hello Amir!! \n\r");
		
		
		
		//lcd16x2_clear();
		
    /* USER CODE END WHILE */

    /* USER CODE BEGIN 3 */
  }
  /* USER CODE END 3 */
}

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
/* USER CODE BEGIN 4 */

//Input Capture BEGIN

void HAL_TIM_IC_CaptureCallback(TIM_HandleTypeDef* htim)
{
	if (State == IDLE)
	{
		T1 = TIM2->CCR1;
		TIM2_OVC = 0;
		State = DONE;
	}
	else if(State == DONE)
	{
		T2 = TIM2->CCR1;
		ticks = ( T2 + ( TIM2_OVC * TIM2_ARR ) ) - T1;
		freq = ( (F_CLK/Timer_PSC) /ticks );
		
		if(freq != 0)
		{
			temp_freq = freq;
			indexer++;
		}
		State = IDLE;
	}
}

//Input Capture END

//OVC TIMER BEGIN

void HAL_TIM_PeriodElapsedCallback(TIM_HandleTypeDef* htim)
{
	TIM2_OVC++;
}

//OVC TIMER END

/* USER CODE END 4 */
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
