amirmat98/Capacitive-Level-Meter-Sensor/ARM_code/Main_Test/Core/Inc/main.h

#define LED_Pin GPIO_PIN_4
#define LED_GPIO_Port GPIOA
#define D4_Pin GPIO_PIN_12
#define D4_GPIO_Port GPIOB
#define D5_Pin GPIO_PIN_13
#define D5_GPIO_Port GPIOB
#define D6_Pin GPIO_PIN_14
#define D6_GPIO_Port GPIOB
#define D7_Pin GPIO_PIN_15
#define D7_GPIO_Port GPIOB
#define E_Pin GPIO_PIN_3
#define E_GPIO_Port GPIOB
#define RS_Pin GPIO_PIN_4
#define RS_GPIO_Port GPIOB
