amirmat98/Capacitive-Level-Meter-Sensor/(commit log)

2024-11-13 add Main PCB altium design
    [Assembly Testpoint Report for PCB4.csv, MCU.SchDoc, Main_Board.SchDoc, Main_PCB.PrjPcb, PCB4.PcbDoc, PCB4.xls, PCB4.xlsx, Pick Place for PCB4.csv]
2024-11-13 add ARM STM32 code
2024-11-14 add soildworks files as drawing case of sensor
    [Assem.SLDASM, Body-version2.SLDDRW, Body-version2.SLDPRT, Body-version2.STEP, Body-version2.STL, Body.SLDDRW, Body.SLDPRT, BodyCap-version2.SLDDRW]
